MomoRC-tech/Becker-AR6201-to-OpenSoar/cad/reference/README.md

# CAD downloads and credits

Download the component models and check their original sources and reuse terms before sharing them.

| Model | Creator or supplier and original source | Reuse |
| --- | --- | --- |
| [AMASS XT30U, XT30PB and XT30PW](amass-xt30-family/README.md) | PENNEL Patrice · [GrabCAD](https://grabcad.com/library/amass-xt30-connector-family-xt30u-xt30pb-xt30pw-1) | GrabCAD guidance below |
| [ESP32-DevKitC V4](esp32-devkitc-v4/README.md) | Andrei Golyakov · [GrabCAD](https://grabcad.com/library/esp32-devkitc-v4-1) | GrabCAD guidance below |
| [MINI MAX3232 RS-232 module](rs232-uart-ttl-mini-max3232/README.md) | Yuriy B · [GrabCAD](https://grabcad.com/library/rs232-uart-ttl-mini-max3232-1) | GrabCAD guidance below |
| [Hobbywing UBEC 3A MAX 5A](ubec-hobbywing-3a/README.md) | Vinícius Leite · [GrabCAD](https://grabcad.com/library/hobbywing-ubec-3a-max-5a-1) | GrabCAD guidance below |
| [Standalone AMASS XT30U-M](xt30u-m/README.md) | [MuratovAS’s KiCadLibrary](https://github.com/MuratovAS/KiCadLibrary/blob/ba6956a3ba9bc0938dced1b2eb1ae00a33c9a255/MAS_3DModel/xt30u-m.step) | [Apache 2.0](xt30u-m/LICENSE) |
| [DIN0204 axial resistors](kicad-din0204/README.md) | KiCad community · [Resistor_THT library](https://kicad.github.io/packages3d/Resistor_THT.html) | [CC BY-SA 4.0 with the KiCad library exception](kicad-din0204/LICENSE.md) |
| [9-pin D-sub female plug](dsub-9pin/DSUB_9pin_female_plug.STEP) and [straight backshell](dsub-9pin/DSUB_9pin_backshell.STEP) | Manufacturer CAD, renamed and metadata removed; origin: S43 and S52 in [sources](../../docs/research/sources.md#source-register) | Public redistribution permission unverified |
| [MAX490 RS-422 module](rs422-to-ttl-max490/README.md) | Project model based on reference photos | See the model notes for its intended use |

For non-commercial public sharing, GrabCAD asks you to credit the creator and link to the original model. Commercial use requires the creator’s explicit permission. [GrabCAD sharing guidance](https://help.grabcad.com/article/246-how-can-models-be-used-and-shared)
