MomoRC-tech/Becker-AR6201-to-OpenSoar/cad/reference/ubec-hobbywing-3a/README.md

# Hobbywing UBEC 3A MAX 5A

Unmodified model by **Vinícius Leite**, supplied by the project owner as `hobbywing-ubec-3a-max-5a-1.snapshot.2.zip`. [Original GrabCAD model](https://grabcad.com/library/hobbywing-ubec-3a-max-5a-1)

- Open the [STEP model](Hobbywing%20UBEC%203A%20MAX%205A.step) in CAD software.
- The SolidWorks part, Parasolid file and preview are also preserved unchanged.
- See [housing](../../../docs/hardware/housing.md#contents) for dimensions and S44 in the [source register](../../../docs/research/sources.md#source-register) for validation.
- [Measured Fusion model](ubec-measured.f3d) adapts Vinícius Leite’s reference for the project owner’s unit. The PCB is 1.6 × 17 × 34 mm and the cover is 5.7 × 15.8 × 31.8 mm (H × W × D). It includes the owner’s final wire and jumper placement.

The original archive contains no license file. [GrabCAD sharing guidance](https://help.grabcad.com/article/246-how-can-models-be-used-and-shared) permits attributed non-commercial public sharing and requires the designer's permission for commercial use.
