MomoRC-tech/Becker-AR6201-to-OpenSoar/cad/reference/amass-xt30-family/README.md

# AMASS XT30 connector family

Six unmodified STEP models from the owner-supplied GrabCAD archive, snapshot 12. Open the STEP file for the connector you want to use in your CAD software.

| Family | Female | Male |
| --- | --- | --- |
| XT30U | [XT30U-F.step](XT30U-F.step) | [XT30U-M.step](XT30U-M.step) |
| XT30PB | [XT30PB-F.step](XT30PB-F.step) | [XT30PB-M.step](XT30PB-M.step) |
| XT30PW | [XT30PW-F.step](XT30PW-F.step) | [XT30PW-M.step](XT30PW-M.step) |

## Attribution and reuse

Third-party CAD models by **PENNEL Patrice**, published on July 24, 2026. [Original GrabCAD listing](https://grabcad.com/library/amass-xt30-connector-family-xt30u-xt30pb-xt30pw-1)

The archive contains no license file. See [GrabCAD's sharing guidance](https://help.grabcad.com/article/246-how-can-models-be-used-and-shared) for non-commercial sharing and commercial permission.
