MomoRC-tech/Becker-AR6201-to-OpenSoar/cad/reference/kicad-din0204/README.md

# KiCad DIN0204 axial resistors

Unmodified horizontal STEP models from the [KiCad Resistor_THT library](https://kicad.github.io/packages3d/Resistor_THT.html), supplied in the project owner's library archive. The KiCad community publishes these files under [CC BY-SA 4.0 with its library exception](LICENSE.md).

- [5.08 mm lead pitch](R_Axial_DIN0204_L3.6mm_D1.6mm_P5.08mm_Horizontal.step)
- [7.62 mm lead pitch](R_Axial_DIN0204_L3.6mm_D1.6mm_P7.62mm_Horizontal.step)
- [Housing layout](../../../docs/hardware/housing.md#contents)
