MomoRC-tech/Becker-AR6201-to-OpenSoar/cad/reference/esp32-devkitc-v4/README.md

# ESP32-DevKitC V4

Unmodified reference model by **Andrei Golyakov**, downloaded from [GrabCAD](https://grabcad.com/library/esp32-devkitc-v4-1) and supplied by the project owner as `esp32-devkitc-v4-1.snapshot.1.zip`.

- Open [`ESP-WROOM-32D-Export/ESP32-WROOM-32D-Assembly.STEP`](ESP-WROOM-32D-Export/ESP32-WROOM-32D-Assembly.STEP) in CAD software.
- All ten archive files are retained unchanged, with their original paths, including the SolidWorks assembly and parts, 3MF and preview.
- Dimensions and suitability: [housing](../../../docs/hardware/housing.md#contents).
- Provenance, checks and archive/STEP hashes: S42 in [sources](../../../docs/research/sources.md#source-register).

## Attribution and reuse

The archive contains no license file. This is third-party content, not an original project design. GrabCAD's [model use and sharing guidance](https://help.grabcad.com/article/246-how-can-models-be-used-and-shared) permits non-commercial public sharing with creator attribution and a link to the original model; commercial use requires the designer's explicit permission. Retain this attribution when sharing these files. No broader license is asserted here.
