MomoRC-tech/Becker-AR6201-to-OpenSoar/cad/reference/rs232-uart-ttl-mini-max3232/README.md

# RS232 UART -TTL, MINI MAX3232

Unmodified reference model by **Yuriy B**, downloaded from [GrabCAD](https://grabcad.com/library/rs232-uart-ttl-mini-max3232-1) and supplied by the project owner as `rs232-uart-ttl-mini-max3232-1.snapshot.10.zip`.

- Open [`RS232_TTL/RS232_TTL.STEP`](RS232_TTL/RS232_TTL.STEP) in CAD software.
- Alternative format: [`RS232_TTL/RS232_TTL.x_t`](RS232_TTL/RS232_TTL.x_t) (Parasolid).
- All five archive files are retained unchanged, with their original paths.
- Dimensions and suitability: [housing](../../../docs/hardware/housing.md#contents).
- Provenance, checks and archive/STEP hashes: S41 in [sources](../../../docs/research/sources.md#source-register).

## Attribution and reuse

The archive contains no license file. This is third-party content, not an original project design. GrabCAD's [model use and sharing guidance](https://help.grabcad.com/article/246-how-can-models-be-used-and-shared) permits non-commercial public sharing with creator attribution and a link to the original model; commercial use requires the designer's explicit permission. Retain this attribution when sharing these files. No broader license is asserted here.
