MomoRC-tech/Becker-AR6201-to-OpenSoar/docs/architecture.md

# Architecture

## Responsibilities and routing

| Component | Responsibility |
| --- | --- |
| OpenSoar | Radio framing, channel conversion, state, responses |
| ESP32 | Counted binary forwarding; separate radio/navigation/diagnostic paths |
| Navigation | Preserve required messages, displays and return traffic |
| Radio interface | ESP32 UART ↔ selected 5 V MAX490 full-duplex RS-422 board. Owner-selected 1 kΩ series resistor on UART RX. GPIO voltage compliance unverified |

[Overview](../README.md#architecture-overview) · [Connections](connections.md)

---

## Hardware proposal — one ESP32

| Item | Selection / status |
| --- | --- |
| Board | AZ-Delivery ESP32 WROOM dev module (owner selection). Verify header positions and regulator limits |
| Navigation | 2 × Hailege H-1-0290 at 3.3 V (S26); continuity and interface checks pending |
| Radio | Selected 5 V MAX490 board (S34). Pinout, termination and ESP32 interface checks open |
| Supply | Nominal 12 V battery → Hobbywing UBEC 3A (2–6S), selected at 5 V → ESP32 → 3.3 V navigation converters (S14, S16). Becker module uses regulated 5 V, subject to BEC output and load checks |
| Routing | Separate UART/device endpoints proposed; return traffic and GPS priority TBD |
| Firmware | Unselected; Yuri first external candidate, AlphaLima basic comparator |
| OpenSoar review baseline | 7.46.26, `b2e745cfddfe0150f6ed7db467ac18c321b38d01`; Becker WIP (S09); installed build unknown |

> [!WARNING]
> Disconnect BEC 5 V before USB powering. The design has no power-selection circuit.

### Pinning and cabling

[Connection tables](connections.md) own GPIOs, equipment pins, power and cabling.

### OpenSoar baseline and pending inputs

[Existing installation](existing-installation.md) records reported equipment and endpoints. [Open items](open-items.md).

---

## Decision record

> [!NOTE]
> Selections record design decisions. Implementation and physical acceptance are tracked separately.

### ADR-00 — repository as project record

One queue: [roadmap](roadmap.md). Requirements: [requirements](requirements.md); missing evidence: [open items](open-items.md); evidence: [sources](sources.md); design: architecture/connections.

### ADR-01 — separate transparent radio path

**Proposed:** one bidirectional radio endpoint; protocol/state in OpenSoar. Selection requires equipment interfaces and routing/resource/license review (WP1–WP3).

### ADR-02 — implementation and reuse baseline

**Open:** firmware selection. [Yuri/basic comparison](reviews/2026-11-08-yuri-bridge.md): Yuri needs exclusive radio ownership, diagnostic isolation and checked bounded writes. DroneBridge remains an alternative; multi-UART capability unverified. Review compatibility, file licenses and reproducible build inputs before reuse. Plan targeted OpenSoar fixes under WP4.

### ADR-03 — new hardware with the existing setup as backup

**Selected:** one ESP32 with separate interfaces, power and harness. Keep the existing hardware, firmware and configuration as backup. Match equipment interfaces before building.

### ADR-04 — selected bench hardware and power path

**Selected:** ESP32, navigation converters and Hobbywing UBEC at 5 V. The 5 V MAX490 board is selected for Becker. UART interface verification remains open. [Wiring and parts](connections.md#parts-list).

> [!IMPORTANT]
> Fuse, reverse-polarity and transient/overvoltage protection are proposed. Parts, ratings and electrical acceptance remain open.
