MomoRC-tech/Becker-AR6201-to-OpenSoar/docs/hardware/modules.md

# 🧱 Modules and parts

🏠 [Overview](../../README.md) › 🔧 Hardware › **Modules and parts**

The modules the bridge is built from, how to orient them, and the shopping list for one bridge.

> [!NOTE]
> **Status:** all modules selected. Electrical specs come from seller listings or datasheets; physical sizes are recorded in [housing](housing.md#contents). Open checks: [bench hardware](../project/open-items.md#bench-hardware).

📑 **On this page:** <kbd>[1 · 📋 Module overview](#module-overview)</kbd> <kbd>[2 · 🧠 ESP32 board](#esp32-pinout)</kbd> <kbd>[3 · 🔁 RS-232 modules (Zander, FLARM)](#rs232-module)</kbd> <kbd>[4 · 📻 RS-422 board (Becker)](#rs422-board)</kbd> <kbd>[5 · 🔋 Power module (UBEC)](#ubec)</kbd> <kbd>[6 · 🛒 Parts list](#parts-list)</kbd>

Related: 🔌 [Signal wiring](wiring.md) · ⚡ [Power and grounding](power.md) · 📦 [Housing](housing.md) · 📚 [Sources](../research/sources.md)

---

## 1. 📋 Module overview

| Module | Use | Supply | Chip | Size |
| --- | --- | --- | --- | --- |
| [AZ-Delivery ESP32 WROOM dev module](#esp32-pinout) | Bridge controller | 5 V in, 3.3 V on board | ESP32-WROOM-32 | [Measured PCB size](housing.md#contents) |
| [Hailege H-1-0290](#rs232-module) (2×) | RS-232 for Zander and FLARM | 3.3 V | MAX3232CSE | [Measured size](housing.md#contents) |
| [RS-422 board](#rs422-board) | Becker radio | 5 V | MAX490 | 50 × 27 mm |
| [Hobbywing UBEC 3A (2–6S)](#ubec), part 86010010 | 12 V → 5 V | 5.5–26 V in; 5 V or 6 V out (jumper) at 3 A | — | 43 × 17 × 7 mm |

---

## 2. 🧠 ESP32 board

The AZ-Delivery board follows Espressif's DevKitC V4 layout (S32). View from the component side, antenna at the top, Micro-USB at the bottom: J2 is the left header, J3 the right; both are counted from the antenna end. RX and TX are from the ESP32's side.

| Position | J2 label | J2 bridge use | J3 label | J3 bridge use |
| ---: | --- | --- | --- | --- |
| 1 | `3V3` | **3.3 V to RS-232-mod2 R3, then mod1; R-D** | `GND` | — |
| 2 | `EN` | — | `IO23` | — |
| 3 | `VP` | — | `IO22` | — |
| 4 | `VN` | — | `TX` | USB serial (boot only) |
| 5 | `IO34` | — | `RX` | USB serial (boot only) |
| 6 | `IO35` | — | `IO21` | — |
| 7 | `IO32` | **Zander RX** (UART0) | `GND` | **Ground: RS-232-mod2 R4, then mod1; R-B2** |
| 8 | `IO33` | Not connected | `IO19` | — |
| 9 | `IO25` | — | `IO18` | — |
| 10 | `IO26` | **FLARM RX** (UART1) | `IO5` | — |
| 11 | `IO27` | Not connected | `IO17` | **Becker TX** (UART2), R-D to J2-1 |
| 12 | `IO14` | — | `IO16` | **Becker RX** via R-B1 (UART2), R-B2 to J3-7 |
| 13 | `IO12` | — | `IO4` | — |
| 14 | `GND` | **Ground: central GND-J** | `IO0` | — |
| 15 | `IO13` | — | `IO2` | — |
| 16 | `D2` | — | `IO15` | — |
| 17 | `D3` | — | `D1` | — |
| 18 | `CMD` | — | `D0` | — |
| 19 | `5V` | **5 V from central 5V-J** | `CLK` | — |

GPIO16/17 are free only on WROOM boards (WROVER boards use them for PSRAM). D0–D3, CMD and CLK belong to the flash; leave them free. The pin plan avoids the boot strapping pins (GPIO0, 2, 5, 12, 15). [Espressif header tables](https://docs.espressif.com/projects/esp-dev-kits/en/latest/esp32/esp32-devkitc/user_guide.html#header-block)

<details>
<summary><b>🖼️ Show the AZ-Delivery pinout diagram</b> (click to expand)</summary>

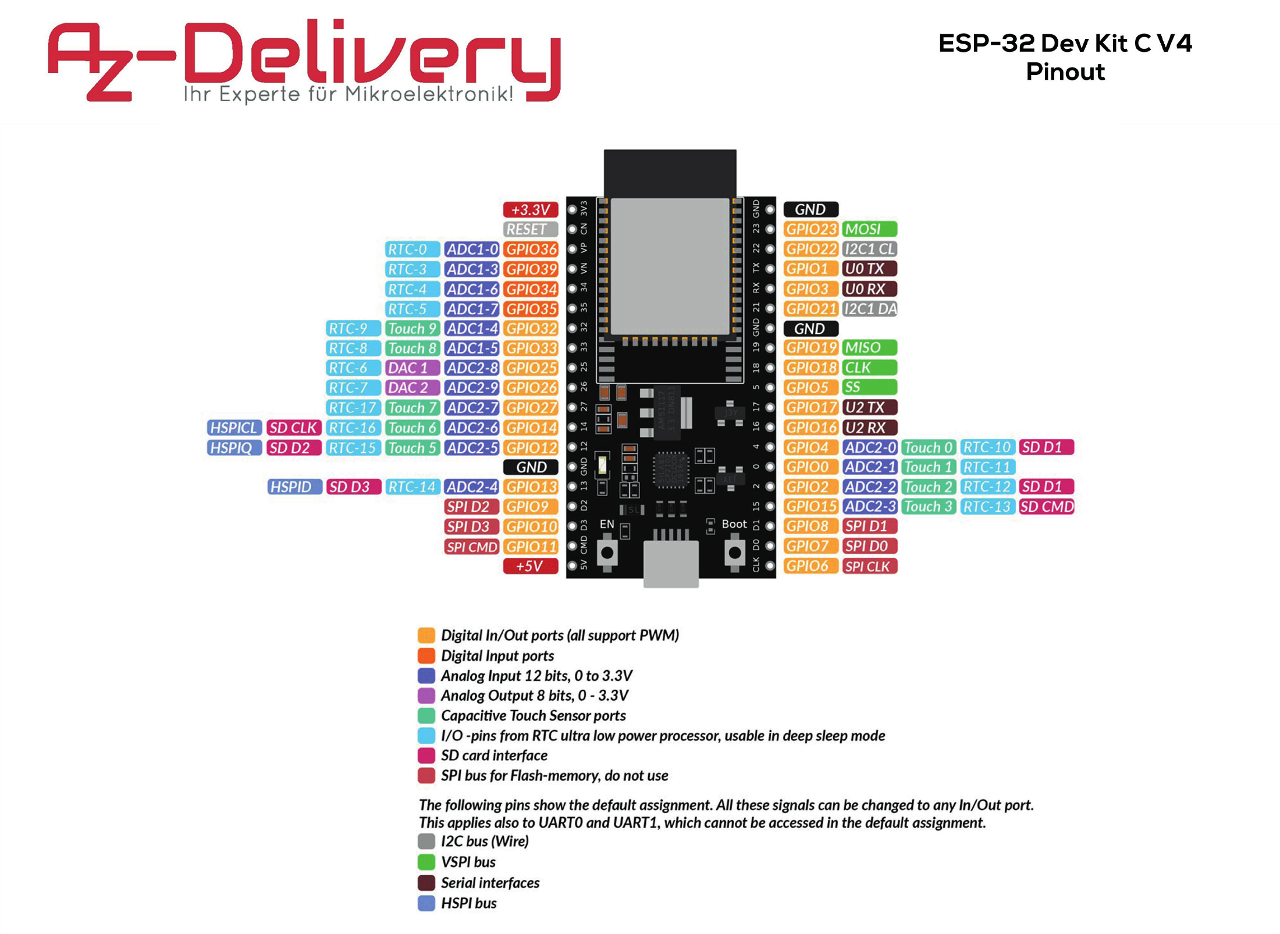
[picture p11: docs/images/esp32-devkitc-v4-az-delivery-pinout.png]
AZ-Delivery ESP32 Dev Kit C V4 pinout, component side with Micro-USB at the bottom


[AZ-Delivery pinout PDF, page 1](https://cdn.shopify.com/s/files/1/1509/1638/files/ESP32_DevKit_C_V4_Pinout.pdf?v=1615364529)

</details>

---

## 3. 🔁 RS-232 modules (Zander, FLARM)

Hailege H-1-0290: a MAX3232 RS-232 ↔ 3.3 V converter with edge pads. The pad map follows the seller image and the matching Sunrom layout (S26, S27). Verify it during [bench bring-up](wiring.md#bring-up).

| Chip side | Pad map |
| --- | --- |
| Hailege H-1-0290 board, chip side | Hailege chip-side pad map. L1 ground, L2 supply, L3 RS-232 input, L4 RS-232 output. R1 TTL input, R2 TTL output, R3 supply, R4 ground. |

> [!IMPORTANT]
> The RS-232 and TTL sides share one 3.3 V net (L2 ↔ R3) and one ground net (L1 ↔ R4). Use R3 and R4 on each board for the [ESP32-fed daisy chain](power.md#supply). Leave L2 and L1 unwired.

---

## 4. 📻 RS-422 board (Becker)

A blue "RS422 TO TTL" board with a 4-pin header (TXD/RXD/GND/VCC) and four screw terminals (Y/Z/B/A), S34. The seller lists a MAX490, 5 V supply, 120 Ω termination and ESD protection.

View from the component side, with the TTL header on the right and the screw terminals on the left.

| Component side | Pin map |
| --- | --- |
| Selected blue RS422 TO TTL board, component side; TTL header at right and screw terminals at left. | RS-422 component-side pin map: right header top to bottom TXD, RXD, GND, VCC; left terminals top to bottom Y output positive, Z output negative, B input negative, A input positive. TXD/RXD are printed labels; RO/DI assignment requires the bench check. |

| Terminal | MAX490 function |
| --- | --- |
| A / B | Receiver input + / − (from the radio's TX2) |
| Y / Z | Driver output + / − (to the radio's RX2) |
| Header RXD / TXD | Receiver output (RO) and driver input (DI); assignment: [bench check](../project/open-items.md#bench-hardware) |
| Header GND / VCC | Bridge ground / 5 V supply |

> [!TIP]
> **Selected:** keep the 5 V board; its receiver output reaches the ESP32 only through a 2.2 kΩ / 3.3 kΩ divider. Details: [Becker wiring](wiring.md#becker).

---

## 5. 🔋 Power module (UBEC)

<table>
  <tr>
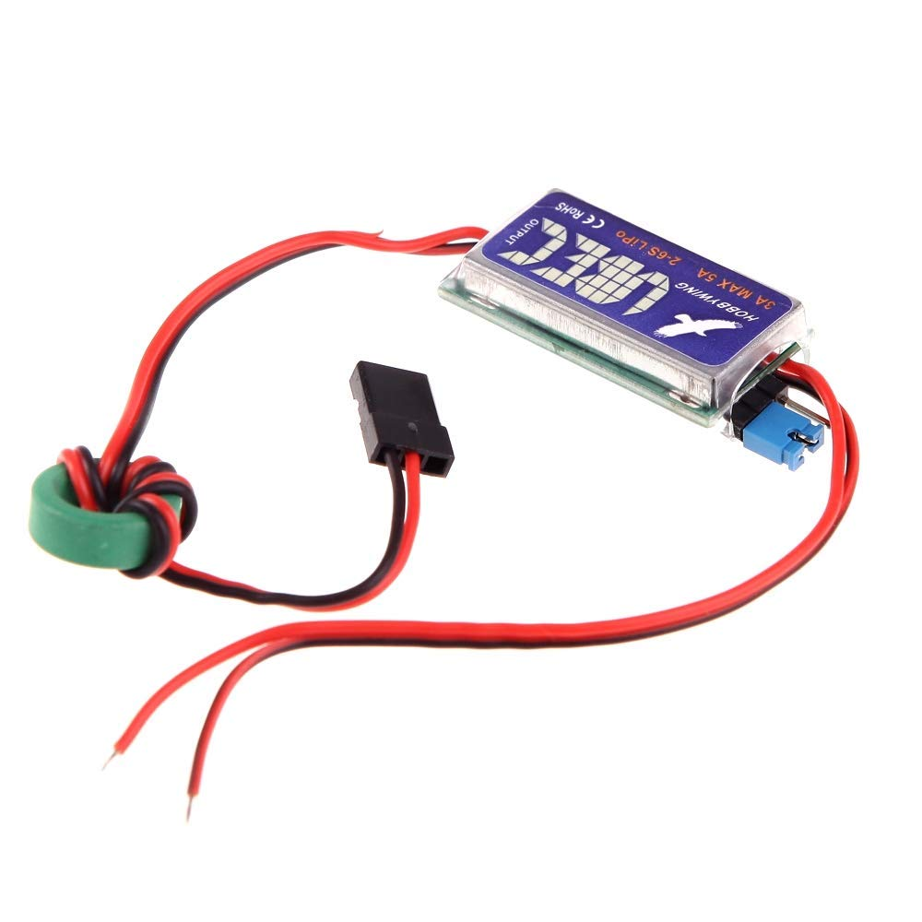
[picture p12: docs/images/hobbywing-ubec-3a-product.png]
Hobbywing UBEC with voltage jumper, ferrite ring and leads
    <td></td>
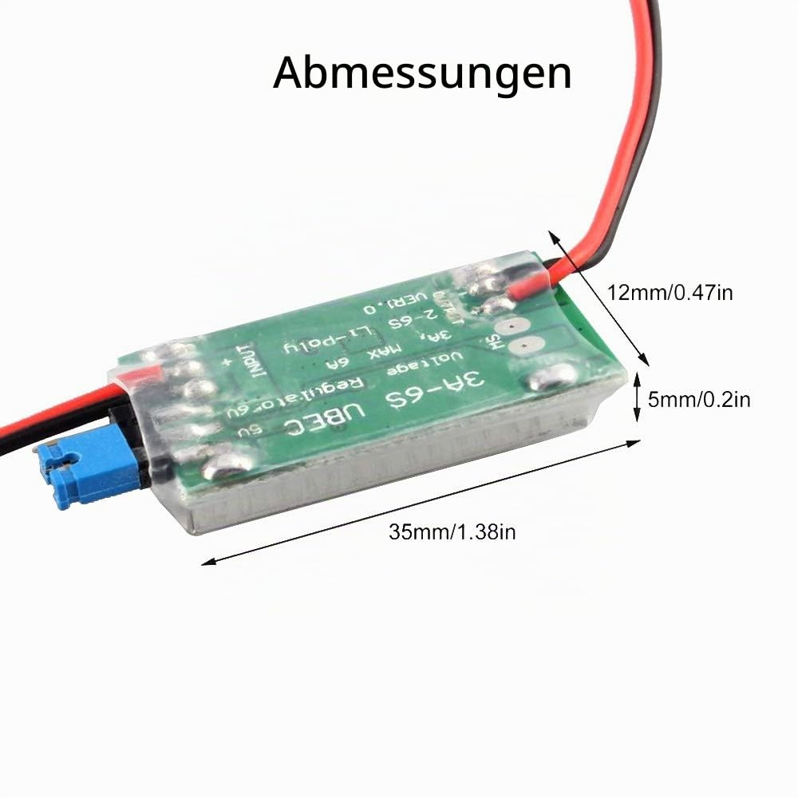
[picture p13: docs/images/hobbywing-ubec-3a-dimensions.png]
Supplied UBEC image annotated 35 × 12 × 5 mm
    <td></td>
  </tr>
</table>

> [!WARNING]
> Set the jumper to 5 V before connecting anything. At 6 V the MAX490 board runs above its 5.25 V supply range (S34), and the RX divider puts 3.6 V on GPIO16, the ESP32's absolute limit.

The manual describes reverse-input protection (S14). Allow space for the jumper, leads and ferrite ring; the body alone is about 35 × 12 × 5 mm in the supplied image, 43 × 17 × 7 mm per the catalog.

---

## 6. 🛒 Parts list

For one bridge, bridge end only — the device-side connectors and harness already exist. The existing bridge stays as a backup.

| # | Ref | Qty | Part | Use |
| :-: | --- | :-: | --- | --- |
| 1 | MCU | 1 | AZ-Delivery ESP32 WROOM dev module | [Pinout](#esp32-pinout) |
| 2 | RS-232-mod1, mod2 | 2 | Hailege H-1-0290 | [Zander](wiring.md#zander), [FLARM](wiring.md#flarm) |
| 3 | RS-422 mod | 1 | MAX490 RS-422 board, 5 V | [Becker](wiring.md#becker) |
| 4 | PS1 | 1 | Hobbywing UBEC 3A (2–6S), 86010010, set to 5 V | [Power](power.md#supply) |
| 5 | R-B1, R-B2 | 1 each | 2.2 kΩ and 3.3 kΩ resistors, 0.125 W | Divider: R-B1 in the RO wire at J3-12, R-B2 across J3-12 and J3-7 |
| 6 | R-Z, R-F | 2 | 10 kΩ resistor, 0.125 W | Pull-up on each RS-232 module, pad R1 → R3 |
| 7 | R-D | 1 | 10 kΩ resistor, 0.125 W | Pull-up J3-11 (GPIO17, DI) → J2-1 (3V3); quiet radio line during boot |
| 8 | F1 | 1 | Supply fuse in an inline holder at the supply end of the 12 V harness; specification tracked in [open items](../project/open-items.md#bench-hardware) | [Power](power.md#supply) |
| 9 | — | existing | Becker harness, reused from its loose bridge-side ends | Check against [Becker wiring](wiring.md#becker); [inventory](../project/existing-installation.md#equipment) |
| 10 | — | 1 pair | Standard XT30 male housing connector and mating female harness connector | [Power](power.md#supply), [mounting](housing.md#connectors) |
| 11 | — | 1 pair | DE-9 male housing connector and female cable connector, solder cups and screw locking, with cable backshell and strain relief | [Combined instrument connector](wiring.md#overview) |

---

<kbd>[⬆️ Back to top](#top)</kbd> <kbd>[🏠 Overview](../../README.md)</kbd>
