MomoRC-tech/Becker-AR6201-to-OpenSoar/docs/hardware/power.md

# ⚡ Power and grounding

🏠 [Overview](../../README.md) › 🔧 Hardware › **Power and grounding**

How the bridge is supplied and grounded, where ground loops close, which currents each wire carries, and what a broken wire does.

> [!NOTE]
> **Status:** bench design. Separate central 5 V/GND distribution and the ESP32-fed RS-232 supply chain are selected; all currents are datasheet values or estimates, nothing is measured yet. Open checks: [bench hardware](../project/open-items.md#bench-hardware).

📑 **On this page:** <kbd>[1 · 🔋 Supply path](#supply)</kbd> <kbd>[2 · ⏚ Grounding and loops](#ground)</kbd> <kbd>[3 · 📊 Current assumptions](#currents)</kbd> <kbd>[4 · ✂️ Wire-break cases](#wire-breaks)</kbd> <kbd>[5 · 🛡️ Protection](#protection)</kbd>

Related: 🔌 [Signal wiring](wiring.md) · 🧱 [Modules and parts](modules.md) · 📚 [Sources](../research/sources.md)

---

## 1. 🔋 Supply path

- **Connector:** standard XT30 — male on the housing, female on the powered harness.
- **Mounting:** printed pocket in the housing → [housing](housing.md#connectors).
- **Existing feed:** about 22 AWG from the 12 V harness, no upstream fuse yet (owner).
- **Fuse:** F1 in the harness at its supply end → [protection](#protection).
- **Open:** connector fit and supply-cable protection → [open items](../project/open-items.md#bench-hardware).

Supply path: UBEC to central 5 V junction, separate branches to ESP32 and MAX490; ESP32 3.3 V to RS-232-mod2 then mod1 and to R-D

| From | To |
| --- | --- |
| UBEC input GND | The common ground point (where the radio's P1-13/25 return, S10), with its own wire |
| UBEC 5 V, after the ferrite | Central **5V-J** junction; separate branches to ESP32 5V ([J2-19](modules.md#esp32-pinout)) and MAX490 VCC |
| UBEC output GND, after the ferrite | Central **GND-J** junction; separate branches to ESP32 GND (J2-14), MAX490 GND and the three instrument signal grounds at the DE-9 |
| ESP32 3V3 ([J2-1](modules.md#esp32-pinout)) | RS-232-mod2 R3 → RS-232-mod1 R3; R-D retains its own local feed |
| ESP32 GND (J3-7) | RS-232-mod2 R4 → RS-232-mod1 R4; R-B2 retains its local J3-7 return |

**5V-J and GND-J are separate insulated junctions.** Keep the UBEC input return on the XT30 input circuit; do not add a wire from GND-J to XT30 minus that bypasses the ferrite output return.

The RS-232 boards are daisy-chained physically and connected **in parallel electrically**, at **3.3 V**. Feed the nearer module (mod2), then link R3 to R3 and R4 to R4 across to mod1. Their ground comes from the ESP32, not from an additional branch to GND-J. Do not add a separate MAX490-to-ESP32 ground wire or instrument-ground wires to RS-232 L1. This gives one internal ground tree; it does not remove the external loops in [section 2](#ground).

Internal ground tree: GND-J branches to ESP32, MAX490 and the three instrument grounds; ESP32 J3-7 feeds mod2 R4 and then mod1 R4; R-B2 remains local

Keep supply and return runs alongside one another where practical. Junction placement and the provisional routing envelopes: [housing](housing.md#internal-routing). Actual junction hardware, conductor sizes and physical fit: [open items](../project/open-items.md#housing).

> [!WARNING]
> Never connect USB and the UBEC 5 V at the same time: the board has no power selection. Unplug the UBEC before using USB.

> [!WARNING]
> Unplug the combined instrument connector whenever USB is connected. Do not rely on a defined interface power or output state during USB connection and boot. A laptop on its mains charger can also put leakage voltage on the USB ground, which would reach the radio through J1-21.

---

## 2. ⏚ Grounding and loops

Treat the UBEC's input and output ground as connected, which is usual for this kind of regulator ([bring-up](wiring.md#bring-up) step 1 checks it). The bridge ground, the battery minus and the devices' signal grounds are then one circuit. Run the bridge's supply ground to the same ground point as the radio's supply ground, with a solid crimped or screwed connection.

J1-21 connects directly to GND-J, without a series resistor. Each loop is closed by a signal ground: every device has its own supply ground to the ground point, and its signal ground to the bridge adds a second, parallel path back to that point.

Power and ground loops: battery, bridge and the three devices; supply grounds meet at the common ground point, and the dashed signal grounds to the Becker, Zander and FLARM close Loop B, Loop Z and Loop F

| Loop | Closed by signal ground | Path | What flows in normal operation |
| --- | --- | --- | --- |
| Loop B (Becker) | J1-21 (D_GND) | Bridge GND → J1-21 → radio → P1-13/25 → ground point → bridge ground wire | A share of the radio's return current: about 14 mA receiving, about 0.2 A transmitting ([estimate](#currents)) |
| Loop Z (Zander) | ZS1 pin 5 | Bridge GND → ZS1 pin 5 → Zander supply ground → ground point | A small share of the Zander's supply current |
| Loop F (FLARM) | FLARM pins 7/8 | Bridge GND → FLARM pins 7/8 → FLARM supply ground (the same pins inside the FLARM, S23) → ground point | A small share of the FLARM's supply current |

The Becker cable shield is connected at the radio end only (J1-11) and the phone link is Wi-Fi, so neither forms a loop. Keep the device cables close to the bridge's power leads so the loops enclose little area.

---

## 3. 📊 Current assumptions

Datasheet values carry their source ID; everything else is an estimate until the bench measurements in [open items](../project/open-items.md#bench-hardware) replace it.

| Branch | Wire | Normal | Peak | Worst single break | Basis |
| --- | --- | --- | --- | --- | --- |
| Bridge +12 V feed (F1, harness, XT30, UBEC input) | About 22 AWG (owner) | ~0.15 A | Switch-on inrush, not measured | Short circuit, limited by F1 | Estimate |
| UBEC 5 V → ESP32 | Board header | ~250 mA | ~500 mA (Wi-Fi) | — | Typical datasheet values |
| UBEC 5 V → MAX490 board | Board header | ~30 mA | — | — | Typical datasheet value |
| ESP32 3.3 V → RS-232 modules, pull-ups | Board header | A few mA | — | — | Estimate |
| Bridge ground wire | Not yet selected | ~0.15 A + radio share | ~0.35 A while the radio transmits | ~3.2 A if the radio's P1 ground breaks | Estimate, S10 |
| J1-21 | Becker harness (gauge open) | ~14 mA radio share | ~0.2 A while the radio transmits | Up to 3 A if the radio's P1 ground breaks | Estimate, S10 |
| Zander pin 5 | Zander harness (gauge open) | Small share | — | The Zander's supply current | Not given in the ZS1 handbook (S22) |
| FLARM pins 7/8 | FLARM cable | Small share | — | The FLARM's supply current, below 500 mA | FLARM fuse requirement (S23) |
| Radio supply (P1-11/12, 13/25) | AWG 20 (Becker requirement) | 140 mA receiving | 1.8 A transmitting, 3 A maximum at 13.75 V | — | S10 |
| FLARM supply | Own fused feed | Below 500 mA | — | — | Must be fused at 500 mA, 8–26 V DC (S23) |
| Zander supply | Own feed | Not given | — | — | S22 |

The bridge load at 5 V adds up to about 0.3 A. At 12 V, assuming about 85 % UBEC efficiency:

```math
I_{12\text{ V}} \approx \frac{5\text{ V} \times 0.3\text{ A}}{12\text{ V} \times 0.85} \approx 0.15\text{ A}
```

The radio share assumes 1–1.5 m wires: two AWG 20 radio supply grounds against an AWG 24 J1-21 wire plus an AWG 22 bridge ground wire. Current divides by conductance, so roughly a tenth of the radio's return current takes the path through the bridge.

---

## 4. ✂️ Wire-break cases

What a single broken wire does:

| Broken wire | Effect | Risk |
| --- | --- | --- |
| Radio supply ground (P1-13/25) | The radio's whole return current, up to 3 A (S10), flows through J1-21, GND-J, the UBEC ground path and the bridge ground wire. The radio keeps working. | 🔴 Overheated wiring; see the warning below |
| Bridge supply ground | The bridge's ~0.15 A returns through J1-21 and the Zander and FLARM grounds. The bridge keeps working. | 🟡 Low; bring-up step 7 catches a poor connection |
| Zander or FLARM supply ground | That device's supply current returns through its RS-232 ground and the bridge. | 🟡 Low; small currents |
| Bridge +12 V or F1 | The bridge switches off; its unpowered interfaces do not feed the devices. | 🟢 None |
| One signal ground (J1-21, Zander, FLARM) | The link stays referenced through the supply grounds. | 🟢 None |

> [!WARNING]
> The direct J1-21 wire depends on the radio's own supply ground. If P1-13/25 lost their connection, up to 3 A of radio current would run through the instrument-ground wiring, junction and UBEC return path without any visible symptom. Size and verify the whole return path for this case; an internal ground junction does not provide isolation. Make sure both P1 ground pins are wired to the ground point and check them before connecting the bridge ([bring-up](wiring.md#bring-up) step 7).

---

## 5. 🛡️ Protection

> [!TIP]
> **Selected:** F1 in an inline fuse holder in the 12 V harness, at its supply end, so it protects the harness and the bridge. The housing has no fuse holder: a panel holder does not fit behind the connector wall ([housing layout](housing.md#layout)). The UBEC also has reverse-input protection (S14). Holder, fuse format and rating: [open items](../project/open-items.md#bench-hardware).

> [!WARNING]
> The wire between the supply connection and F1 is unprotected. Fit F1 directly at the supply connection and keep that wire as short as possible; agree the supply-cable details before connecting the bridge to the aircraft supply.

Size F1 using the measured running current and switch-on inrush, the wire's allowable current and the fuse's time-current curve and DC interrupting rating ([fuse selection, S31](../research/sources.md#source-register)). The load estimate alone does not establish a fuse rating.

---

<kbd>[⬆️ Back to top](#top)</kbd> <kbd>[🏠 Overview](../../README.md)</kbd>
