MomoRC-tech/Becker-AR6201-to-OpenSoar/docs/design/architecture.md

# 🏗️ Architecture

🏠 [Overview](../../README.md) › 🧩 Design › **Architecture**

How the bridge is split up, which hardware is selected, and the decisions behind it.

> [!NOTE]
> **Status:** hardware design selected (ADR-04); firmware not selected. Building and testing are tracked in the [roadmap](../project/roadmap.md).

📑 **On this page:** <kbd>[1 · 🧩 Who does what](#responsibilities)</kbd> <kbd>[2 · 🔧 Hardware](#hardware)</kbd> <kbd>[3 · 📝 Decisions](#decisions)</kbd>

Related: 🔌 [Signal wiring](../hardware/wiring.md) · ⚡ [Power and grounding](../hardware/power.md) · 🧱 [Modules and parts](../hardware/modules.md) · 🎯 [Requirements](requirements.md)

---

## 1. 🧩 Who does what

| Component | Responsibility |
| --- | --- |
| 📱 OpenSoar | Understands the radio protocol: builds frames, converts channels, tracks radio state and replies |
| 🧠 ESP32 bridge | Forwards bytes unchanged; keeps radio, navigation and diagnostic traffic on separate paths |
| 📡📈 Navigation | FLARM and Zander send data to the bridge; no return lines to either instrument |
| 📻 Radio interface | ESP32 UART ↔ 5 V MAX490 RS-422 board ([details](../hardware/modules.md#rs422-board)) |

---

## 2. 🔧 Hardware — one ESP32

| Item | Selection |
| --- | --- |
| Board | AZ-Delivery ESP32 WROOM dev module |
| Zander, FLARM | 2 × Hailege H-1-0290 RS-232 modules at 3.3 V |
| Becker | 5 V MAX490 RS-422 board; receiver output to the ESP32 through a 2.2 kΩ / 3.3 kΩ divider |
| UARTs | UART0 (remapped) Zander, UART1 FLARM, UART2 Becker |
| Supply | 12 V battery → supply fuse → Hobbywing UBEC at 5 V → ESP32 and MAX490; ESP32 3.3 V → RS-232 modules |
| Firmware | Not selected — software waits for the hardware. Candidates: [bridge firmware](../research/bridge-firmware.md) |
| OpenSoar review baseline | 7.46.26, `b2e745cfddfe0150f6ed7db467ac18c321b38d01` (S09); the installed build is not known yet |

Pin-by-pin details: [signal wiring](../hardware/wiring.md) and [power and grounding](../hardware/power.md). Today's installation: [existing installation](../project/existing-installation.md).

---

## 3. 📝 Decisions

| ADR | Decision | State |
| --- | --- | --- |
| [ADR-00](#adr-00) | The repository is the project record | ✅ Selected |
| [ADR-01](#adr-01) | Separate, transparent radio path | 🟡 Proposed |
| [ADR-02](#adr-02) | Firmware and reuse baseline | ⏸️ Open |
| [ADR-03](#adr-03) | New hardware; existing setup kept as backup | ✅ Selected |
| [ADR-04](#adr-04) | Bench hardware and power path | ✅ Selected |

### 3.1 ADR-00 — repository as project record

One work queue: the [roadmap](../project/roadmap.md). Requirements live in [requirements](requirements.md), missing information in [open items](../project/open-items.md), evidence in [sources](../research/sources.md), design in this page and the hardware pages.

### 3.2 ADR-01 — separate transparent radio path

**Proposed.** The radio gets its own bidirectional TCP endpoint; all protocol and state handling stays in OpenSoar, and the bridge only forwards bytes. Final selection needs the installed equipment details and the firmware review.

### 3.3 ADR-02 — firmware and reuse baseline

**Open, on hold until the hardware is finished.** Yuri's ESP serial bridge is the first candidate; it needs exclusive radio ownership, separate diagnostics and checked writes ([review](../research/reviews/2026-11-08-yuri-bridge.md)). DroneBridge is an alternative. Check licenses and build inputs before reusing code. OpenSoar driver fixes are planned separately (WP4).

### 3.4 ADR-03 — new hardware, existing setup as backup

**Selected.** One new ESP32 with its own interfaces, power and internal wiring. Reuse the existing Becker and Zander harnesses from their [loose bridge-side ends](../project/existing-installation.md#equipment). Preserve the existing bridge electronics, firmware and configuration as a backup.

### 3.5 ADR-04 — bench hardware and power path

> [!TIP]
> **Selected:**
> - ESP32, two Hailege RS-232 modules and the Hobbywing UBEC at 5 V.
> - Becker: 5 V MAX490 board; receiver output to GPIO16 through a 2.2 kΩ / 3.3 kΩ divider; J1-21 bonded directly (no resistor) to the board ground by a separate wire; bridge supply ground to the radio's supply ground point; cable shield to J1-11 at the radio end only; 10 kΩ pull-up on the driver input so the radio line stays quiet during boot.
> - UART plan: UART0 (remapped) Zander, UART1 FLARM, UART2 Becker.
> - Power protection: supply fuse plus the UBEC's reverse-input protection; [fuse selection](../project/open-items.md#bench-hardware).

Parts: [parts list](../hardware/modules.md#parts-list).

---

<kbd>[⬆️ Back to top](#top)</kbd> <kbd>[🏠 Overview](../../README.md)</kbd>
