MomoRC-tech/Becker-AR6201-to-OpenSoar/docs/sources.md

# Sources and evidence

Every source used, what was checked in it and its limits. Source and test dates identify evidence scope. Hardware validation requires measurements; none exist yet.

[Existing installation](existing-installation.md) · [Open items](open-items.md) · [Reviews](reviews)

## Evidence labels

| Label | Meaning |
|

New evidence records revision/page, date, scope and label. Related drivers are not independent protocol validation.

---

## Source register

| ID | Source / baseline | Checked scope and limits |
| --- | --- | --- |
| S01 | [OpenSoaring AR62xx.cpp, b2e745c](https://github.com/OpenSoaring/OpenSoar/blob/b2e745cfddfe0150f6ed7db467ac18c321b38d01/src/Device/Driver/AR62xx.cpp) | Rechecked Send, constructor/state, framing, receive/parser, registration. Review baseline; installed build unknown. |
| S02 | [Port.hpp, same revision](https://github.com/OpenSoaring/OpenSoar/blob/b2e745cfddfe0150f6ed7db467ac18c321b38d01/src/Device/Port/Port.hpp) | Rechecked binary-span/string_view FullWrite overloads; F02. |
| S03 | [Becker manual catalog](https://becker-avionics.com/manual-instructions-downloads/) | Rechecked 2026-11-08: separate hardware-generation manuals; installed applicability unknown. |
| S05 | [Becker driver research](becker-driver.md), [bridge firmware candidates](bridge-firmware.md); AlphaLima [basic](https://github.com/AlphaLima/ESP32-Serial-Bridge) / [Pro](https://github.com/AlphaLima/ESP32-Serial-Bridge-Pro) | Prior pinned driver/bridge/manual reviews; exact revisions and pages in linked investigation. Confirm model compatibility and file-level reuse permission. |
| S06 | [Bridge firmware candidates](bridge-firmware.md) | Prior candidate reviews; file-level licenses/build compatibility require confirmation. |
| S08 | [Yuri/basic AlphaLima source evaluation](reviews/2026-11-08-yuri-bridge.md) | Rechecked 2026-11-08: pinned sketches, Yuri configuration/license/tree and default-branch histories. Yuri 130f731 has later functional fixes; AlphaLima bb42dc3 has newer documentation only since their shared 2020 revision. See the review for exact references, proposed increments and verification limits; no runtime evidence. |
| S09 | Hardware proposal references: Espressif DevKitC V4 guide, ESP32 datasheet v5.3, ESP-IDF UART guide v6.1; OpenSoar release index and 7.46.26 notes | Checked 2026-11-08; source observations only, not installed-system evidence. [Espressif DevKitC V4 guide](https://documentation.espressif.com/esp-dev-kits/en/latest/esp32/esp32-devkitc/user_guide.html), Header Block and Power Supply Options: GPIO availability, WROOM/WROVER differences, J2 pin 19 (5V), J2 pin 14 (GND), and mutually exclusive supply paths. [ESP32 datasheet v5.3](https://documentation.espressif.com/esp32_datasheet_en.html), GPIO/boot configuration and UART sections; [ESP-IDF UART guide v6.1](https://docs.espressif.com/projects/esp-idf/en/stable/esp32/api-reference/peripherals/uart.html), Introduction and Set Communication Pins: three UARTs and routing. Live documentation; no framework selection implied. [OpenSoar release index](https://opensoar.de/releases/) and [7.46.26 notes](https://opensoar.de/releases/v7.46.26/): review baseline released 2026-10-30, Android artifacts, b2e745cfdd prefix and Becker WIP. Installed build unknown. |
| S10 | [Becker DV14307.03 Issue 06](https://www.becker-avionics.com/wp-content/uploads/00_Literature/6200_Series_IO_en.pdf#page=57) | Rechecked 2026-11-08. Page 57 identifies the rear grounding stud. Section 2.5.3.1, page 58, lists P1 pins 11 and 12 as positive supply and 13 and 25 as supply ground. The installed AR6201 variant and its wiring remain unverified. Rechecked 2026-11-09: pp.16/36 lists AR6201-(022), article 0636.339-910 and reported ETSO designations; pp.1/46 establish software/type-plate applicability; J1 table p.59 rechecked. S21 narrows the candidate manual family; installed hardware/software match remains open. |
| S11 | [Becker driver follow-up](becker-driver.md#other-implementations), checked 2026-11-08 | Pinned OpenSoar, Werner86, LK8000, eku60 and RadioDriver comparisons; functions/revisions in follow-up. PR statements reported. No independent protocol/capture/runtime validation. |
| S12 | [Historical Becker driver comparison and send reproduction](reviews/2026-11-08-becker-send.md) | Rechecked/measured 2026-11-08. PR #189-associated cd818c90 uses counted writes. The current char-pointer call appears in eku60 commit 7a575346 (2024-03-05) and OpenSoar 7.46.26 b2e745cf. A compiled host extraction reproduces truncation and verifies the single-call byte-span correction. See the review for synthetic inputs, method, exact revisions and limits. |
| S13 | Four owner-supplied photos attributed to Tom, received/inspected 2026-11-08: P1 `1000062273.jpg`, P2 `1000062275.jpg`, P3 `1000062274.jpg`, P4 `1000062276.jpg` | Visible labels/assembly only; revisions and capture date unknown. [Findings](existing-installation.md#photo-evidence). Private originals; no electrical/settings/runtime evidence. |
| S14 | [Hobbywing UBEC 3A (2-6S), part 86010010](https://www.hobbywing.com/en/products/ubec-3a-2-6s99), Overview / Specifications (unversioned); [manual HW-SM810DUL-20130412](https://oss.hobbywing.com/pdf/pdfen/UBEC3A2-6S.pdf), p. 1 §§2, 3.4 | Rechecked 2026-11-11: 5.5–26 V input, jumper-selectable 5/6 V at 3 A. Catalog size 43 × 17 × 7 mm. Older manual lists 51 × 16.6 × 8.5 mm and describes reverse-input protection. Confirm dimensions and protection applicability on delivered hardware. S21 reports the existing installation uses this product family; installed variant and output unverified. |
| S15 | Current build constraint; owner-reported | New, separate hardware; existing assembly/firmware/harness preserved as backup. [ADR-03](architecture.md#adr-03--new-hardware-with-the-existing-setup-as-backup). No hardware validation. |
| S16 | New-build ESP32 and power planning; private photo `1000062272.jpg`, inspected 2026-11-08 | AZ-Delivery WROOM-32; Hobbywing UBEC 3A (2–6S) selected at 5 V (owner, 2026-11-11, specs match S14); board-derived 3.3 V. Reported source: nominal 12 V battery. USB/UBEC manually exclusive. Delivered part, jumper/output and source limits unverified. [ADR-04](architecture.md#adr-04--selected-bench-hardware-and-power-path). |
| S17 | [AZ-Delivery Dev Kit C V4](https://www.az-delivery.de/en/products/esp-32-dev-kit-c-v4), Description, live page checked 2026-11-08; [ADI MAX3232](https://www.analog.com/en/products/max3232.html), linked datasheet Rev. 10, pp. 1–2; [TI MAX3232 Rev. O](https://www.ti.com/lit/ds/symlink/max3232.pdf), Pin Configuration and Functions | Board-family reference; MAX3232 16-pin supply/signal functions. ADI PDF download failed; TI pin table used. Exact board netlist and IC authenticity unverified. |
| S19 | [Espressif ESP32 schematic checklist](https://docs.espressif.com/projects/esp-hardware-design-guidelines/en/latest/esp32/schematic-checklist.html), Power Supply; [TI eFuse overview](https://www.ti.com/product-category/power-management/power-protection-switches-controllers/efuses/overview.html), checked 2026-11-08, live documents | ESP32 supply guidance/protection functions; no spare-header-current or BEC-protection evidence. Parts/ratings pending. Rechecked 2026-11-09: [Espressif hardware FAQ](https://docs.espressif.com/projects/esp-faq/en/latest/hardware-related/hardware-design.html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), GPIO voltage-tolerance section: 3.6 V maximum. Inference with S23: connector-only adaptation cannot establish a compatible RS-232-to-ESP32 input. |
| S20 | Becker connector drawing `images/becker-reference-connectors.png`, from [Becker DV14307.03 Issue 06, February 2021, p.57 Fig.18](https://www.becker-avionics.com/wp-content/uploads/00_Literature/6200_Series_IO_en.pdf#page=57) | Rechecked 2026-11-09. Cropped PDF render with original labels: AR62X1/RT62X1 rear connector layout; callouts identify components, not contacts. J1 functions rechecked on p.59. Becker Avionics GmbH holds the drawing copyright. Installed model/revision and wiring unverified. |
| S21 | Tom's equipment/configuration report supplied 2026-11-09; [assessment](reviews/2026-11-09-installation-claims.md) | Reported: AR6201-(022), Classic FLARM IGC series 6, ZS1, TCP endpoints/drivers, 12 V and UBEC 3A 2–6S; separate instrument supplies; no FLARM-to-Zander connection. Existing bridge excludes Becker. No installed settings/measurements verified; private correspondence not published. |
| S22 | Supplied [ZS1 handbook](reference/ZS1_Deutsch.pdf), D3029, 2004-09-16, pp.2/46/48/50; [NMEA supplement](reference/ZS1_NMEA_3037.pdf), program 3037, 2010-10-14, pp.1–2 | Rechecked 2026-11-09: cable reference, fields, changed PZAN3 and conditional baud rates. Original PDFs retained with hashes in assessment. Installed version and latest manufacturer revision unknown; manufacturer site retrieval timed out. Pinout, pp.46/48 visually rechecked: PC-cable DE9 2 TX, 3 optional RMC input, 5 GND. Installed cable/view matching open. |
| S23 | [FLARM download catalog](https://www.flarm.com/de/support/downloads/); [F6/F7/F8/F9 installation manual](https://www.flarm.com/wp-content/uploads/2024/04/FLARM_InstallationManual_D.pdf), v221, 2016-12-18, pp.1/6/7/9; [FTD-012 ICD](https://www.flarm.com/wp-content/uploads/2025/09/FTD-012-Data-Port-Interface-Control-Document-ICD-7.22.pdf), history 7.22, 2025-09-24, pp.2/13/22–27/55–56 | Rechecked 2026-11-09. Classic connector/serial scope; traffic fields and limits. ICD history resolves revision despite stale headers. Documents do not establish installed firmware, port configuration or cable orientation. Pinout, pp.6/7: Power/Data 5 TX, 6 RX, 7/8 GND; reversed IGC numbering, one attached device per port. Installed cable/view matching open. |
| S24 | OpenSoar 7.46.26 source `b2e745cfddfe0150f6ed7db467ac18c321b38d01`: [Zander.cpp](https://github.com/OpenSoaring/OpenSoar/blob/b2e745cfddfe0150f6ed7db467ac18c321b38d01/src/Device/Driver/Zander.cpp), [Parser.cpp](https://github.com/OpenSoaring/OpenSoar/blob/b2e745cfddfe0150f6ed7db467ac18c321b38d01/src/Device/Parser.cpp), [Descriptor.cpp](https://github.com/OpenSoaring/OpenSoar/blob/b2e745cfddfe0150f6ed7db467ac18c321b38d01/src/Device/Descriptor.cpp), [FLARM/Register.cpp](https://github.com/OpenSoaring/OpenSoar/blob/b2e745cfddfe0150f6ed7db467ac18c321b38d01/src/Device/Driver/FLARM/Register.cpp), [FLARM/StaticParser.cpp](https://github.com/OpenSoaring/OpenSoar/blob/b2e745cfddfe0150f6ed7db467ac18c321b38d01/src/Device/Driver/FLARM/StaticParser.cpp), [TrafficDatabases.cpp](https://github.com/OpenSoaring/OpenSoar/blob/b2e745cfddfe0150f6ed7db467ac18c321b38d01/src/FLARM/TrafficDatabases.cpp) | Rechecked 2026-11-09: PZAN1–5 / ZanderDevice::ParseNMEA, NMEAParser::ParseLine/RMC, DeviceDescriptor::ParseNMEA, flarm_driver, ParsePFLAA, TrafficDatabases::FindNameById. [Field assessment](reviews/2026-11-09-installation-claims.md#zander-output-versus-opensoar-consumption). Source inspection only; no code copied or runtime tests. |
| S25 | Two diagrams in supplied correspondence, inspected 2026-11-09; private originals `foqSakC0W5neyf3V.png`, `Bl0kTZs9nJOPvdtL.png` | Zander crop: B2 GND, B3 RX-PC, B4 TX-PC; circled A has RX-SR/TX-SR and other functions. Revision/page/view not established. FLARM sketch: 5 TX, 6 RX, 7/8 GND, consistent with S23 numbering only; not proof of complete installed wiring or 1:1 cable compatibility. |
| S26 | Owner-selected Hailege H-1-0290; supplied product text and [image](images/hailege-h-1-0290-supplied.png), 2026-11-09; listing revision/URL not supplied | Reported: MAX3232CSE, 3–5 V, rates above 120 kbps not recommended, 9.4 × 15.9 mm; shared power on both sides, one supply connection; arrows indicate signal flow, RS232/TTL labels identify levels. Rechecked source: image shows edge pads and 17 × 10 mm annotation; use text dimensions as instructed. IC identity, pad routing, physical dimensions and electrical operation unmeasured. S27 adds an inferred map; original image retained unchanged at owner request. |
| S27 | [Sunrom 4691](https://www.sunrom.com/p/rs232-ttl-module-max3232), [schematic](https://www.sunrom.com/media/content/670/max3232-schematic.gif) Rev. 1, 2016-02-29; [PCB layout](https://www.sunrom.com/media/content/670/max3232-max232-board.jpg), [chip-side photo](https://www.sunrom.com/media/content/670/max3232-level.jpg), [underside](https://www.sunrom.com/media/content/670/max3232-level-conversion.jpg); rechecked 2026-11-09, photos unversioned | Rechecked source: chip-side pad marks, underside RS232/TTL ends, shared power, channel-2 schematic (8 R2IN, 7 T2OUT, 10 T2IN, 9 R2OUT). Inference: S26 appearance matches this layout; [L/R map](module-specs.md#hailege-board-pad-reference) is conditional, not Hailege-certified or measured. Exact Hailege schematic unavailable; Amazon listing retrieval failed. Comparator DB9 wiring is not equipment pinning evidence. |
| S31 | Littelfuse [Fuseology Design Guide](https://www.littelfuse.com/assetdocs/fuseology-selection-guide?assetguid=d812dff2-1c47-4dc3-bce7-07a4001ddc32), ©2022, Fuse Selection Checklist and pulse sections; [ATOF datasheet](https://www.littelfuse.com/assetdocs/littelfuse-datasheet-287-atof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), revision 02/04/2025, pp.1–3; rechecked 2026-11-09 | Rechecked source: selection factors include load, temperature, inrush and fault current. ATOF series rated 32 V DC and 1 kA interrupt at 32 V DC. Bench candidate only. F1 current rating and suitability depend on the actual BEC, source and wiring. |
| S32 | [Espressif ESP32-DevKitC V4 guide](https://docs.espressif.com/projects/esp-dev-kits/en/latest/esp32/esp32-devkitc/user_guide.html#header-block), Header Block/Pin Layout; [schematic](https://dl.espressif.com/dl/schematics/esp32_devkitc_v4_sch.pdf), Rev. V4, 2020-02-25, p.1, J2/J3 and power supply; [AZ-Delivery board listing](https://www.az-delivery.de/en/products/esp-32-dev-kit-c-v4), Description | Rechecked 2026-11-11: WROOM reference headers, power positions and GPIO16/17 module dependency. AZ-Delivery describes a WROOM-32 board with Espressif's layout. Physical board match and regulator capacity remain open. |
| S34 | Owner-selected board, supplied photos and seller text; [MAX490 datasheet](https://www.analog.com/media/en/technical-documentation/data-sheets/MAX1487-MAX491.pdf#page=2), 19-0122 Rev. 10, p. 2; [ESP32-WROOM-32](https://documentation.espressif.com/esp32-wroom-32_datasheet_en.html), v3.8, section 5.3 | Board features reported or visible in photos. Datasheets checked for supply and GPIO limits. No board or radio measurements. |

---

## Findings

Source observations on the OpenSoar AR62xx driver. Details: [Becker driver research](becker-driver.md).

| ID | Observation | Evidence and limit |
| --- | --- | --- |
| F02 | Send ignores msg_size and passes a char pointer to FullWrite; Port offers a string_view overload. | S01 lines 247–265; S02 lines 87–93. Measured host consequence in S12: the actual Send body passes 4/10 or 6/10 bytes for synthetic zero-containing frames. Full deployed-build and physical acceptance remain open. |
| F03 | Send assigns ACK locally after writing; success follows that value. No receive-side assignment/notification implements actual acknowledgment in this driver. | S01 Send and receive methods, especially lines 264–278. Establishes a source defect, not the radio's real acknowledgment format. |
| F04 | The command reads both stored frequencies; the constructor does not initialize them. Reception can update private state. | S01 Radio/radio_para, constructor, SetAR620xStation and AR620xConvertAnswer. Unknown/stale active state is a design risk; physical consequences remain untested. |
| F05 | Parser resets on A5, keeps static state, allows zero received CRC and suppresses conversion while sending. Frequency decoding lacks command-specific length checks. | S01 lines 459–558. Implementation observations; whether any exception is protocol-valid requires independent evidence. |
| F06 | Manufacturer supplies distinct manuals for different hardware generations. | S03. Supports identifying the installed device before choosing connector/settings guidance. |
