MomoRC-tech/Becker-AR6201-to-OpenSoar/docs/research/sources.md

# 📚 Sources

🏠 [Overview](../../README.md) › 🔬 Research › **Sources**

Every source the project relies on: what it is, what was checked in it, and its limits. Other pages cite these IDs (S01, F02 …).

> [!NOTE]
> **Status:** documents and code are reviewed; owner-measured RS-232 and ESP32 PCB dimensions are recorded in S38 and S40. Electrical bench checks are pending. Dated review records: [reviews](reviews).

📑 **On this page:** <kbd>[1 · 🏷️ Evidence labels](#evidence-labels)</kbd> <kbd>[2 · 📋 Source register](#source-register)</kbd> <kbd>[3 · 🔍 Driver findings](#findings)</kbd>

---

## 1. 🏷️ Evidence labels

| Label | Meaning |
| --- | --- |
| Rechecked source | The exact revision or document was inspected; inferences are stated separately. Photos show appearance only. |
| Prior review | A finding kept from an earlier review, not rechecked. |
| Reported | Someone stated it; not independently checked. Owner-reported measurements are identified explicitly. |
| Assumption / proposed | Hypothesis or design, not yet confirmed. |
| Measured | Recorded setup, versions, input and result. Host tests are recorded here; owner-reported physical measurements are identified separately. |

New evidence records the revision or page, the date, what was checked and its label. Other drivers are not independent proof of the protocol.

---

## 2. 📋 Source register

| ID | Source / baseline | Checked scope and limits |
| --- | --- | --- |
| S01 | [OpenSoaring AR62xx.cpp, b2e745c](https://github.com/OpenSoaring/OpenSoar/blob/b2e745cfddfe0150f6ed7db467ac18c321b38d01/src/Device/Driver/AR62xx.cpp) | Rechecked Send, constructor/state, framing, receive/parser, registration. Review baseline; installed build unknown. |
| S02 | [Port.hpp, same revision](https://github.com/OpenSoaring/OpenSoar/blob/b2e745cfddfe0150f6ed7db467ac18c321b38d01/src/Device/Port/Port.hpp) | Rechecked binary-span/string_view FullWrite overloads; F02. |
| S03 | [Becker manual catalog](https://becker-avionics.com/manual-instructions-downloads/) | Rechecked 2026-11-08: separate hardware-generation manuals; installed applicability unknown. |
| S05 | [Becker driver research](becker-driver.md), [bridge firmware candidates](bridge-firmware.md); AlphaLima [basic](https://github.com/AlphaLima/ESP32-Serial-Bridge) / [Pro](https://github.com/AlphaLima/ESP32-Serial-Bridge-Pro) | Prior pinned driver/bridge/manual reviews; exact revisions and pages in linked investigation. Confirm model compatibility and file-level reuse permission. |
| S06 | [Bridge firmware candidates](bridge-firmware.md) | Prior candidate reviews; file-level licenses/build compatibility require confirmation. |
| S08 | [Yuri/basic AlphaLima source evaluation](reviews/2026-11-08-yuri-bridge.md) | Rechecked 2026-11-08: pinned sketches, Yuri configuration/license/tree and default-branch histories. Yuri 130f731 has later functional fixes; AlphaLima bb42dc3 has newer documentation only since their shared 2020 revision. See the review for exact references, proposed increments and verification limits; no runtime evidence. |
| S09 | Hardware proposal references: Espressif DevKitC V4 guide, ESP32 datasheet v5.3, ESP-IDF UART guide v6.1; OpenSoar release index and 7.46.26 notes | Checked 2026-11-08; source observations only, not installed-system evidence. [Espressif DevKitC V4 guide](https://documentation.espressif.com/esp-dev-kits/en/latest/esp32/esp32-devkitc/user_guide.html), Header Block and Power Supply Options: GPIO availability, WROOM/WROVER differences, J2 pin 19 (5V), J2 pin 14 (GND), and mutually exclusive supply paths. [ESP32 datasheet v5.3](https://documentation.espressif.com/esp32_datasheet_en.html), GPIO/boot configuration and UART sections; [ESP-IDF UART guide v6.1](https://docs.espressif.com/projects/esp-idf/en/stable/esp32/api-reference/peripherals/uart.html), Introduction and Set Communication Pins: three UARTs and routing. Live documentation; no framework selection implied. [OpenSoar release index](https://opensoar.de/releases/) and [7.46.26 notes](https://opensoar.de/releases/v7.46.26/): review baseline released 2026-10-30, Android artifacts, b2e745cfdd prefix and Becker WIP. Installed build unknown. |
| S10 | [Becker DV14307.03 Issue 06](https://www.becker-avionics.com/wp-content/uploads/00_Literature/6200_Series_IO_en.pdf#page=57) | Rechecked 2026-11-08. Page 57 identifies the rear grounding stud. Section 2.5.3.1, page 58, lists P1 pins 11 and 12 as positive supply and 13 and 25 as supply ground. The installed AR6201 variant and its wiring remain unverified. Rechecked 2026-11-09: pp.16/36 lists AR6201-(022), article 0636.339-910 and reported ETSO designations; pp.1/46 establish software/type-plate applicability; J1 table p.59 rechecked. Rechecked 2026-11-11: p.59 lists J1-11 SHIELD_2 as the auxiliary control interface shield; p.47 requires the interface lines as 2-core twisted and shielded cables; the manual gives no electrical specification (levels, isolation, termination) for the RS-422 interface; p.57 gives J1 as a 25-pin D-Sub female and P1 as male. p.27: AR62XX-(X2X) draws 140 mA receiving, 1.8 A transmitting at 70 % modulation and 3 A absolute maximum at 13.75 V; RCU62X1 20 mA. p.92: the control head's GND (P1-9) is wired directly to radio D_GND (J1-23). S21 narrows the candidate manual family; installed hardware/software match remains open. |
| S11 | [Becker driver follow-up](becker-driver.md#other-implementations), checked 2026-11-08 | Pinned OpenSoar, Werner86, LK8000, eku60 and RadioDriver comparisons; functions/revisions in follow-up. PR statements reported. No independent protocol/capture/runtime validation. |
| S12 | [Historical Becker driver comparison and send reproduction](reviews/2026-11-08-becker-send.md) | Rechecked/measured 2026-11-08. PR #189-associated cd818c90 uses counted writes. The current char-pointer call appears in eku60 commit 7a575346 (2024-03-05) and OpenSoar 7.46.26 b2e745cf. A compiled host extraction reproduces truncation and verifies the single-call byte-span correction. See the review for synthetic inputs, method, exact revisions and limits. |
| S13 | Four owner-supplied photos attributed to Tom, received/inspected 2026-11-08: P1 `1000062273.jpg`, P2 `1000062275.jpg`, P3 `1000062274.jpg`, P4 `1000062276.jpg` | Visible labels/assembly only; revisions and capture date unknown. [Findings](../project/existing-installation.md#photos). Private originals; no electrical/settings/runtime evidence. |
| S14 | [Hobbywing UBEC 3A (2-6S), part 86010010](https://www.hobbywing.com/en/products/ubec-3a-2-6s99), Overview / Specifications (unversioned); [manual HW-SM810DUL-20130412](https://oss.hobbywing.com/pdf/pdfen/UBEC3A2-6S.pdf), p. 1 §§2, 3.4 | Rechecked 2026-11-11: 5.5–26 V input, jumper-selectable 5/6 V at 3 A. Catalog size 43 × 17 × 7 mm. Older manual lists 51 × 16.6 × 8.5 mm and describes reverse-input protection. Confirm dimensions and protection applicability on delivered hardware. S21 reports the existing installation uses this product family; installed variant and output unverified. |
| S15 | Current build constraint; owner-reported | New bridge electronics; existing bridge electronics, firmware and configuration preserved as backup. Existing Becker and Zander harnesses reused (S36). [ADR-03](../design/architecture.md#adr-03). No hardware validation. |
| S16 | New-build ESP32 and power planning; private photo `1000062272.jpg`, inspected 2026-11-08 | AZ-Delivery WROOM-32; Hobbywing UBEC 3A (2–6S) selected at 5 V (owner, 2026-11-11, specs match S14); board-derived 3.3 V. Reported source: nominal 12 V battery. USB/UBEC manually exclusive. Delivered part, jumper/output and source limits unverified. [ADR-04](../design/architecture.md#adr-04). |
| S17 | [AZ-Delivery Dev Kit C V4](https://www.az-delivery.de/en/products/esp-32-dev-kit-c-v4), Description, live page checked 2026-11-08; [ADI MAX3232](https://www.analog.com/en/products/max3232.html), linked datasheet Rev. 10, pp. 1–2; [TI MAX3232 Rev. O](https://www.ti.com/lit/ds/symlink/max3232.pdf), Pin Configuration and Functions | Board-family reference; MAX3232 16-pin supply/signal functions. ADI PDF download failed; TI pin table used. Exact board netlist and IC authenticity unverified. |
| S19 | [Espressif ESP32 schematic checklist](https://docs.espressif.com/projects/esp-hardware-design-guidelines/en/latest/esp32/schematic-checklist.html), Power Supply; [TI eFuse overview](https://www.ti.com/product-category/power-management/power-protection-switches-controllers/efuses/overview.html), checked 2026-11-08, live documents | ESP32 supply guidance/protection functions; no spare-header-current or BEC-protection evidence. Parts/ratings pending. Rechecked 2026-11-09: [Espressif hardware FAQ](https://docs.espressif.com/projects/esp-faq/en/latest/hardware-related/hardware-design.html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), GPIO voltage-tolerance section: 3.6 V maximum. Inference with S23: connector-only adaptation cannot establish a compatible RS-232-to-ESP32 input. |
| S20 | Becker connector drawing `docs/images/becker-reference-connectors.png`, from [Becker DV14307.03 Issue 06, February 2021, p.57 Fig.18](https://www.becker-avionics.com/wp-content/uploads/00_Literature/6200_Series_IO_en.pdf#page=57) | Rechecked 2026-11-09. Cropped PDF render with original labels: AR62X1/RT62X1 rear connector layout; callouts identify components, not contacts. J1 functions rechecked on p.59. Becker Avionics GmbH holds the drawing copyright. Installed model/revision and wiring unverified. |
| S21 | Tom's equipment/configuration report supplied 2026-11-09; [assessment](reviews/2026-11-09-installation-claims.md) | Reported: AR6201-(022), Classic FLARM IGC series 6, ZS1, TCP endpoints/drivers, 12 V and UBEC 3A 2–6S; separate instrument supplies; no FLARM-to-Zander connection. Existing bridge excludes Becker. No installed settings/measurements verified; private correspondence not published. |
| S22 | Supplied [ZS1 handbook](../reference/ZS1_Deutsch.pdf), D3029, 2004-09-16, pp.2/46/48/50; [NMEA supplement](../reference/ZS1_NMEA_3037.pdf), program 3037, 2010-10-14, pp.1–2 | Rechecked 2026-11-09: cable reference, fields, changed PZAN3 and conditional baud rates. Original PDFs retained with hashes in assessment. Installed version and latest manufacturer revision unknown; manufacturer site retrieval timed out. Pinout, pp.46/48 visually rechecked: PC-cable DE9 2 TX, 3 optional RMC input, 5 GND. Installed cable/view matching open. Rechecked 2026-11-11: the handbook gives no supply current. |
| S23 | [FLARM download catalog](https://www.flarm.com/de/support/downloads/); [F6/F7/F8/F9 installation manual](https://www.flarm.com/wp-content/uploads/2024/04/FLARM_InstallationManual_D.pdf), v221, 2016-12-18, pp.1/6/7/9; [FTD-012 ICD](https://www.flarm.com/wp-content/uploads/2025/09/FTD-012-Data-Port-Interface-Control-Document-ICD-7.22.pdf), history 7.22, 2025-09-24, pp.2/13/22–27/55–56 | Rechecked 2026-11-09. Classic connector/serial scope; traffic fields and limits. ICD history resolves revision despite stale headers. Documents do not establish installed firmware, port configuration or cable orientation. Pinout, pp.6/7: Power/Data 5 TX, 6 RX, 7/8 GND; reversed IGC numbering, one attached device per port. Installed cable/view matching open. Rechecked 2026-11-11, installation manual p.6: supply 8–26 V DC, fused at 500 mA with a direct connection to the aircraft battery; data-port GND pins 7/8 are connected to supply ground pin 4 inside the FLARM. No supply current given. |
| S24 | OpenSoar 7.46.26 source `b2e745cfddfe0150f6ed7db467ac18c321b38d01`: [Zander.cpp](https://github.com/OpenSoaring/OpenSoar/blob/b2e745cfddfe0150f6ed7db467ac18c321b38d01/src/Device/Driver/Zander.cpp), [Parser.cpp](https://github.com/OpenSoaring/OpenSoar/blob/b2e745cfddfe0150f6ed7db467ac18c321b38d01/src/Device/Parser.cpp), [Descriptor.cpp](https://github.com/OpenSoaring/OpenSoar/blob/b2e745cfddfe0150f6ed7db467ac18c321b38d01/src/Device/Descriptor.cpp), [FLARM/Register.cpp](https://github.com/OpenSoaring/OpenSoar/blob/b2e745cfddfe0150f6ed7db467ac18c321b38d01/src/Device/Driver/FLARM/Register.cpp), [FLARM/StaticParser.cpp](https://github.com/OpenSoaring/OpenSoar/blob/b2e745cfddfe0150f6ed7db467ac18c321b38d01/src/Device/Driver/FLARM/StaticParser.cpp), [TrafficDatabases.cpp](https://github.com/OpenSoaring/OpenSoar/blob/b2e745cfddfe0150f6ed7db467ac18c321b38d01/src/FLARM/TrafficDatabases.cpp) | Rechecked 2026-11-09: PZAN1–5 / ZanderDevice::ParseNMEA, NMEAParser::ParseLine/RMC, DeviceDescriptor::ParseNMEA, flarm_driver, ParsePFLAA, TrafficDatabases::FindNameById. [Field assessment](reviews/2026-11-09-installation-claims.md#zander-output-versus-opensoar-consumption). Source inspection only; no code copied or runtime tests. |
| S25 | Two diagrams in supplied correspondence, inspected 2026-11-09; private originals `foqSakC0W5neyf3V.png`, `Bl0kTZs9nJOPvdtL.png` | Zander crop: B2 GND, B3 RX-PC, B4 TX-PC; circled A has RX-SR/TX-SR and other functions. Revision/page/view not established. FLARM sketch: 5 TX, 6 RX, 7/8 GND, consistent with S23 numbering only; not proof of complete installed wiring or 1:1 cable compatibility. |
| S26 | Owner-selected Hailege H-1-0290; supplied product text and [image](../images/hailege-h-1-0290-supplied.png), 2026-11-09; listing revision/URL not supplied | Reported: MAX3232CSE, 3–5 V, rates above 120 kbps not recommended, 9.4 × 15.9 mm; shared power on both sides, one supply connection; arrows indicate signal flow, RS232/TTL labels identify levels. Rechecked source: image shows edge pads and 17 × 10 mm annotation. S38 supersedes listing dimensions for housing design. IC identity, pad routing and electrical operation unmeasured. S27 adds an inferred map; original image retained unchanged at owner request. |
| S27 | [Sunrom 4691](https://www.sunrom.com/p/rs232-ttl-module-max3232), [schematic](https://www.sunrom.com/media/content/670/max3232-schematic.gif) Rev. 1, 2016-02-29; [PCB layout](https://www.sunrom.com/media/content/670/max3232-max232-board.jpg), [chip-side photo](https://www.sunrom.com/media/content/670/max3232-level.jpg), [underside](https://www.sunrom.com/media/content/670/max3232-level-conversion.jpg); rechecked 2026-11-09, photos unversioned | Rechecked source: chip-side pad marks, underside RS232/TTL ends, shared power, channel-2 schematic (8 R2IN, 7 T2OUT, 10 T2IN, 9 R2OUT). Inference: S26 appearance matches this layout; [L/R map](../hardware/modules.md#rs232-module) is conditional, not Hailege-certified or measured. Exact Hailege schematic unavailable; Amazon listing retrieval failed. Comparator DB9 wiring is not equipment pinning evidence. |
| S31 | Littelfuse [Fuseology Design Guide](https://www.littelfuse.com/assetdocs/fuseology-selection-guide?assetguid=d812dff2-1c47-4dc3-bce7-07a4001ddc32), ©2022, Fuse Selection Checklist and pulse sections; [ATOF datasheet](https://www.littelfuse.com/assetdocs/littelfuse-datasheet-287-atof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), revision 02/04/2025, pp.1–3; rechecked 2026-11-09 | Rechecked source: selection factors include load, temperature, inrush and fault current. ATOF series rated 32 V DC and 1 kA interrupt at 32 V DC. Bench candidate only. F1 current rating and suitability depend on the actual BEC, source and wiring. |
| S32 | [Espressif ESP32-DevKitC V4 guide](https://docs.espressif.com/projects/esp-dev-kits/en/latest/esp32/esp32-devkitc/user_guide.html#header-block), Header Block/Pin Layout; [schematic](https://dl.espressif.com/dl/schematics/esp32_devkitc_v4_sch.pdf), Rev. V4, 2020-02-25, p.1, J2/J3 and power supply; [AZ-Delivery board listing](https://www.az-delivery.de/en/products/esp-32-dev-kit-c-v4), Description | Rechecked 2026-11-11: WROOM reference headers, power positions and GPIO16/17 module dependency. AZ-Delivery describes a WROOM-32 board with Espressif's layout. Physical board match and regulator capacity remain open. |
| S34 | Owner-selected board, [supplied component-side photo](../images/rs422-to-ttl-supplied.png) and seller text; [MAX490 datasheet](https://www.analog.com/media/en/technical-documentation/data-sheets/MAX1487-MAX491.pdf#page=2), 19-0122 Rev. 10, p. 2; [ESP32-WROOM-32](https://documentation.espressif.com/esp32-wroom-32_datasheet_en.html), v3.8, section 5.3 | Board features reported or visible in photos. Datasheets checked for supply and GPIO limits. Rechecked 2026-11-11: restored original supplied photo from Git history and visually checked header-at-top orientation: header TXD/RXD/GND/VCC and bottom terminals Y/Z/B/A, both left to right. Generated pin view shows these printed labels without assigning TXD/RXD to DI/RO. Display rotated 90° clockwise using an SVG wrapper around the unchanged supplied photo; pin view matches (header right, terminals left; listed orders now top to bottom). Diagram and side-by-side layout checked in a browser; links and whitespace checked. No board or radio measurements. |
| S35 | [ESP32 Series Datasheet v5.3](https://documentation.espressif.com/esp32_datasheet_en.html), Tables 5-1 and 5-3; [arduino-esp32 esp32-hal-uart.c](https://github.com/espressif/arduino-esp32/blob/master/cores/esp32/esp32-hal-uart.c), `_uartApplyRxPull`; [ESP-IDF v4.4 uart.c](https://github.com/espressif/esp-idf/blob/v4.4/components/driver/uart.c), `uart_set_pin`; [esp32.com thread on clamp diodes](https://esp32.com/viewtopic.php?p=62278) | Checked 2026-11-11 (datasheet values from a text extract, not the PDF table). VIL max 0.25 × VDD, VIH min 0.75 × VDD, internal pull-up about 45 kΩ typical, no injection-current limit given. Arduino-ESP32 enables the RX pull-up by default; ESP-IDF v4.4 does so for GPIO-matrix RX pins. Espressif staff on the forum: 5 V inputs are not supported. Inference: a 10 kΩ series resistor with that pull-up leaves too little logic-low margin; the 2.2 kΩ / 3.3 kΩ divider avoids diode current. Divider values are calculated, not measured. |
| S36 | Owner clarification, 2026-11-11 | Reported: reuse the existing Becker and Zander harnesses; twisted-pair wires and GND wires end loose at the bridge with no bridge-side connectors. Individual conductor identities, wire gauges and shield termination were not supplied. No continuity or physical inspection performed. |
| S37 | TI [The RS-485 Design Guide](https://www.ti.com/lit/an/slla272c/slla272c.pdf), SLLA272D (revised May 2021), section 11 and Fig. 11-1; TI ["When good grounds turn bad — isolate!"](https://www.ti.com/lit/pdf/slyt298), Analog Applications Journal 3Q 2008, pp.12–13 | Checked 2026-11-11. Both treat remote nodes on different power sources: direct ground wires carry loop current; the RS-485 standard's resistors (100 Ω in the figure) reduce it; galvanic isolation is the robust solution. Inference: the bridge and radio share one battery and ground point over a short run, so that case does not apply; the remaining risk is a broken radio supply ground. Current shares are estimates, not measured. |
| S38 | Owner measurement report, 2026-11-11; selected RS-232 boards (Hailege H-1-0290) | Owner reports measured board dimensions of 9.2 × 15.6 mm. Measurement tool, tolerance, board revision and height not supplied; no independent measurement or electrical test performed. |
| S39 | [Espressif DevKitC V4 mechanical drawing](https://dl.espressif.com/dl/schematics/esp32_devkitc_v4_dimensions.pdf), p.1, no visible revision/date; [AZ-Delivery selected board listing](https://www.az-delivery.de/products/esp-32-dev-kit-c-v4), Description; linked [AZ-Delivery datasheet](https://cdn.shopify.com/s/files/1/1509/1638/files/ESP-32_DevKit_C_V4_Datenblatt_AZ-Delivery_Vertriebs_GmbH_24ec770f-c65e-4bd3-92c9-cd64b4d070b8.pdf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), p.5 Specifications | Checked 2026-11-11: visually inspected the mechanical drawing and AZ specification table. Drawing: base PCB 48.26 × 27.94 mm, antenna overhang 6.04 mm, header row centres 25.40 mm, pin pitch 2.54 mm. Calculated length including antenna: 48.26 + 6.04 = 54.30 mm; USB protrusion is shown but not dimensioned. No assembled height or dimensional tolerance given. AZ listing claims the Espressif layout; its specification table gives no dimensions. Reference geometry only; use S40 for the delivered AZ board PCB size. Do not combine the reference antenna overhang with the measured PCB size to infer an exact overall length. |
| S40 | Owner measurement report, 2026-11-11; selected AZ-Delivery ESP32 board | Owner reports measured PCB dimensions of 48.5 × 28.5 mm, excluding the antenna. Measurement tool, tolerance, board revision, overall length including antenna/USB and assembled height not supplied; no independent measurement performed. Supersedes S39 reference PCB dimensions for housing design. |
| S41 | Yuriy B, [RS232 UART -TTL, MINI MAX3232](https://grabcad.com/library/rs232-uart-ttl-mini-max3232-1), published 2025-08-05; owner-supplied snapshot.10 ZIP; [preserved files](../../cad/reference/rs232-uart-ttl-mini-max3232/README.md). STEP AP214 header: SolidWorks 2025, export 2025-08-05T07:13:06 | Checked 2026-11-11: all five extracted files byte-identical to ZIP entries; no license file included. Public GrabCAD model API confirms creator/title; [sharing guidance](https://help.grabcad.com/article/246-how-can-models-be-used-and-shared), updated 2020-10-29, permits attributed non-commercial public use and requires explicit designer permission for commercial use. STEP loaded with cadquery-ocp 8.0.1.1.0, `STEPControl_Reader.TransferRoots` / `OneShape`; millimetre units; 51 solids; `BRepCheck_Analyzer.IsValid` true. `BRepBndLib.AddOptimal` with triangulation and shape-tolerance expansion disabled: assembly bounds X 13.023892–22.623892, Y 8.411832–24.211832, Z −1.652250–1.100000 mm; envelope 9.6 × 15.8 × 2.752250 mm. PCB solid bounds give 9.6 × 15.8 × 1.2 mm; top component projects 1.1 mm above PCB, underside components 0.452250 mm below. Supplied preview inspected. Width/length exceed S38 by 0.4/0.2 mm; reference geometry only, no physical-fit or height validation. Parasolid preserved but not imported. ZIP SHA-256: `0bba0987c2a72940feb6034f40813c7bc5ee27c4f2a15ecf6d7419a57879df29`; STEP SHA-256: `5514ac6e2c38c857542c63a96fef75a6c6169ad8d2a805e00e655b8492985320`. |
| S42 | Andrei Golyakov, [ESP32-DevKitC V4](https://grabcad.com/library/esp32-devkitc-v4-1), published 2021-06-15; owner-supplied snapshot.1 ZIP; [preserved files](../../cad/reference/esp32-devkitc-v4/README.md). STEP AP214 header: SolidWorks 2020, export 2021-06-15T20:34:13 | Checked 2026-11-11: all ten extracted files byte-identical to ZIP entries; no license file included. Public GrabCAD model/file API confirms creator, 38-pin WROOM-32D description and STEP filename. [Sharing guidance](https://help.grabcad.com/article/246-how-can-models-be-used-and-shared), updated 2020-10-29, permits attributed non-commercial public use; commercial use requires designer permission. STEP loaded with cadquery-ocp 8.0.1.1.0, `STEPControl_Reader.TransferRoots` / `OneShape`; millimetre units; 158 solids; `BRepCheck_Analyzer.IsValid` true. `BRepBndLib.AddOptimal` with triangulation and shape-tolerance expansion disabled: assembly bounds X −14.05–14.05, Y −8.89–5.34, Z −30.13–24.73 mm; width/height/length 28.10 × 14.23 × 54.86 mm. First solid (base PCB) bounds X −14.05–14.05, Y 0–1.6, Z −24.13–24.13 mm: length/width/thickness 48.26 × 28.10 × 1.60 mm. Supplied preview inspected: simplified components, two header rows, Micro-USB and projecting antenna. PCB length/width are 0.24/0.40 mm below S40. Geometry and archive checks only; no physical-fit, connector-clearance or electrical validation. SolidWorks and 3MF preserved but not imported. ZIP SHA-256: `750914e78cb8bdb236a3d9a7ed7af860b412d337717f2232578ad59ce75048e1`; STEP SHA-256: `8a710193d6a4d1c04867de47dffe5d084a93cada88745878d49989f5da67dea9`. |
| S43 | NorComp [171 Series](https://www.norcomp.net/series/171?search_part=171-009-202Lyy1), 171-009-203Lyy1 female solder-cup family; [STEP download](https://content.norcomp.net/3d-drawings/step/171-y03series/171-009-203.step.zip); owner-supplied ZIP containing only the STEP file. AP203, SolidWorks 2020 export dated 2022-08-30T13:08:39 | Checked 2026-11-11: imported with cadquery-ocp 8.0.1.1.0, one solid, `BRepCheck_Analyzer.IsValid` true. `BRepBndLib.AddOptimal` without triangulation or tolerance expansion gave X 0–30.80, Y 0–12.60, Z −9.2164–6.0508 mm. CAD geometry only; panel cutout and physical fit were not checked. No redistribution license supplied with the archive. STEP SHA-256: `3eba188dbed8488aae13912caa0e8df2394af0c7cad4fdfbae093e804a54f9a5`. Checked 2026-11-13: stored as [DSUB_9pin_female_plug.STEP](../../cad/reference/dsub-9pin/DSUB_9pin_female_plug.STEP), renamed with metadata removed; DATA section identical except 3 entity names, so the geometry above applies. SHA-256: `6e0d7827d903e44f79d15a010f256af5a83b99b606801bab14f4f2b0bda926c6`. |
| S44 | Vinícius Leite, [Hobbywing UBEC 3A MAX 5A](https://grabcad.com/library/hobbywing-ubec-3a-max-5a-1), published 2026-01-25, owner-supplied snapshot.2 ZIP; [preserved files](../../cad/reference/ubec-hobbywing-3a/README.md) | Checked 2026-11-11: preview shows the regulator, jumper and short wire ends. Open Cascade imported 45 solids and passed geometry validation. Optimal STEP bounds X −12–12, Y −31.3976–23, Z −1.5–8.001 mm. The full envelope differs from the S14 catalog size; exact physical fit was not checked. SolidWorks and Parasolid preserved without import. STEP SHA-256: `d503a728a0d1ebf1d27645be1aad670f3c821245223665eec266a00c7d66e8e8`. |
| S45 | [KiCad Resistor_THT](https://kicad.github.io/packages3d/Resistor_THT.html), owner-supplied library archive; [preserved STEP files](../../cad/reference/kicad-din0204/README.md) and upstream license notice | Open Cascade imported and validated both horizontal DIN0204 models. Optimal bounding boxes including leads, in STEP X/Y/Z order: 5.58 × 1.60 × 4.60 mm (5.08 mm pitch) and 8.12 × 1.60 × 4.60 mm (7.62 mm pitch). Physical resistors were not measured. |
| S46 | Project model of the S34 board, built in Autodesk Fusion through MCP from reference photos and the 50 × 27 mm seller size. Owner export `MAX490 board - CHATGPT.step`, STEP AP214, Autodesk Translation Framework v15.8.0.0, 2026-11-12T00:01:42+01:00. [Repository copy](../../cad/reference/rs422-to-ttl-max490/README.md) | Checked 2026-11-12 with cadquery-ocp 8.0.1.1. Millimetre units, 150 solids, valid B-rep. Bounds measured with `BRepBndLib.AddOptimal` without triangulation or tolerance expansion. See [housing dimensions](../hardware/housing.md#contents). The physical board was not measured. STEP SHA-256: `1e9dbeb584a8ae9eda0130e0974d304e110b0cd73695625568801c5deff490dd`. |
| S47 | Bambu Lab PETG HF: [store page](https://eu.store.bambulab.com/en-ro/products/petg-hf) and a third-party copy of the technical data sheet ([device.report](https://device.report/m/786f742fa054b8cdfea6c523800949d26b5fa3639447ef2cc6199ea0b27ad72e.pdf)) | Checked 2026-11-12 from search excerpts, not the full official PDF: HDT 69 °C at 0.45 MPa (store page and TDS copy), 62 °C at 1.8 MPa and glass transition 66 °C (TDS copy only); annealing not recommended. Reported values. |
| S48 | Bambu Lab ASA technical data sheet V3.0, [copy hosted by polyalkemi.no](https://polyalkemi.no/wp-content/uploads/2024/01/Bambu_ASA_Technical_Data_Sheet.pdf) | Checked 2026-11-12 from search excerpts, not the full PDF: HDT 92 °C at 1.8 MPa and 100 °C at 0.45 MPa, Vicat 106 °C, recommended chamber 45–60 °C. Reported values. |
| S49 | Glider cockpit heat: [rec.aviation.soaring thread](https://groups.google.com/g/rec.aviation.soaring/c/zm9dD8gRT4g) and [enviroliteracy.org article](https://enviroliteracy.org/animals/does-it-get-hot-in-a-glider/) | Checked 2026-11-12 from search excerpts: a club report of instrument panels burnt by focused sunlight through an open canopy; a general estimate of 11–17 °C above ambient in a sunny cockpit. Anecdotal; no measured cockpit temperatures found. |
| S50 | ruthex insert assortment card, batch 09/2020; owner photo, 2026-11-12 | Read from the photo: RX-M3x5.7 (100 pcs in the owner's box); M3 row: Ød1 4.6, Ød2 3.9, hole Ød3 4.0, length L 5.7, minimum wall w 1.6 mm; blind or through hole, depth at least L + 1 mm. Owner-reported; inserts not measured. |
| S51 | MuratovAS, [KiCadLibrary](https://github.com/MuratovAS/KiCadLibrary) @ ba6956a, `MAS_3DModel/xt30u-m.step` (AMASS XT30U-M); STEP AP214 header: FreeCAD / Open CASCADE 7.6, 2024-04-09; repository license Apache-2.0; [preserved file](../../cad/reference/xt30u-m/README.md) | Checked 2026-11-11: downloaded at that commit; repository `LICENSE` is Apache-2.0, copied unchanged next to the model. Model creator and source drawing not stated in the repository. STEP loaded with cadquery-ocp, `STEPControl_Reader`; millimetre units; 1 solid; `BRepCheck_Analyzer.IsValid` true. `BRepBndLib.AddOptimal`: envelope 5.25 × 10.45 × 15.50 mm. Cross-sections along Z: body 5.25 × 10.25 mm from Z = 0 to 12.5, rib up to 10.45 mm wide at Z ≈ 9.0–11.0; two solder cups, 2.0 mm diameter, centres 5.0 mm apart, from Z = 12.5 to 15.5. Not compared with an AMASS drawing or with the delivered connector; reference geometry only. SHA-256: `5a9db54cbd6a694a35397b24c91cad0e028381b7e3d724b4fabc02ec0a2e45cb`. |
| S52 | NorComp [973 Series](https://norcomp.net/series/973) 180° straight-entry plastic D-sub backshell, 973-009-010R011 (black UL94 HB plastic, 9-position kit, 4-40 thumbscrews supplied); [STEP download](https://content.norcomp.net/3d-drawings/step/973series/973-009-010R011.step.zip), ZIP containing only the STEP file; AP214, header dated 2008-03-07; [stored file](../../cad/reference/dsub-9pin/DSUB_9pin_backshell.STEP) | Checked 2026-11-13: downloaded from the series page; imported with cadquery-ocp 8.0.1.1.0, 9 solids, `BRepCheck_Analyzer.IsValid` true. `BRepBndLib.AddOptimal` gave X −15.75–15.75, Y −2.81–35.31, Z 0–15.19 mm. CAD geometry only; cable range not checked; not fit-checked against the cable or the housing. No redistribution license supplied with the archive. STEP SHA-256: `17c09f4e570887c103f1e4332a69f0526407596e29ba5407fee7dc405d90d9a8`. Checked 2026-11-13: stored as DSUB_9pin_backshell.STEP, renamed with author, company and part names removed; DATA section identical except 14 entity names, so the geometry above applies. SHA-256: `0872bcdc3707e2eb9b9a04b816eafa4ef1f45d451119eaaa763dae91e33afd87`. |
| S53 | Owner measurements and mounting selections, 2026-11-13; Fusion `Housing body - prototype v1`, carrier and cable-tie fit envelopes; [carrier files](../../cad/housing/ubec-carrier/README.md) | Owner specifies no underside support within 5.5 mm of the UBEC jumper-end PCB edge or 8.0 mm of the output edge, and limits support to 19 mm. Current selection: four shared M2.5 × 12 raised-head screws directly into PETG, 0.4 mm closed floor beneath pilots, two 2.5 mm-wide / approximately 1 mm-thick ties. Owner confirms screw-head Ø4.4 and PCB-hole Ø3.2; approves 0.2 mm outward offsets of carrier holes and pilots, and Ø6.6 posts. PCB/post centres remain X 29.7 / 64.5, Z 10.8 / 32.4; screw axes are Z 10.6 / 32.6. Carrier seats at Y 10.7 bear on PCB top Y 6.1: 4.6 mm thickness and a 6.2 mm stack above the Y 4.5 post tops. A 12 mm screw engages 5.8 mm, ending at Y −1.3; the 6.6 mm-deep pilot ends at Y −2.1, leaving 0.8 mm tip clearance and 0.4 mm to the Y −2.5 outside floor. Minimum post wall is 3.3 − 1.1 − 0.2 = 2.0 mm; nearest shaft-to-PCB-hole margin is (3.2 − 2.5) / 2 − 0.2 = 0.15 mm. Transient Ø4.4 × 2.5 mm heads at Y 10.7–13.2 intersect no assembly body; nominal rear-head gaps to the UBEC are 0.2 / 0.4 mm. Head height remains an allowance, not a measurement. Boolean differences against the pre-edit archive isolate added base material (77.846 mm³) and carrier material (296.614 mm³); neither intersects another body. All 480 other body names, volumes and bounds are unchanged. Existing pocket cuts also affect ESP32-header reference bodies, so those cuts are retained and the legs raised by a separate carrier feature. PCB X 37.4–71.4 and support X 43.65–62.65 give 6.25 / 8.75 mm UBEC end clearance; the body/hood gap remains about 2.0 mm and tie/hood gap 1.0 mm. Prior reference-lettering contacts remain applicable: MAX490 silkscreen 0.025 mm high / about 0.00051 mm³, UBEC underside markings 0.0008 mm / about 0.00621 mm³, tie-to-label relief below 0.001 mm. Tie-head envelopes 4 × 4 × 3 mm are estimates. Base component export returns a failure flag with the same two inherited engraving reference warnings (`INSTR label engraved`, `7-20V label engraved`); reopened geometry matches the live body, and export from the standalone base root succeeds. Engraving regeneration in that standalone archive is not verified. STEP imports each contain one solid and four correctly positioned clearance/pilot holes; base volume differs from live Fusion by −0.013024 mm³ (0.0000458 %), carrier volume agrees to numerical precision. Recompute, reopened archives, native previews and closed print-mesh checks: [verification](../../cad/housing/ubec-carrier/README.md). Full-height legs begin on the print bed, removing the unsupported seat roofs; support-free printing is a geometric expectation. No slicing, print, physical fit, vibration or thermal acceptance performed. |
| S54 | Owner ferrite photo, measurements and cradle selection, 2026-11-13; Fusion `Housing body - prototype v1`; [CAD files and verification](../../cad/housing/housing-body-v1/README.md) | Owner confirms the bare-core dummy dimensions, measures the wound envelope as Ø17.5 outside × 9.5 axial, selects upright mounting in an integral cradle with two 2.5 mm ties, and confirms space for both ties through the wound centre. Photo shows an exposed core sector and wire turns beyond both faces and the outside diameter. The cradle requires that exposed sector downward; the actual winding shape and lead exits are not modelled. Bare core Ø14.2 / Ø8.4 × 5.4; final centre X 83.5, Y 10.0, Z 16.5 mm, bare-core bounds X 80.8–86.2, Y 2.9–17.1, Z 9.4–23.6. The concentric Ø17.5 × 9.5 winding envelope has bounds X 78.75–88.25, Y 1.25–18.75, Z 7.75–25.25: nominal 1.25 mm hood clearance. It intersects no other component; the base and tie paths are excluded from this solid-envelope check because support and tie passage use the exposed core sector and bore. The R7.1 saddle spans 5.8 mm axially; tunnel roofs retain at least 0.9 mm, and the original floor is unchanged. Tie allowances are 1.0 mm thickness and 3 × 4 × 4 mm heads, not measured manufacturer geometry; rear strap X 89.55 leaves 0.45 mm to the wall. Recompute and all 30 new timeline entries pass; nine candidate Boolean checks find no ring/tie collisions with other assembly bodies. All 480 bodies outside the base and ring retain their names, volumes and bounds. Base Boolean difference: 214.431349 mm³ added, zero removed. Reopened assembly: 68 occurrences, 309 timeline items, all 484 body records match live geometry. Reopened base: one solid, 77 timeline items, matching volume/bounds. Component archive export returns the inherited engraving warnings described in S53; export from the standalone root succeeds, without verifying engraving regeneration. STEP: one valid solid, volume 28666.312739 mm³, +0.031011 mm³ (0.000108 %) versus Fusion; seven point checks confirm the tunnels, web, roof, intact floor and seat. Print mesh: 18,097 vertices, 36,230 triangles, closed consistently oriented edges, no degenerate triangles, floor at Z = 0. Slicing, physical winding fit, threadability of the printed tunnels, retention, vibration and loaded temperature were not tested. |
| S55 | Espressif ESP-IDF v5.5 for ESP32, [Wi-Fi API](https://docs.espressif.com/projects/esp-idf/en/v5.5/esp32/api-reference/network/esp_wifi.html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), `esp_wifi_ap_get_sta_list` and `wifi_sta_info_t.rssi`; [Wi-Fi driver events](https://docs.espressif.com/projects/esp-idf/en/v5.5/esp32/api-guides/wifi.html#wifi-event-ap-staconnected), `WIFI_EVENT_AP_STACONNECTED` and `WIFI_EVENT_AP_STADISCONNECTED` | Checked 2026-11-13. An ESP32 acting as the access point can read the average received signal strength (RSSI) for an associated phone and observe joins and departures. This RSSI describes the phone signal received by the ESP32. Availability in the chosen bridge firmware and any end-to-end delivery metric are for WP6 to assess. |
| S56 | [Housing assembly archive](../../cad/housing/housing-body-v1/housing-assembly.f3d), commits `df11a90` and `7ed6e2b`, [original board STEP](../../cad/reference/esp32-devkitc-v4/ESP-WROOM-32D-Export/ESP32-WROOM-32D-Assembly.STEP) (S42), and [layout v4 STEP](../../cad/housing/layout-v4/housing-layout-v4.step) | Checked 2026-11-13. Both STEP files and the `df11a90` archive have 19 full pins and 19 intact plastic spacers per row. In `7ed6e2b`, the UBEC end solder-clearance, raised-head pocket and pocket-mouth cuts included ESP32 header bodies. The first cut shortened 12 pins per row, the second notched four spacers per row, and the third removed more material. In the repaired archive, each cut lists only the UBEC carrier as a participant. Reopen and recompute passed, with the two inherited position warnings (`Position19` and `Position20`). All 76 header bodies match `df11a90` by position, bounds, volume and face count. All 402 other body records match the preceding published assembly. Two-way carrier solid subtraction removed zero volume. Bounding-box filtering and 128 solid intersections found no header penetration into the holder, adjacent assemblies or hood. Wire clearance and physical fit were not tested. |
| S57 | Owner-selected integral ESP32 USB support, 2026-11-13; Fusion `Housing body - prototype v1` and [published base files](../../cad/housing/housing-body-v1/README.md) | Trimmed 681.136 mm³ from the original separate USB screw block. Four local supports connect the original boss, PCB ledge and end stops to the tray floor. Two-way solid subtraction verifies the retained geometry at and above Y 2.6 mm. The PCB ledge stays at Y 4.5 mm and the Ø2.2 blind pilot stays at X 22.8, Z −10.5 mm. Tray volume rises from 28666.282 to 29343.844 mm³ and outside bounds match the prior base. The live tab and publication copy passed recompute and matched all 476 unrelated body records to their respective baselines. The publication copy excludes concurrent UBEC edits. The reopened assembly matches all 477 body records. The standalone base matches volume and face count and retains the two inherited engraving warnings (S53). STEP imports as one valid solid, with eight point checks covering the pilot, PCB ledge, end stops and former foot. The 3MF has 22,225 vertices and 44,486 triangles with closed, consistently oriented edges and the floor at print Z = 0. Physical fit and screw holding were not tested. |
| S58 | Owner-selected USB seating ledge width and end-stop connections, 2026-11-13; live Fusion `Housing body - prototype v1`, saved v55 and reopened local F3D | The flat seating face spans X 28.2–29.7 mm and Z −16.5 to −4.5 mm at Y 4.5 mm (18 mm²). Both webs rise from the floor to Y 2.6 mm. Solid comparison confirms 52.431 mm³ added to the tray and zero removed. The new material has no bounding-box overlap of positive volume with another component. The 476 other body records and all component transforms match the live pre-edit model. Fusion cloud processing completed before export. The reopened archive recomputed and matched all 477 body records and 68 occurrence placements. The two inherited position warnings remain (S56). Physical solder clearance, fit and print results were not checked. |
| S59 | Owner-directed straight/floor cable routing and thinner signal-wire study, 2026-11-14; saved Fusion `Housing body - prototype v1`; [route data](https://github.com/MomoRC-tech/Becker-AR6201-to-OpenSoar/blob/c3bc17b/cad/housing/housing-body-v1/routing-study.json) and [native/export checks](https://github.com/MomoRC-tech/Becker-AR6201-to-OpenSoar/blob/c3bc17b/cad/housing/housing-body-v1/routing-verification.json) | 19 full wire sections, five resistor placeholders and two integral open cable saddles. Power OD 1.5 mm, signal OD 1.0 mm, including insulation; gauges deferred. Centreline lengths measured from Fusion paths; no cutting allowance, service slack or ferrite winding length. Smallest circular centreline radii: power 0.80 mm, signal 0.68 mm; these are model geometry, not accepted bend specifications. Minimum nominal hood gap 0.25 mm at input B; corrected floor 5 V branch clears J3-7 GND by 0.1871 mm. Reviewed intersections are intended terminal/pad, shared-node, own-resistor or own-allowance contacts; no unintended wire/obstacle or separate-net intersections found. All four Ø4.4 mm carrier driver cylinders clear the harness. Final adjacent GPIO joint allowances Ø2.4 mm leave 0.14 mm nominal spacing; allowance pairs do not intersect. All 476 pre-existing bodies outside the base retain volumes/bounds and all pre-existing occurrence transforms match. Base two-way Boolean comparison: 174.904691 mm³ added, zero removed; cuts target only the new guide bodies before joining to Base tray. Owner confirmed the inherited live base, carrier and tie edits may be published. Saved design and cloud completion checked before exports. Reopened assembly recomputes: 73 occurrences, 374 timeline items and 512 matching body records; all references embedded. Only inherited Position19/Position20 warnings remain. Base archive reopens as one solid, 92 timeline items, no reported warnings; initial component export returned false, then standalone root export succeeded. Carrier archive reopens and recomputes as one solid. STEP reimports each contain one solid; volume differences versus Fusion: base −0.019402 mm³, carrier +0.000552 mm³. Base/carrier meshes: 55,702 / 41,364 triangles, closed consistently oriented edges, no degenerate triangles, bed at Z = 0. Native previews inspected. Physical polarity, MAX490 RO/DI assignment, actual ferrite turns, slicing, printed tie passage, maintenance access, wire bends, vibration and thermal acceptance were not verified. |
| S60 | OpenSoar 7.46.26, `b2e745cfddfe0150f6ed7db467ac18c321b38d01`: [G-load InfoBox](https://github.com/OpenSoaring/OpenSoar/blob/b2e745cfddfe0150f6ed7db467ac18c321b38d01/src/InfoBoxes/Content/Other.cpp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), [Android sensors](https://github.com/OpenSoaring/OpenSoar/blob/b2e745cfddfe0150f6ed7db467ac18c321b38d01/src/Device/AndroidSensors.cpp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), [fallback estimate](https://github.com/OpenSoaring/OpenSoar/blob/b2e745cfddfe0150f6ed7db467ac18c321b38d01/src/Computer/BasicComputer.cpp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), [sink rate](https://github.com/OpenSoaring/OpenSoar/blob/b2e745cfddfe0150f6ed7db467ac18c321b38d01/src/Computer/GlideComputerAirData.cpp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), [speed-to-fly](https://github.com/OpenSoaring/OpenSoar/blob/b2e745cfddfe0150f6ed7db467ac18c321b38d01/src/Computer/STF.cpp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), [OpenVario parser](https://github.com/OpenSoaring/OpenSoar/blob/b2e745cfddfe0150f6ed7db467ac18c321b38d01/src/Device/Driver/OpenVario.cpp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), [OpenVario acceleration](https://github.com/OpenSoaring/OpenSoar/blob/b2e745cfddfe0150f6ed7db467ac18c321b38d01/src/Device/Driver/OpenVario.cpp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), [Larus parser](https://github.com/OpenSoaring/OpenSoar/blob/b2e745cfddfe0150f6ed7db467ac18c321b38d01/src/Device/Driver/Larus.cpp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), [G source merge](https://github.com/OpenSoaring/OpenSoar/blob/b2e745cfddfe0150f6ed7db467ac18c321b38d01/src/NMEA/Acceleration.cpp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), [IGC writer](https://github.com/OpenSoaring/OpenSoar/blob/b2e745cfddfe0150f6ed7db467ac18c321b38d01/src/IGC/IGCWriter.cpp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). [FAA Glider Flying Handbook, ch. 4, p. 4-20](https://www.faa.gov/regulations_policies/handbooks_manuals/aviation/glider_handbook/gfh_chapter_4.pdf#page=20), G-Meter. | Source review 2026-11-14. The InfoBox shows current G. Android averages its sensor readings over one second. OpenSoar can estimate G from bank angle and uses G in the polar sink-rate correction and the speed-to-fly calculation. OpenVario `$POV,A` uses the magnitude of two averaged three-axis samples. Larus `$PLARV` reads G directly. Leaving its other measurement fields empty is a parser-based candidate for a G-only feed. Competing measured sources require a priority check. The normal IGC fix writer has no G field. The FAA describes signed minimum and maximum G as standard G-meter functions. Source inspection only. Installed build, source priority in the cockpit and sensor performance were not tested. |
| S61 | Owner-selected central 5 V/GND distribution, ESP32-fed RS-232 daisy chain and wire colors, 2026-11-14; saved Fusion `Housing body - prototype v1`; [routing data](https://github.com/MomoRC-tech/Becker-AR6201-to-OpenSoar/blob/5c8a596/cad/housing/housing-body-v1/routing-study.json), [verification](https://github.com/MomoRC-tech/Becker-AR6201-to-OpenSoar/blob/5c8a596/cad/housing/housing-body-v1/routing-verification.json) | Separate junction envelopes: 5V-J 9 × 2.4 × 2.6 mm at (37, 2, 5.5); GND-J 20 × 2.4 × 2.6 mm at (55, 2, 5.5), X/Y/Z in the housing frame. Main 12/5 V wires use provisional 1.5 mm insulated OD; local RS-232 3.3 V/return and logic leads use 1.0 mm, not selected gauges. The planned internal ground tree has 9 nodes and 8 edges; 5 internal wire sections are modelled and the 3 DE-9 ground branches reserved. No redundant RS-232-to-junction or MAX490-to-ESP32 ground link. Native recompute and full-sweep volume/length checks pass for all 25 wire sections. New-route solid intersections are only intended same-net terminal/lead/envelope contacts; carrier driver cylinders remain clear. The shortened local 3.3 V feed is 47.88 mm; final approach runs beside its return. Minimum new-route hood gap 0.50 mm at the RS-232 ground link; retained 12 V minimum 0.25 mm. All 477 bodies outside the harness and 31 retained harness bodies preserve geometry; four old power sections replaced. Only inherited Position19/Position20 warnings remain. Saved/cloud-complete design exported and reopened: 75 occurrences, 389 timeline items, 520 matching body records; maximum volume/bound differences below 0.001 mm³ / 0.0001 mm. Color evidence comes from UBEC reference faces: input id8 black / id5 red, output id23 red / id20 black; positive output stub cosmetically changed to orange. Physical terminal polarity is not established by these colors. Eight generated SVGs parsed and offline renders inspected; browser local-file preview was blocked by URL policy. Junction hardware/mounts, actual conductors, ferrite winding, DE-9 pin assignment, solder joints, service slack, physical access and electrical/thermal/vibration acceptance remain outside these synthetic checks. |
| S62 | XT30 and RS-232 CAD pad corrections, 2026-11-14; molded XT30 +/− marks, RS-232 CAD pad marks/centers and S26/S27 inferred signal map; [XT30 detail](../../cad/housing/housing-body-v1/preview-xt30-polarity.png), [RS-232 marks](../../cad/housing/housing-body-v1/preview-rs232-marks.png), [corrected pads](../../cad/housing/housing-body-v1/preview-rs232-pads.png), [route data](https://github.com/MomoRC-tech/Becker-AR6201-to-OpenSoar/blob/9b3d05c/cad/housing/housing-body-v1/routing-study.json), [checks](https://github.com/MomoRC-tech/Becker-AR6201-to-OpenSoar/blob/9b3d05c/cad/housing/housing-body-v1/routing-verification.json) | XT30 square-end + route endpoint (14, 7.5, −17.93) mm now joins red UBEC input id5 at (35.4, 10.2, 26.5); chamfered-end − at (14, 7.5, −12.93) joins black id8 at (35.4, 10.2, 23.5). Lengths 100.68 / 98.94 mm. RS-232 power and ground had been on the opposite signal row: corrected R3/R4 row Z −17.327 mm, Y 15.05 mm. Board 1 positive/ground X 32.837 / 35.506 mm; board 2 X 45.312 / 47.981 mm. All six supply-chain endpoints match measured circular pad centers within 0.001 mm. R-Z/R-F bodies, leads and allowances moved to this row. CAD signal arrows differ from the S26 photo; R1/R2 retain the S26/S27 inferred electrical map, not a new signal assignment. RS-232 ESP32 feeds 35.75 / 34.75 mm, inter-board links 20.89 / 27.84 mm, 3.3 V / GND respectively. All 506 other body volumes/bounds preserve the pre-correction baseline; occurrence placements unchanged. Corrected contacts are only terminal/pad-area, same-net or own-allowance contacts, including less than 0.004 mm³ of approximate PCB/pad overlap per resistor-lead endpoint. No unrelated obstacle/different-net wire intersections or driver-path collisions. Hood minima remain 0.25 mm at XT30 ground and 0.50 mm at the RS-232 ground link. All 25 sweep volume/length checks pass. Saved/cloud-complete export reopens and recomputes: 520 matching bodies, 75 occurrences, 391 timeline items; only inherited Position19/Position20 warnings. Native previews inspected. Physical polarity/continuity, bends and fit were not tested. |
| S63 | Read-only Fusion review, 2026-11-14, `Housing body - prototype v1` v76; [housing assembly](../../cad/housing/housing-body-v1/README.md) and S62 route endpoints | Swapping the connector Z centres (XT30 −15.3 mm, DE-9 +8.5 mm) while retaining each mounting height puts the outer DE-9 jackpost at Y 10, Z −27.8 mm. Fusion classifies samples every 1 mm along its axis from X 4 through 12 mm as inside the base, behind the 3 mm front wall. Translating the XT30 endpoints +23.8 mm in Z reduces straight-line distances to UBEC input points from 49.39 / 42.34 mm to 29.85 / 25.00 mm (+ / return). Both shifted lines intersect the MAX490 terminal housing in a 101-point sample per line. Moving the DE-9 toward the ESP32 would send the two Becker pairs back across toward the MAX490 screw terminals. Exact fan-out lengths depend on pin assignments and bends. Native text sketch heights: front supply 2.16 mm, INSTR 2.4 mm, hood supply 3 mm, WIFI Bridge 4 mm. No replacement harness, physical fit or continuity test. |
| S64 | Fusion `Housing body - prototype v1` v77, 2026-11-14; owner-directed enclosure resize using the live assembly; [CAD and print exports](../../cad/housing/housing-body-v1/README.md), [native checks](../../cad/housing/housing-body-v1/routing-verification.json) | Extended cross-sections of the enclosure solids to lower the floor 3 mm and move the MAX490 wall out 3 mm. Hood and connector seats keep their height. Modules retain height and the MAX490 stack and ferrite move +3 mm in Z. The PCB edge gap grows from 4.45 to 7.45 mm. All 25 wire envelopes clear the enclosure. Sampled volumes under both junction envelopes clear the base and boards. The four Ø4.4 carrier-driver paths clear the modeled harness. Positive overlap at the XT30 press fit and hood supply text is inherited. Reopened assembly recomputes and matches 520 body records within 0.001 mm³ and 0.0001 mm. The two inherited position warnings remain. Base and hood print meshes each have two triangles per welded edge. Adjusted wire solids are clearance envelopes. Final wire bends, service slack, ferrite winding, DE-9 fan-out, fit-print and continuity remain open. |
| S65 | Fusion `Housing body - prototype v1` v79, 2026-11-14; ESP32/RS-232 stack isolation from v78; [standalone archive](../../cad/housing/housing-body-v1/README.md) | The antenna cap and USB clamp each own their installed solid as a local base feature. A rigid as-built joint mounts the stack to the pinned base tray and a rigid group holds the installed stack. The live model matched all 75 occurrence transforms and 520 body fingerprints, including face count, volume, bounds and centroid, against v78. Holder appearances matched and there were zero external document references. The cloud-complete export reopened and recomputed with matching transforms and body geometry within 0.001 mm³ and 0.0001 mm. Only the inherited Position19 and Position20 warnings remain. Compute All can restore the base body's historical name; the saved master and archive use `Base tray`. Physical fit and continuity were outside this check. |
| S66 | Fusion `Housing body - prototype v1` v80, 2026-11-14; MAX490/UBEC stack isolation from v79; [standalone archive](../../cad/housing/housing-body-v1/README.md) | Moved the four existing local occurrences into the stack and added a rigid as-built joint to the pinned tray and a rigid group. The carrier retains its own parametric history. All 75 existing occurrence transforms and 520 solid records matched v79 within 0.001 mm³ and 0.0001 mm, including centroid and bounds, with matching face counts. The ESP32 stack constraints and named parameters matched v79. The cloud-complete export reopened and recomputed with zero external references and only the inherited Position19 and Position20 warnings. Physical fit and continuity were outside this check. |
| S67 | Fusion `Housing body - prototype v1` v80, 2026-11-14; read-only centre-floor clearance study in the assembly frame | Temporary solid box from X 30–68, Y −2.99–0 and Z 2.3–8.7 mm had zero positive-volume overlap with assembly solids after bounding-box filtering. Floor material was present at Y −3.05 mm across that footprint on a 0.5 mm X by 0.2 mm Z sample grid. Extending the same box to X 24 mm at the connector end was clear. The X 68–74 mm box at the ferrite end intersected the base tray (42.82 mm³). The box represents space for the guide. Harness bend paths, filled channel and physical fit were outside this check. |
| S68 | Fusion `Housing body - prototype v1` v80, 2026-11-14; read-only raised-guide clearance study in the assembly frame | A temporary rib box at X 65–68, Y −2.99–6 and Z 7.8–8.7 mm had zero positive-volume overlap with assembly solids. Above the low channel, padding that box by 0.5 mm in X and Z and at the top produced 0.92 mm³ of overlap with the provisional ferrite-to-5V-J wire envelope. A raised wall on the ESP32 side overlaps the PCB and header contacts. Raising the MAX490-side wall along the full channel overlaps both MAX490 power branches. Final wire bend, tolerances and physical fit were outside this check. |
| S69 | Owner routing sketch and live Fusion `Housing body - prototype v1`, based on v80, 2026-11-14; read-only XT30-to-UBEC corridor check | In assembly coordinates (mm), three temporary clearance boxes had zero positive-volume overlap with the base, components and other modelled harness solids: approach X 13–34, Y 9–11, Z 3–7; rise X 29–33, Y 9–15, Z 6–10; crossing X 29–33, Y 12–14, Z 6–24. The existing XT30 pair was excluded from overlap checks. A floor-level box at the same crossing station hit the base. The boxes cover the approach and crossing only. XT30 and UBEC end bends, tool access, wire spacing and physical fit still need checking on a complete two-wire sweep. |
| S70 | Fusion `Housing body - revised power routing` v1, based on v80, 2026-11-14; [standalone archive](../../cad/housing/housing-body-v1/housing-power-routing.f3d) | Six Ø1.5 mm routing envelopes. Solid intersection checks found overlap only at XT30 terminal regions and solder allowances, UBEC input pads, and junction placeholders. The wires clear one another, the base, hood, ferrite, and all four Ø4.4 mm carrier screwdriver envelopes. Compute All returned the inherited Position19 and Position20 warnings. Export reopened with all six updated solids and local board references. Actual wire sizing, bend radii, service slack and winding fit are outside the CAD check. |
| S71 | Fusion `Housing body - revised power routing` v2, 2026-11-14; [standalone archive](../../cad/housing/housing-body-v1/housing-power-routing.f3d) | Updated four wire appearances and the two junction envelopes to use the existing rail colours. Reopened the export and verified both leads of each resistor branch and both junction colours. Solid dimensions, face counts, volumes, centroids and component positions match the prior revision. |

---

## 3. 🔍 Driver findings

Observations on the OpenSoar AR62xx driver; explained in [Becker driver research](becker-driver.md#opensoar-driver).

| ID | Observation | Evidence and limit |
| --- | --- | --- |
| F02 | Send ignores msg_size and passes a char pointer to FullWrite; Port offers a string_view overload. | S01 lines 247–265; S02 lines 87–93. Measured host consequence in S12: the actual Send body passes 4/10 or 6/10 bytes for synthetic zero-containing frames. Full deployed-build and physical acceptance remain open. |
| F03 | Send assigns ACK locally after writing; success follows that value. No receive-side assignment/notification implements actual acknowledgment in this driver. | S01 Send and receive methods, especially lines 264–278. Establishes a source defect, not the radio's real acknowledgment format. |
| F04 | The command reads both stored frequencies; the constructor does not initialize them. Reception can update private state. | S01 Radio/radio_para, constructor, SetAR620xStation and AR620xConvertAnswer. Unknown/stale active state is a design risk; physical consequences remain untested. |
| F05 | Parser resets on A5, keeps static state, allows zero received CRC and suppresses conversion while sending. Frequency decoding lacks command-specific length checks. | S01 lines 459–558. Implementation observations; whether any exception is protocol-valid requires independent evidence. |
| F06 | Manufacturer supplies distinct manuals for different hardware generations. | S03. Supports identifying the installed device before choosing connector/settings guidance. |

---

<kbd>[⬆️ Back to top](#top)</kbd> <kbd>[🏠 Overview](../../README.md)</kbd>
