MomoRC-tech/Becker-AR6201-to-OpenSoar/cad/reference/rs232-uart-ttl-mini-max3232/rs232-uart-ttl-mini-max3232.png

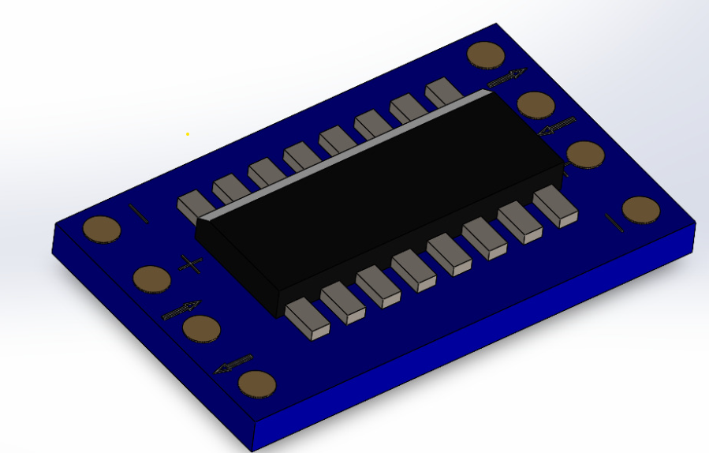
cad/reference/rs232-uart-ttl-mini-max3232/rs232-uart-ttl-mini-max3232.png
