MomoRC-tech/Becker-AR6201-to-OpenSoar/cad/reference/rs232-uart-ttl-mini-max3232/RS232_TTL/RS232_TTL_bottom.JPG

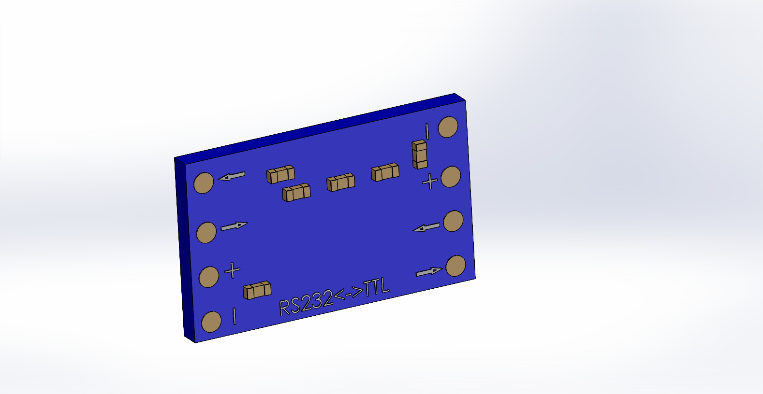
cad/reference/rs232-uart-ttl-mini-max3232/RS232_TTL/RS232_TTL_bottom.JPG
