MomoRC-tech/Becker-AR6201-to-OpenSoar/cad/reference/rs232-uart-ttl-mini-max3232/RS232_TTL_top.JPG

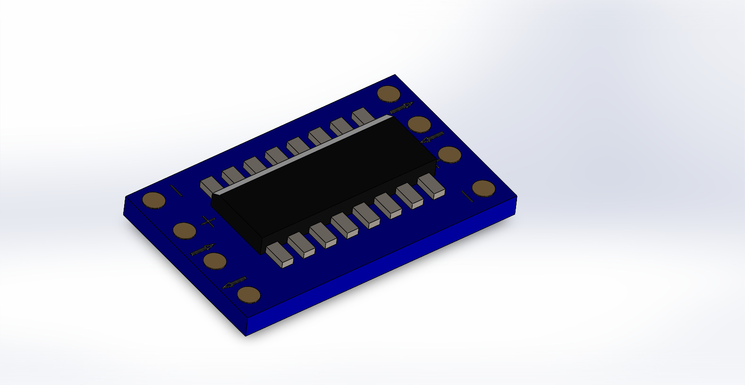
cad/reference/rs232-uart-ttl-mini-max3232/RS232_TTL_top.JPG
