MomoRC-tech/Becker-AR6201-to-OpenSoar/cad/reference/ubec-hobbywing-3a/Captura de tela 2026-01-25 193600.png

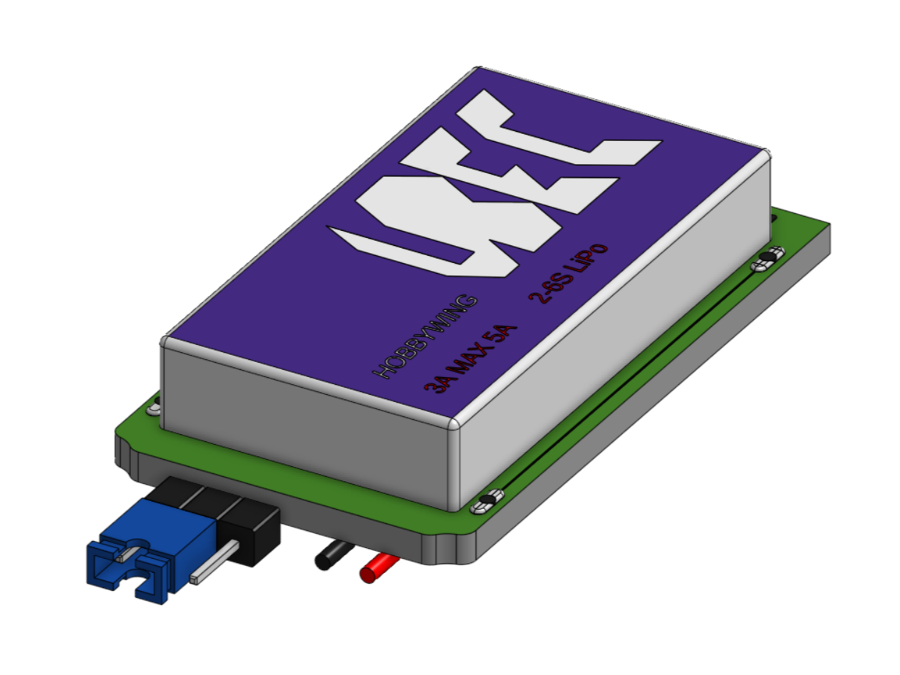
cad/reference/ubec-hobbywing-3a/Captura de tela 2026-01-25 193600.png
