MomoRC-tech/Becker-AR6201-to-OpenSoar/docs/images/hailege-h-1-0290-supplied.png

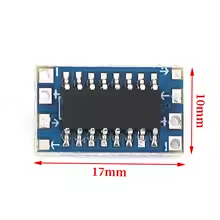
docs/images/hailege-h-1-0290-supplied.png
