MomoRC-tech/Becker-AR6201-to-OpenSoar/docs/images/rs422-to-ttl-supplied.png

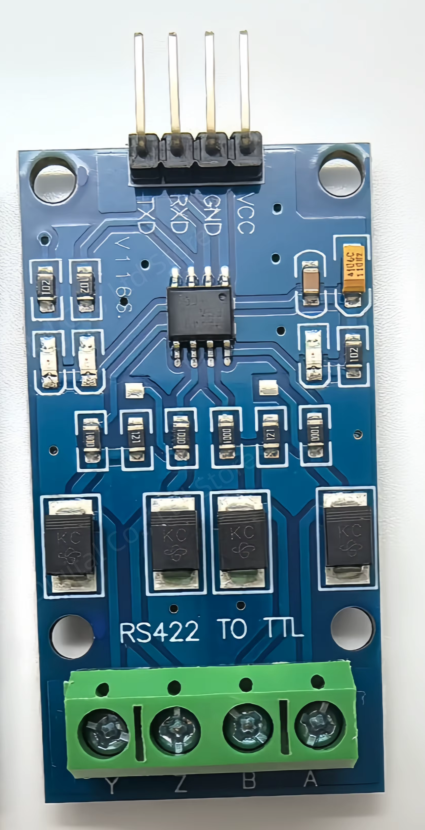
docs/images/rs422-to-ttl-supplied.png
