MomoRC-tech/Becker-AR6201-to-OpenSoar/docs/project/cost.md

# 💶 Hardware cost

🏠 [Overview](../../README.md) › 📋 Project › **Hardware cost**

Cost calculation for one complete bridge using the selected hardware.

> [!NOTE]
> **Status:** budget based on owner-supplied prices on 13 November 2026; shipping excluded.

Related: 🧱 [Modules and parts](../hardware/modules.md#parts-list) · 📦 [Housing](../hardware/housing.md)

---

## 1. 💶 Cost breakdown

All amounts are in EUR; each row is the total for the quantity used in one bridge.

| Component | Cost |
| --- | ---: |
| ESP32 WROOM board | €8.00 |
| RS-232 converters, both | €8.50 |
| MAX490 RS-422 board | €8.30 |
| Hobbywing UBEC 3A | €6.70 |
| **Subtotal: electronics + power** | **€31.50** |
| Resistors | €0.00 |
| Inline fuse holder | €2.50 |
| XT30 connector pair | €1.00 |
| D-Sub connector pair | €2.60 |
| Printed enclosure and holders | €4.00 |
| Heat-set inserts | €0.50 |
| Screws | €0.00 |
| Wire, heat-shrink, etc. | €1.50 |
| **Total hardware** | **€43.60** |

---

## 2. 📋 Calculation scope

- RS-232 price covers both boards together.
- Resistors and screws carry no additional cost in this calculation.
- Existing instrument harness is reused; no replacement cost included.
- Fuse and D-Sub backshell/locking hardware are assumed covered by the listed allowances; no separate amount is added.
- Excludes shipping, tools, labour, prototype reprints and the existing radio, FLARM, Zander and Android device.

---

<kbd>[⬆️ Back to top](#top)</kbd> <kbd>[🏠 Overview](../../README.md)</kbd>
