MomoRC-tech/Becker-AR6201-to-OpenSoar/cad/reference/esp32-devkitc-v4/ESP-WROOM-32D-Export/ESP32-WROOM-32D-Assembly.STEP

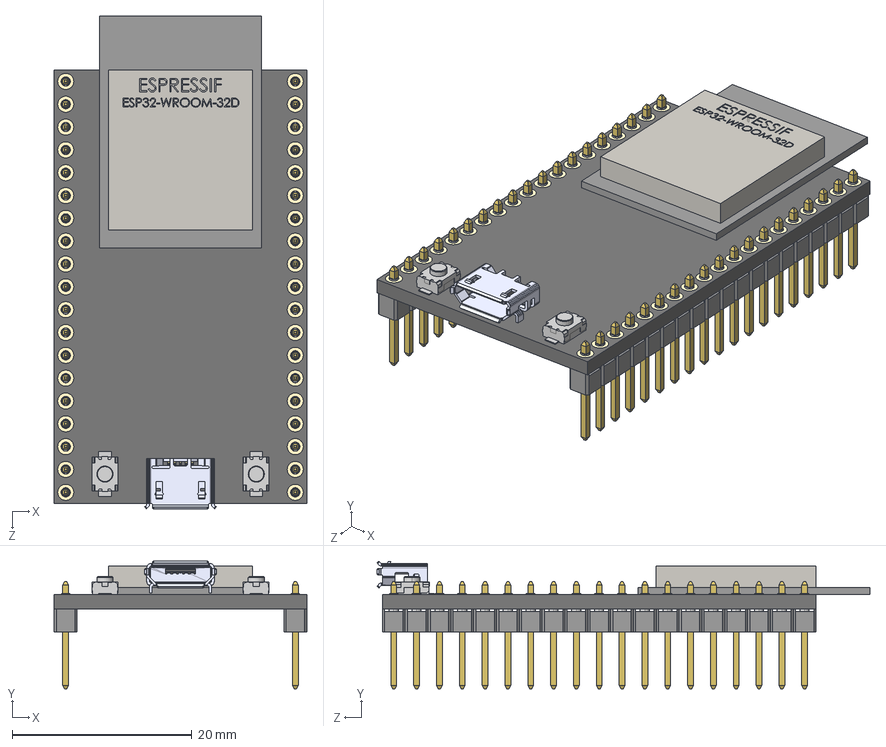
[picture p20: CAD file, 2026-11-11]
cad/reference/esp32-devkitc-v4/ESP-WROOM-32D-Export/ESP32-WROOM-32D-Assembly.STEP
28.1 x 14.2 x 54.9 mm
Main-PCB
zl201-19_p2-54_l48-3_w2-54_h8-9 x 2
Soldering-Contacts
ab2_usb_micro_smd.wrl
ESP32-chip
3x4x2mm_tact_button x 2
