MomoRC-tech/Becker-AR6201-to-OpenSoar/cad/reference/esp32-devkitc-v4/ESP-WROOM-32D-Export/Main-PCB.SLDPRT

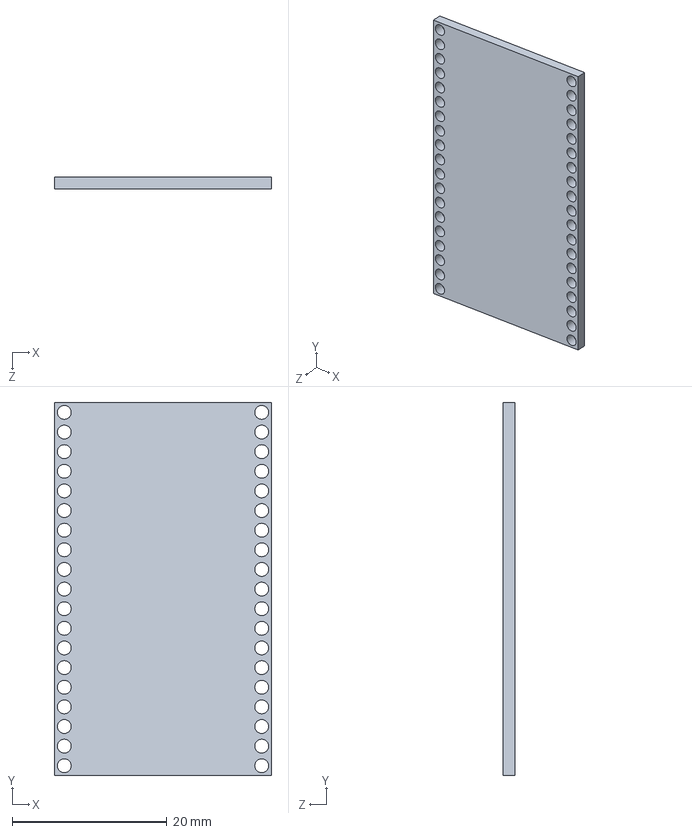
[picture p21: CAD file, 2026-11-11]
cad/reference/esp32-devkitc-v4/ESP-WROOM-32D-Export/Main-PCB.SLDPRT
28.1 x 48.3 x 1.60 mm
