MomoRC-tech/Becker-AR6201-to-OpenSoar/cad/housing/connector-panel/connector-panel.step

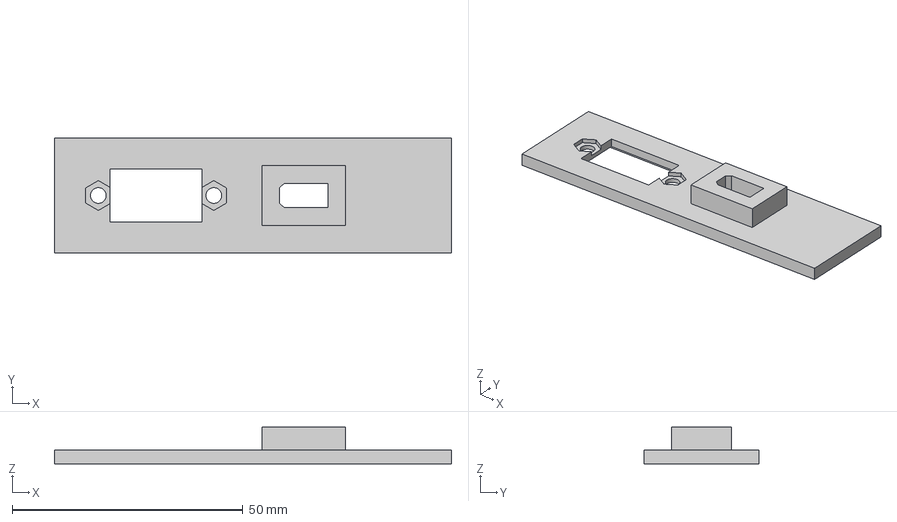
[picture p22: CAD file, 2026-11-12]
cad/housing/connector-panel/connector-panel.step
86.0 x 25.0 x 8.00 mm
