MomoRC-tech/Becker-AR6201-to-OpenSoar/cad/housing/connector-print-test/xt30-print-test.step

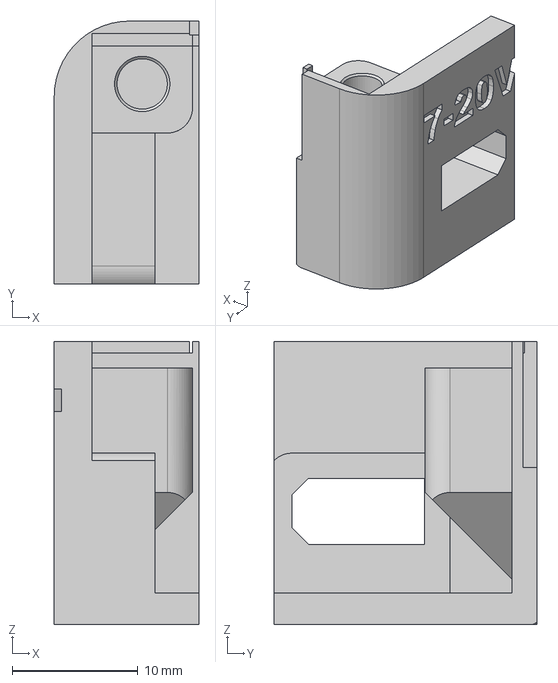
[picture p23: CAD file, 2026-11-13]
cad/housing/connector-print-test/xt30-print-test.step
11.5 x 20.9 x 22.5 mm
