MomoRC-tech/Becker-AR6201-to-OpenSoar/cad/housing/esp32-holder-v3/esp32-holder-v3.step

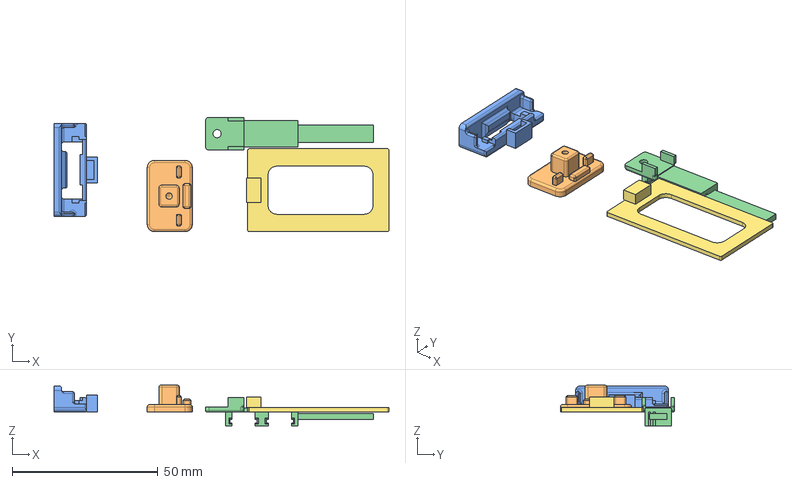
[picture p24: CAD file, 2026-11-12]
cad/housing/esp32-holder-v3/esp32-holder-v3.step
115.0 x 39.3 x 13.9 mm
