MomoRC-tech/Becker-AR6201-to-OpenSoar/cad/housing/housing-body-v1/housing-hood.step

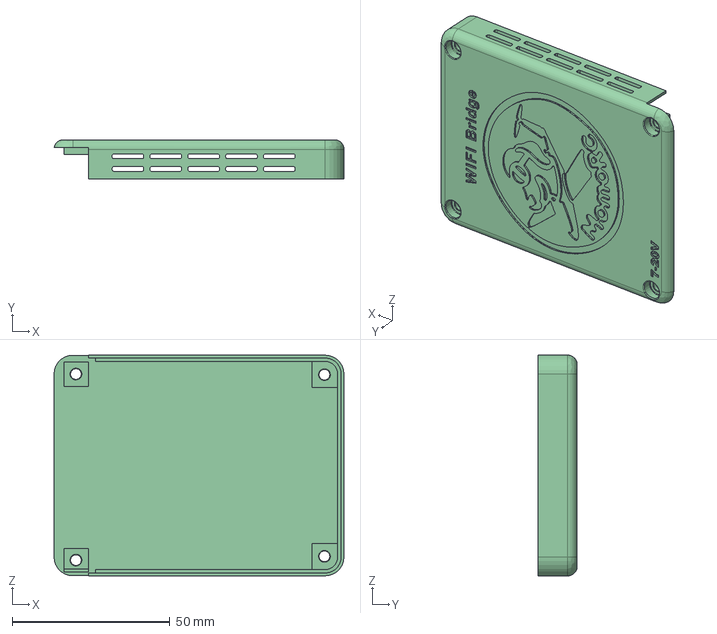
[picture p25: CAD file, 2026-11-14]
cad/housing/housing-body-v1/housing-hood.step
92.0 x 12.5 x 70.0 mm
