MomoRC-tech/Becker-AR6201-to-OpenSoar/cad/housing/layout-v4/housing-layout-v4.step

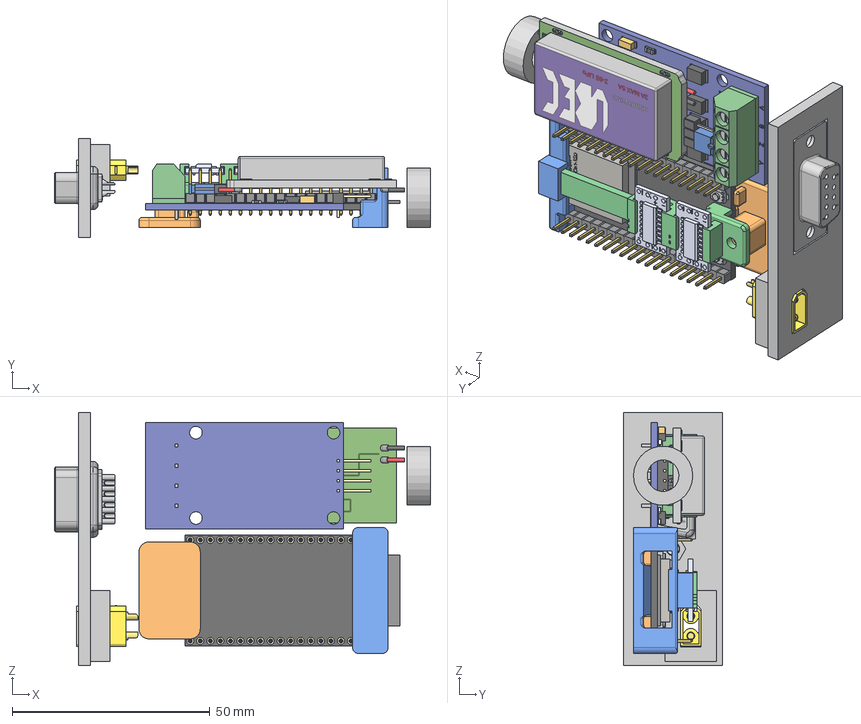
[picture p26: CAD file, 2026-11-13]
cad/housing/layout-v4/housing-layout-v4.step
95.1 x 25.0 x 64.0 mm
DSUB_9pin_female_plug
XT30_Stecker
id2
id5
id8
id11
id14
id17
id20
id23
id26
id29
id32
id35
id38
id41
id44
id47
id50
id53
id56
id59
id62
id65
id68
id71
id74
id77
id80
id83
id86
id89
id92
id95
id98
id101
id104
id107
id110
id113
id116
id119
id122
id125
id128
id131
Henge UBEC v6
Main-PCB
zl201-19_p2-54_l48-3_w2-54_h8-9 x 2
Soldering-Contacts
ab2_usb_micro_smd.wrl
ESP32-chip
3x4x2mm_tact_button x 2
RS232_TTL
RS232_TTL_1
