MomoRC-tech/Becker-AR6201-to-OpenSoar/cad/housing/rs232-holder/rs232-holder.step

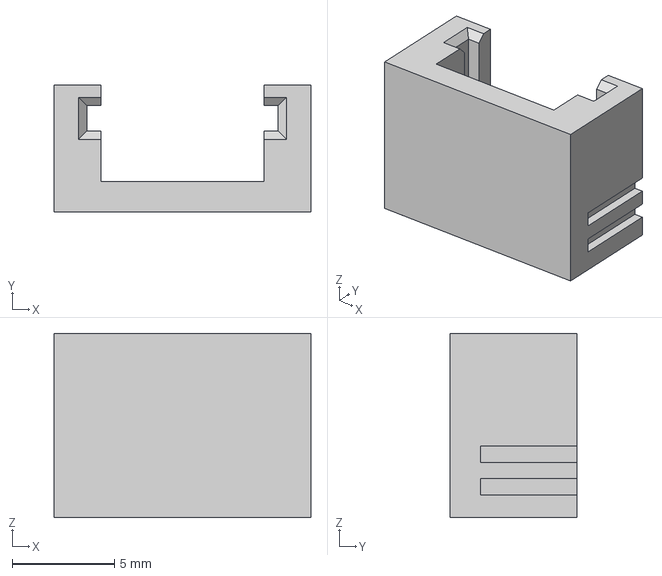
[picture p27: CAD file, 2026-11-12]
cad/housing/rs232-holder/rs232-holder.step
12.5 x 6.20 x 9.00 mm
