MomoRC-tech/Becker-AR6201-to-OpenSoar/cad/housing/ubec-carrier/ubec-carrier.step

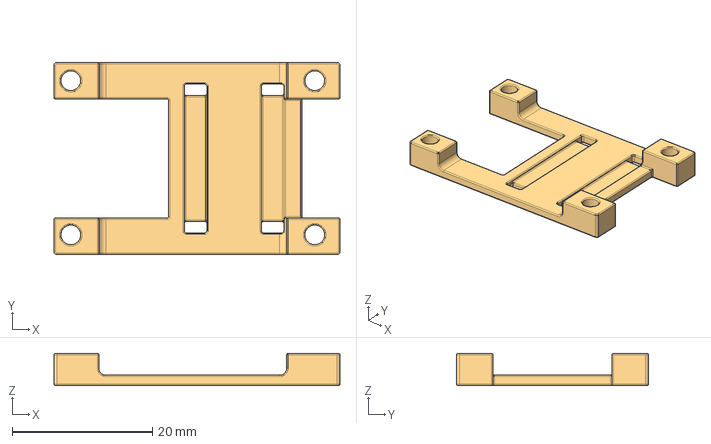
[picture p28: CAD file, 2026-11-13]
cad/housing/ubec-carrier/ubec-carrier.step
40.8 x 27.4 x 4.60 mm
