MomoRC-tech/Becker-AR6201-to-OpenSoar/cad/reference/amass-xt30-family/XT30U-F.step

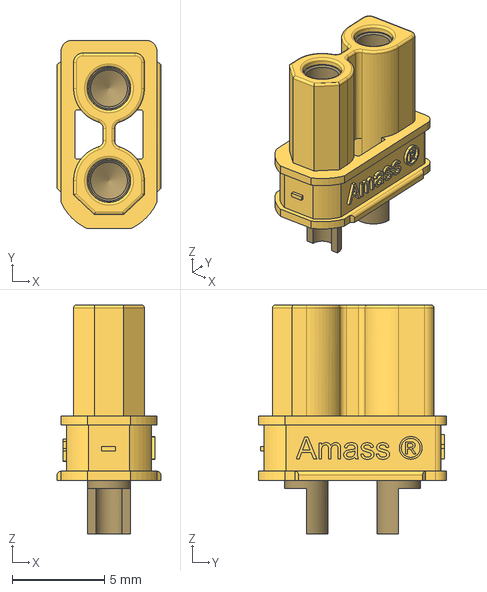
[picture p29: CAD file, 2026-11-13]
cad/reference/amass-xt30-family/XT30U-F.step
5.61 x 10.2 x 12.4 mm
Base_XT30U-F
Pin-F_001 x 2
