MomoRC-tech/Becker-AR6201-to-OpenSoar/cad/reference/dsub-9pin/DSUB_9pin_backshell.STEP

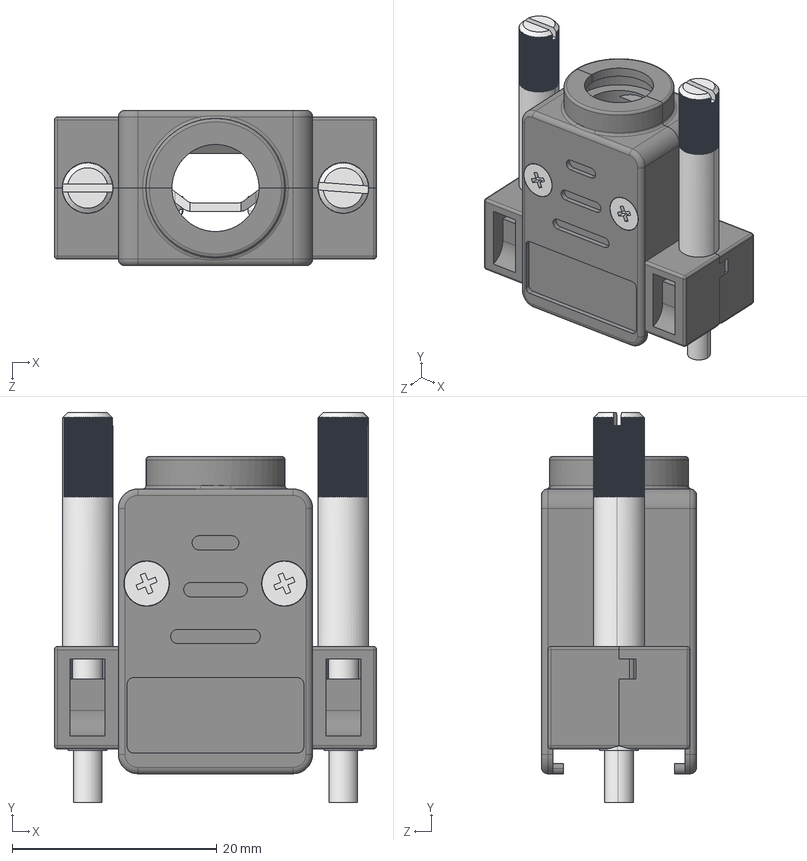
[picture p30: CAD file, 2026-11-13]
cad/reference/dsub-9pin/DSUB_9pin_backshell.STEP
31.5 x 38.1 x 15.2 mm
