MomoRC-tech/Becker-AR6201-to-OpenSoar/cad/reference/esp32-devkitc-v4/ESP-WROOM-32D-Export/Soldering-Contacts.SLDPRT

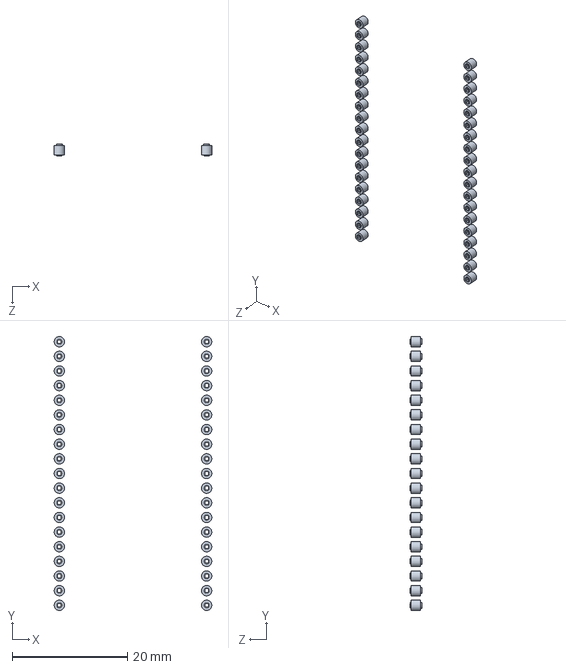
[picture p31: CAD file, 2026-11-11]
cad/reference/esp32-devkitc-v4/ESP-WROOM-32D-Export/Soldering-Contacts.SLDPRT
27.3 x 47.5 x 2.00 mm
