MomoRC-tech/Becker-AR6201-to-OpenSoar/cad/reference/kicad-din0204/R_Axial_DIN0204_L3.6mm_D1.6mm_P5.08mm_Horizontal.step

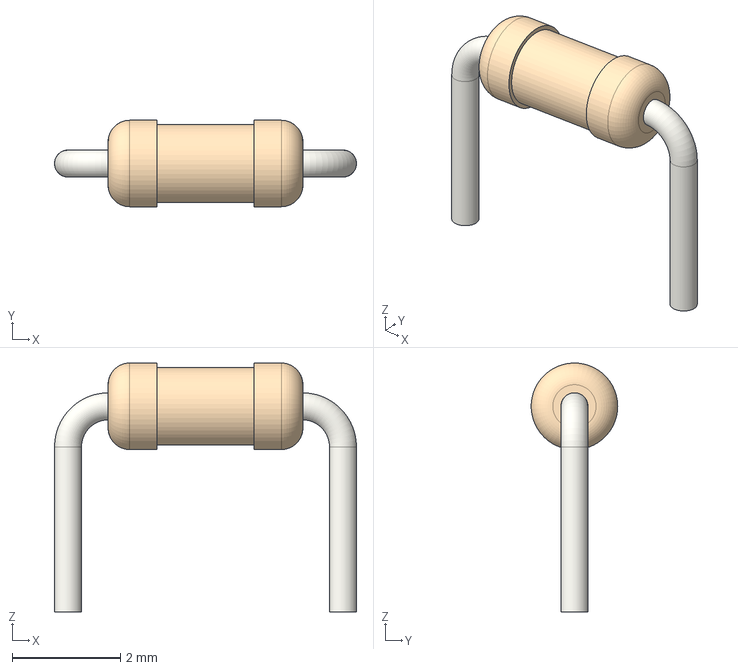
[picture p32: CAD file, 2026-11-11]
cad/reference/kicad-din0204/R_Axial_DIN0204_L3.6mm_D1.6mm_P5.08mm_Horizontal.step
5.58 x 1.60 x 4.60 mm
