MomoRC-tech/Becker-AR6201-to-OpenSoar/cad/reference/rs232-uart-ttl-mini-max3232/RS232_TTL/RS232_TTL.STEP

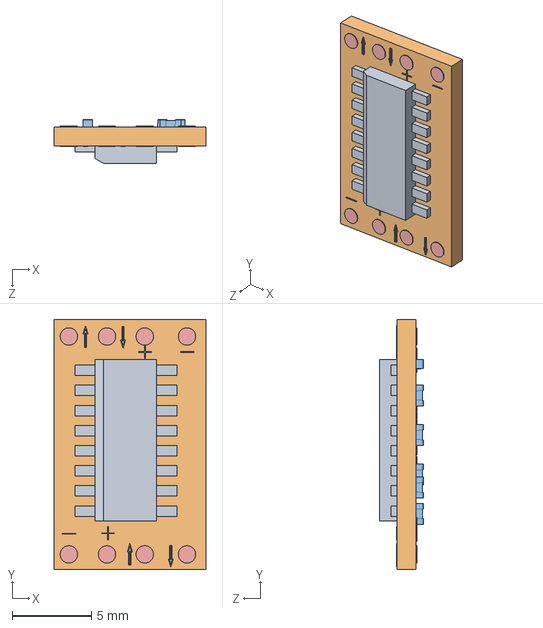
[picture p33: CAD file, 2026-11-11]
cad/reference/rs232-uart-ttl-mini-max3232/RS232_TTL/RS232_TTL.STEP
9.60 x 15.8 x 2.75 mm
