MomoRC-tech/Becker-AR6201-to-OpenSoar/cad/reference/rs422-to-ttl-max490/rs422-to-ttl-max490.step

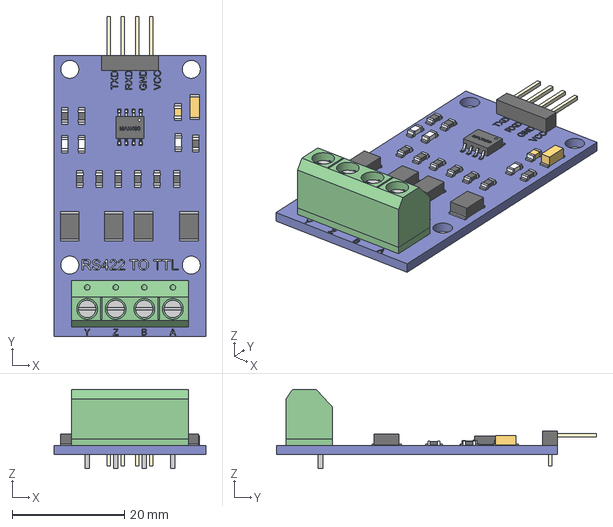
[picture p34: CAD file, 2026-11-11]
cad/reference/rs422-to-ttl-max490/rs422-to-ttl-max490.step
27.0 x 56.9 x 14.1 mm
