MomoRC-tech/Becker-AR6201-to-OpenSoar/cad/reference/ubec-hobbywing-3a/Hobbywing UBEC 3A MAX 5A.step

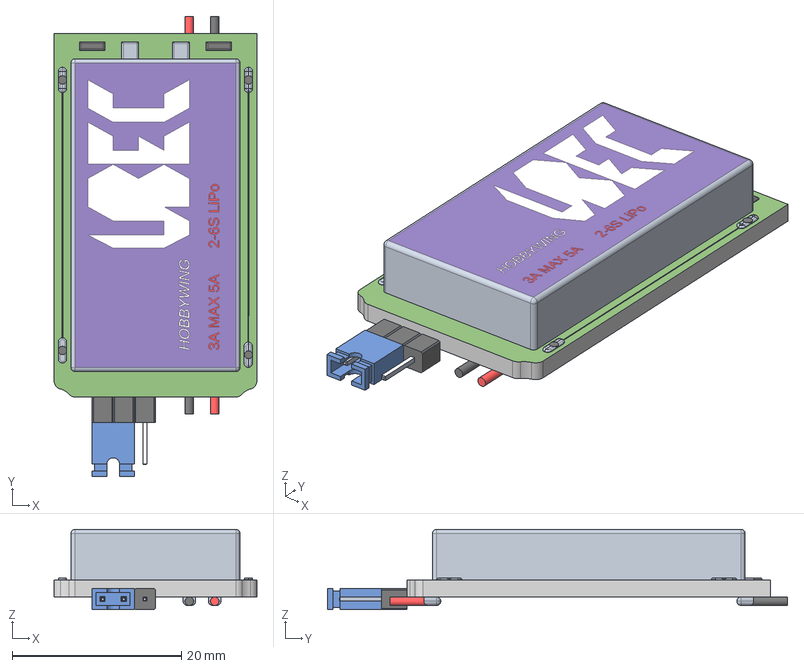
[picture p35: CAD file, 2026-11-11]
cad/reference/ubec-hobbywing-3a/Hobbywing UBEC 3A MAX 5A.step
24.0 x 54.4 x 9.50 mm
