MomoRC-tech/Becker-AR6201-to-OpenSoar/cad/reference/xt30u-m/xt30u-m.step

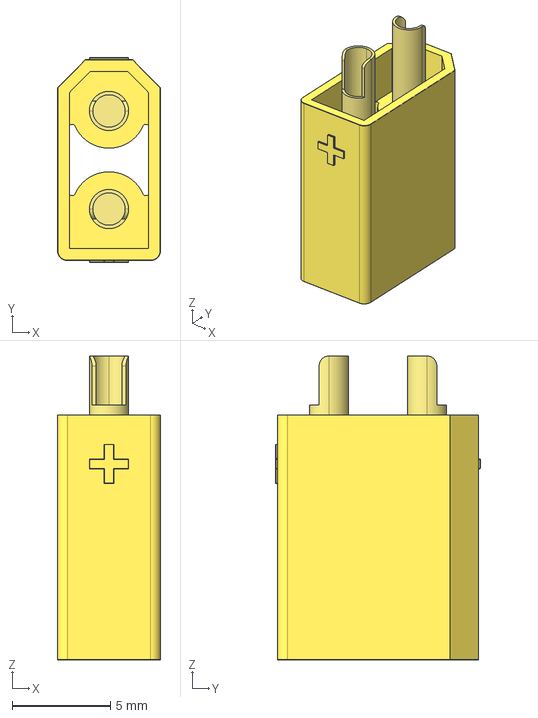
[picture p36: CAD file, 2026-11-12]
cad/reference/xt30u-m/xt30u-m.step
5.25 x 10.4 x 15.5 mm
