MomoRC-tech/Becker-AR6201-to-OpenSoar/cad/housing/connector-print-test/de9-print-test.step

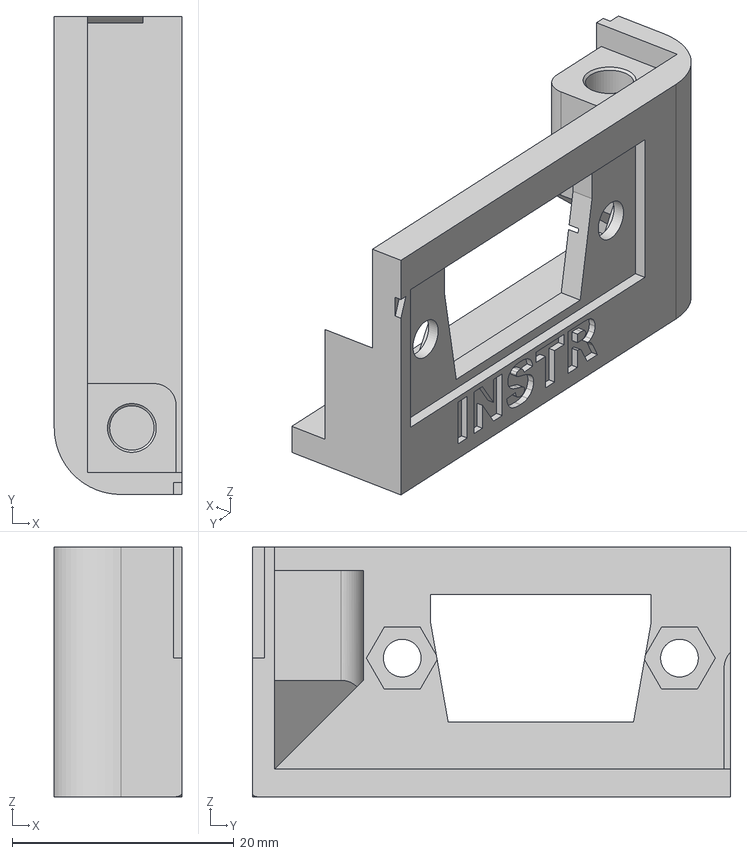
[picture p37: CAD file, 2026-11-13]
cad/housing/connector-print-test/de9-print-test.step
11.5 x 43.1 x 22.5 mm
