MomoRC-tech/Becker-AR6201-to-OpenSoar/cad/housing/housing-body-v1/housing-base.step

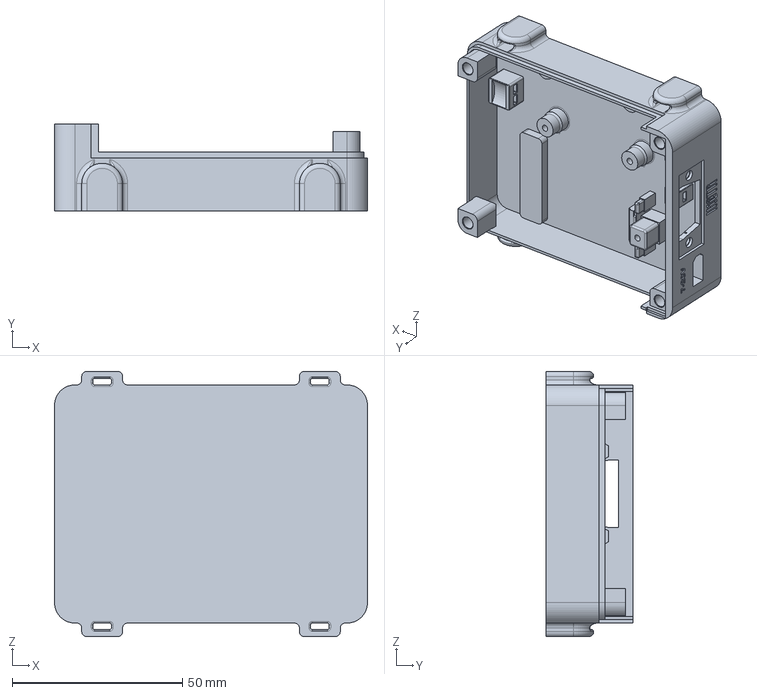
[picture p38: CAD file, 2026-11-14]
cad/housing/housing-body-v1/housing-base.step
92.0 x 25.5 x 78.0 mm
