MomoRC-tech/Becker-AR6201-to-OpenSoar/cad/reference/dsub-9pin/DSUB_9pin_female_plug.STEP

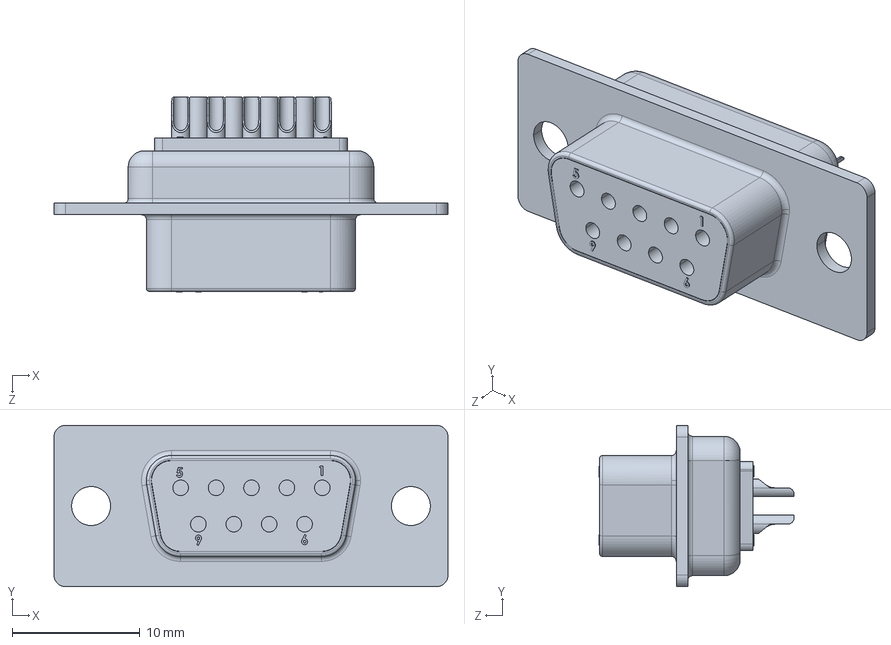
[picture p40: CAD file, 2026-11-13]
cad/reference/dsub-9pin/DSUB_9pin_female_plug.STEP
30.8 x 12.6 x 15.3 mm
