MomoRC-tech/Becker-AR6201-to-OpenSoar/cad/reference/esp32-devkitc-v4/ESP-WROOM-32D-Export/ab2_usb_micro_smd.wrl.SLDPRT

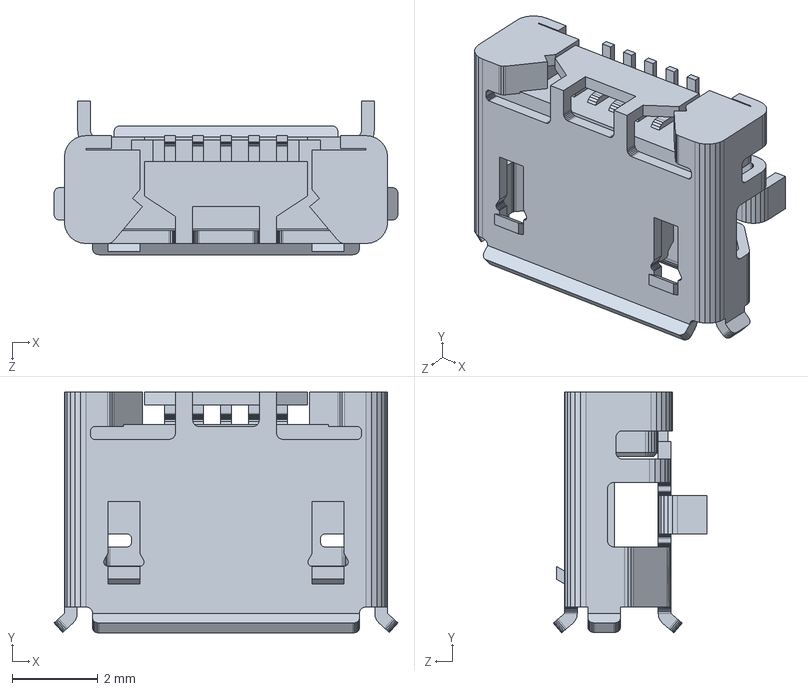
[picture p41: CAD file, 2026-11-11]
cad/reference/esp32-devkitc-v4/ESP-WROOM-32D-Export/ab2_usb_micro_smd.wrl.SLDPRT
8.00 x 5.60 x 3.57 mm
