MomoRC-tech/Becker-AR6201-to-OpenSoar/cad/reference/kicad-din0204/R_Axial_DIN0204_L3.6mm_D1.6mm_P7.62mm_Horizontal.step

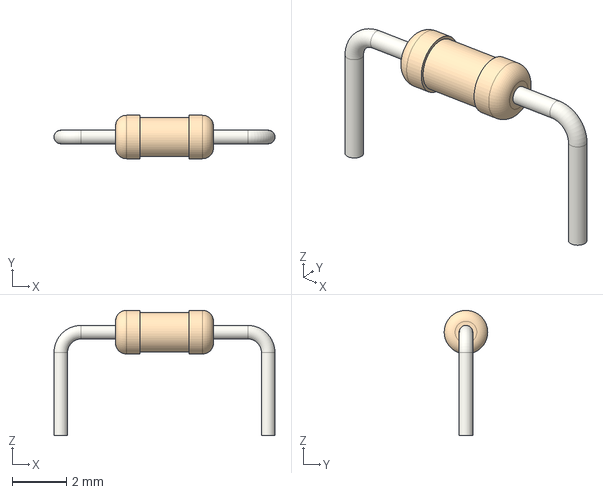
[picture p42: CAD file, 2026-11-11]
cad/reference/kicad-din0204/R_Axial_DIN0204_L3.6mm_D1.6mm_P7.62mm_Horizontal.step
8.12 x 1.60 x 4.60 mm
