MomoRC-tech/Becker-AR6201-to-OpenSoar/cad/housing/housing-body-v1/housing-logo-insert.step

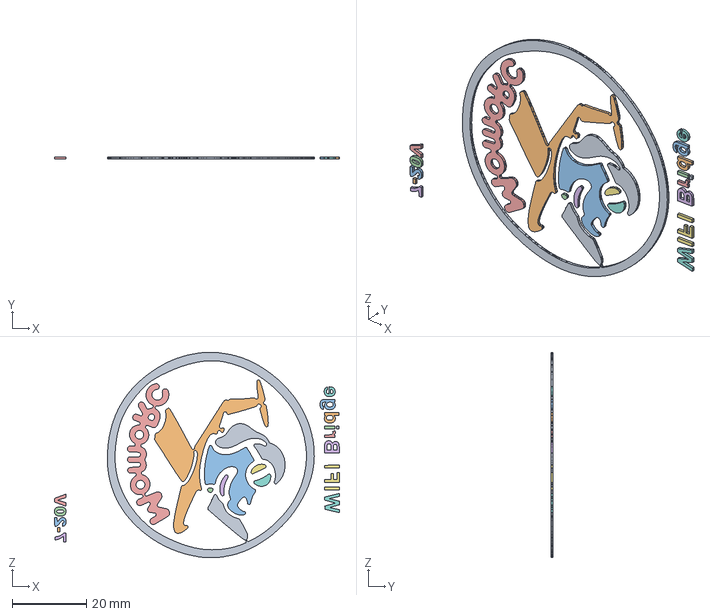
[picture p43: CAD file, 2026-11-13]
cad/housing/housing-body-v1/housing-logo-insert.step
76.8 x 0.6 x 55.3 mm
