MomoRC-tech/Becker-AR6201-to-OpenSoar/cad/reference/amass-xt30-family/XT30PW-M.step

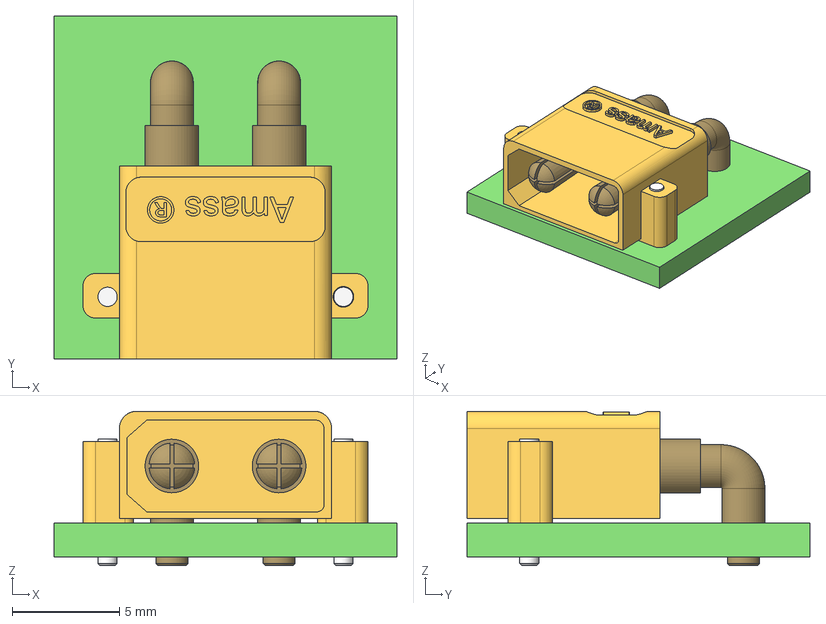
[picture p44: CAD file, 2026-11-13]
cad/reference/amass-xt30-family/XT30PW-M.step
16.0 x 16.0 x 7.20 mm
PCB_for_XT30PW-M
XT30PW-M_base
Pin_M_001 x 2
fixture_003 x 2
