MomoRC-tech/Becker-AR6201-to-OpenSoar/cad/reference/amass-xt30-family/XT30PW-F.step

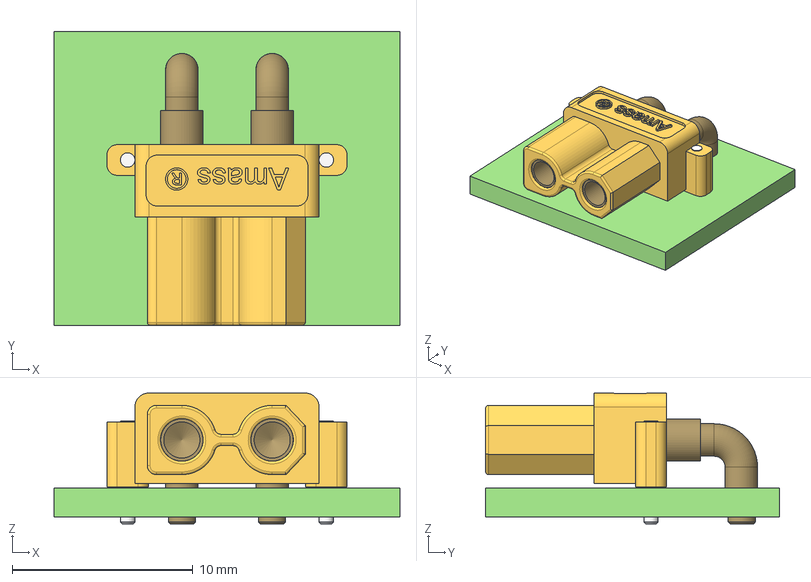
[picture p45: CAD file, 2026-11-13]
cad/reference/amass-xt30-family/XT30PW-F.step
19.2 x 16.3 x 7.25 mm
PCB_for_XT30PW-F
Pin-F_001
Pin-F_002
Fixture_001
Fixture_002
XT30PW-F_base
