MomoRC-tech/Becker-AR6201-to-OpenSoar/cad/reference/esp32-devkitc-v4/ESP-WROOM-32D-Export/ESP32-chip.SLDPRT

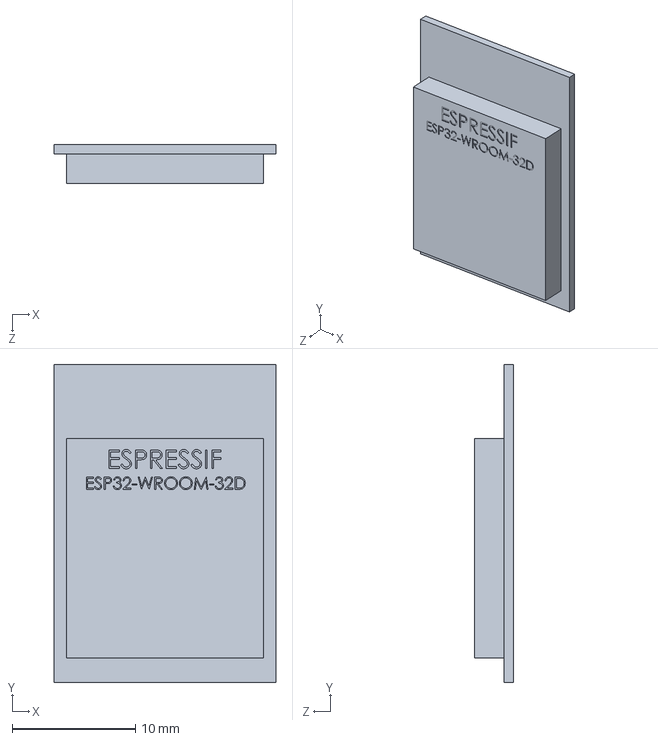
[picture p46: CAD file, 2026-11-11]
cad/reference/esp32-devkitc-v4/ESP-WROOM-32D-Export/ESP32-chip.SLDPRT
18.0 x 25.8 x 3.20 mm
