MomoRC-tech/Becker-AR6201-to-OpenSoar/cad/reference/amass-xt30-family/XT30PB-M.step

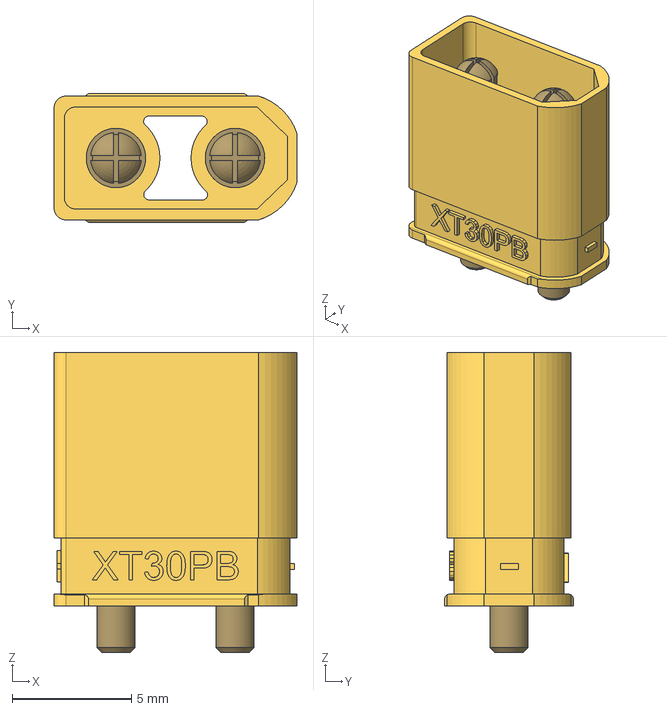
[picture p47: CAD file, 2026-11-13]
cad/reference/amass-xt30-family/XT30PB-M.step
10.2 x 5.40 x 12.6 mm
Base_XT30PB-M
Pin_M_001 x 2
