MomoRC-tech/Becker-AR6201-to-OpenSoar/cad/reference/esp32-devkitc-v4/ESP-WROOM-32D-Export/3x4x2mm_tact_button.SLDPRT

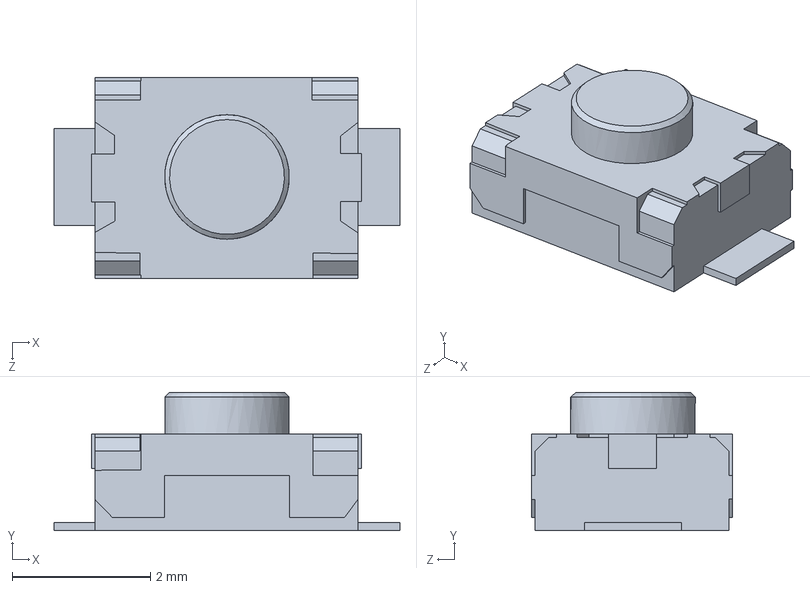
[picture p48: CAD file, 2026-11-11]
cad/reference/esp32-devkitc-v4/ESP-WROOM-32D-Export/3x4x2mm_tact_button.SLDPRT
5.00 x 2.00 x 2.90 mm
