MomoRC-tech/Becker-AR6201-to-OpenSoar/cad/reference/amass-xt30-family/XT30PB-F.step

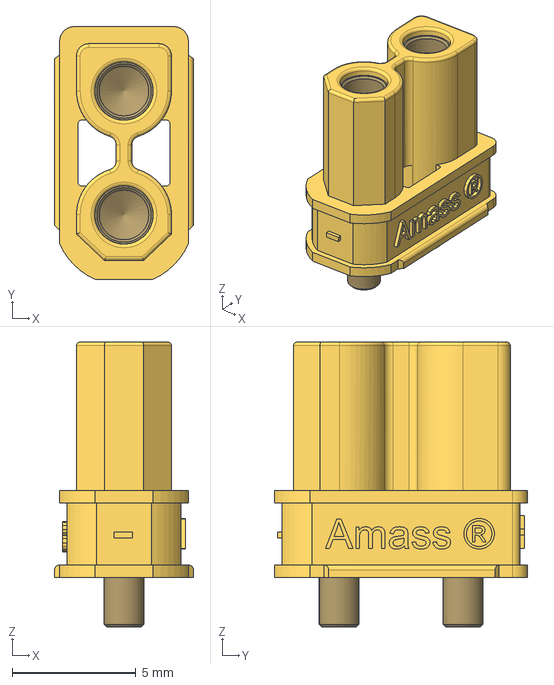
[picture p49: CAD file, 2026-11-13]
cad/reference/amass-xt30-family/XT30PB-F.step
5.61 x 10.2 x 11.5 mm
Base_XT30PB-F
Pin-F_001 x 2
