MomoRC-tech/Becker-AR6201-to-OpenSoar/cad/reference/esp32-devkitc-v4/ESP-WROOM-32D-Export/zl201-19_p2-54_l48-3_w2-54_h8-9.SLDPRT

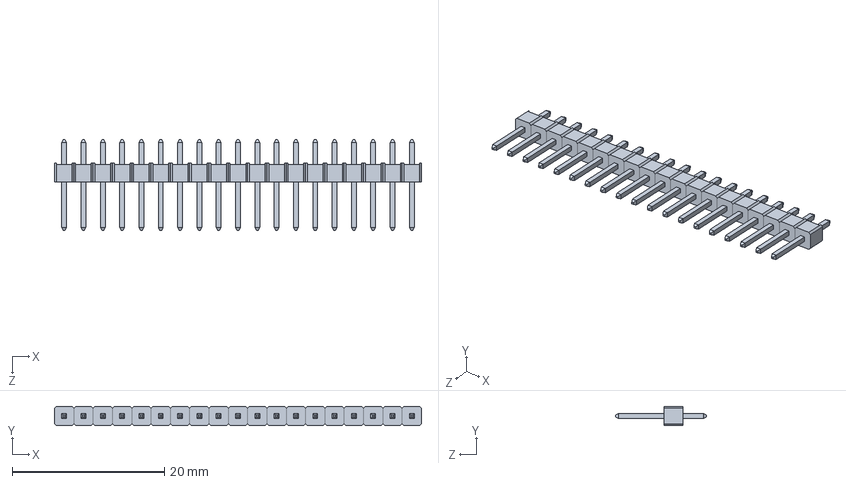
[picture p50: CAD file, 2026-11-11]
cad/reference/esp32-devkitc-v4/ESP-WROOM-32D-Export/zl201-19_p2-54_l48-3_w2-54_h8-9.SLDPRT
48.3 x 2.54 x 11.9 mm
