MomoRC-tech/Becker-AR6201-to-OpenSoar/(list of files, cad)

Other CAD files:
cad/reference/norcomp-973-009-010R011/973-009-010R011.STEP
cad/housing/connector-panel/connector-panel.3mf
cad/housing/connector-print-test/de9-print-test.3mf
cad/housing/connector-print-test/xt30-print-test.3mf
cad/housing/esp32-holder-v3/esp32-holder-v3.3mf
cad/housing/esp32-holder-v3/esp32-holder-v3.f3d
cad/housing/esp32-holder/esp32-holder.3mf
cad/housing/esp32-holder/esp32-holder.f3d
cad/housing/esp32-holder/esp32-holder.step
cad/housing/housing-body-v1/housing-assembly.f3d
cad/housing/housing-body-v1/housing-base.3mf
cad/housing/housing-body-v1/housing-base.f3d
cad/housing/housing-body-v1/housing-hood.3mf
cad/housing/housing-body-v1/housing-hood.f3d
cad/housing/housing-body-v1/housing-logo-insert.3mf
cad/housing/housing-body-v1/housing-logo-insert.f3d
cad/housing/housing-body-v1/housing-power-routing.f3d
cad/housing/rs232-holder/rs232-holder.3mf
cad/housing/rs232-holder/rs232-holder.f3d
cad/housing/ubec-carrier/ubec-carrier.3mf
cad/housing/ubec-carrier/ubec-carrier.f3d
cad/reference/esp32-devkitc-v4/ESP-WROOM-32D-Export/ESP32-WROOM-32D-Assembly.3MF
cad/reference/esp32-devkitc-v4/ESP-WROOM-32D-Export/ESP32-WROOM-32D-Assembly.SLDASM
cad/reference/rs232-uart-ttl-mini-max3232/RS232_TTL/RS232_TTL.x_t
cad/reference/ubec-hobbywing-3a/Hobbywing UBEC 3A MAX 5A.sldprt
cad/reference/ubec-hobbywing-3a/Hobbywing UBEC 3A MAX 5A.x_t
cad/reference/ubec-hobbywing-3a/ubec-measured.f3d
