MomoRC-tech/Becker-AR6201-to-OpenSoar/docs/hardware/wiring.md

# 🔌 Signal wiring

🏠 [Overview](../../README.md) › 🔧 Hardware › **Signal wiring**

How the bridge's signals connect to the Zander, the FLARM and the Becker radio — pin by pin. Supply and grounding: [power and grounding](power.md). The device-side connectors and harness already exist in the aircraft; this page covers the bridge end only.

> [!NOTE]
> **Status:** wiring design in progress. See [open items](../project/open-items.md) for the remaining wiring decisions and [bench checks](../project/open-items.md#bench-hardware).

📑 **On this page:** <kbd>[1 · 🧭 Overview and UART plan](#overview)</kbd> <kbd>[2 · 📈 Zander ZS1](#zander)</kbd> <kbd>[3 · 📡 FLARM](#flarm)</kbd> <kbd>[4 · 📻 Becker radio](#becker)</kbd> <kbd>[5 · 🧪 Bench bring-up](#bring-up)</kbd>

Related: ⚡ [Power and grounding](power.md) · 🧱 [Modules and parts](modules.md) · 📚 [Sources](../research/sources.md)

---

## 1. 🧭 Overview and UART plan

Signal overview: Zander and FLARM through RS-232 modules into ESP32 UART0 and UART1, receive only; Becker through the MAX490 RS-422 board to UART2 in both directions; ESP32 to OpenSoar over Wi-Fi

Zander and FLARM are receive-only at the bridge. No return wires or connector contacts are fitted for their RX inputs. The Becker path works in both directions.

### 1.1 Combined instrument connector

Use one standard-density DE-9 connector for Becker, Zander and FLARM: a male connector (pins) on the housing and a mating female cable connector, with solder-cup contacts and screw locking. Terminate the existing instrument wires directly in the cable connector and support the cables with a backshell and strain relief. Power uses the separate [XT30 connector](power.md#supply).

> [!TIP]
> **Selected DE-9 pinout.** View the male housing connector from outside with the five-pin row up and the XT30 on the left. The housing-side solder-cup view is mirrored. Use the moulded contact numbers on both connector halves.

```text
XT30 side                         MAX490 side
      1      2      3      4      5
          6      7      8      9
```

| DE-9 pin | Instrument harness | Inside the bridge |
| ---: | --- | --- |
| 1 | [Zander ZS1](#zander) TX | RS-232 mod1 L3 |
| 2 | [FLARM](#flarm) TX | RS-232 mod2 L3 |
| 3 | [Becker](#becker) J1-21 D_GND | GND-J |
| 4 | Becker J1-2 TX2+ | MAX490 A |
| 5 | Becker J1-9 TX2− | MAX490 B |
| 6 | Zander ZS1 signal ground | GND-J |
| 7 | FLARM signal ground | GND-J |
| 8 | Becker J1-3 RX2+ | MAX490 Y |
| 9 | Becker J1-10 RX2− | MAX490 Z |

Keep pins 4/5 and 8/9 as separate twisted pairs up to the solder cups. Follow the [Becker shield termination](#becker) and insulate the drain at the bridge end. Use the dedicated instrument harness with this custom pinout. See [housing](housing.md#connectors) for mounting and [open items](../project/open-items.md#bench-hardware) for parts and fit checks.

### 1.2 UART plan

The ESP32 has three UARTs; each device gets one.

| Device | UART | ESP32 RX | ESP32 TX | Interface |
| --- | --- | --- | --- | --- |
| 📈 Zander ZS1 | UART0, remapped | GPIO32 | Not connected | RS-232-mod1 |
| 📡 FLARM | UART1 | GPIO26 | Not connected | RS-232-mod2 |
| 📻 Becker | UART2 | GPIO16, through a 2.2 kΩ / 3.3 kΩ divider | GPIO17 | MAX490 RS-422 board |

UART0 is also the USB serial port. The firmware remaps its receive input to GPIO32 after boot, so there is no USB serial log in operation; diagnostics go over Wi-Fi. Boot messages appear only on GPIO1, so they never reach a device. Keeping the radio off UART0 means a stray log line can never reach the radio.

> [!IMPORTANT]
> The firmware must switch the UART0 log console off when assigning UART0 to Zander reception. GPIO33 and the Zander return path are not wired.

---

## 2. 📈 Zander ZS1

Zander TX to mod1 L3 and R2 to GPIO32; instrument ground goes to GND-J; mod1 supply and ground arrive through mod2

Start with the loose ends of the existing Zander harness ([installed wiring](../project/existing-installation.md#equipment)). The table identifies the required RS-232 signals, not a connector at the bridge. Match each loose conductor to its signal before connecting it; see [open items](../project/open-items.md#bench-hardware). Signal functions follow the ZS1 handbook (S22).

| Zander harness signal | → / ← | RS-232 pads | TTL pads | → / ← | ESP32 |
| --- | :-: | --- | --- | :-: | --- |
| TX from Zander | → | **L3** RS-232 input | **R2** TTL output | → | GPIO32 (RX) |

Connect the Zander signal-ground conductor to GND-J. The module receives 3.3 V and ground through mod2; see the [supply chain](power.md#supply). Leave L1 without an extra ground wire.

Leave L4 and GPIO33 unconnected. Solder the 10 kΩ pull-up R-Z directly on the module, from pad R1 to pad R3 (the module's 3.3 V supply). It holds the unused converter driver input at a defined level.

---

## 3. 📡 FLARM

FLARM TX to mod2 L3 and R2 to GPIO26; instrument ground goes to GND-J; mod2 supply and ground arrive from ESP32 and continue to mod1

Use a free data port on the Classic FLARM ([installation manual v221 pp.6/7](https://www.flarm.com/wp-content/uploads/2024/04/FLARM_InstallationManual_D.pdf#page=6), S23).

| FLARM Power/Data | → / ← | RS-232 pads | TTL pads | → / ← | ESP32 |
| --- | :-: | --- | --- | :-: | --- |
| 5 (TX) | → | **L3** RS-232 input | **R2** TTL output | → | GPIO26 (RX) |

Connect the FLARM signal-ground conductor (pins 7/8) to GND-J. Mod2 receives 3.3 V and ground from the ESP32 and passes both on to mod1; see the [supply chain](power.md#supply). Leave L1 without an extra ground wire.

Leave L4, GPIO27 and the FLARM RX conductor unconnected. Solder the 10 kΩ pull-up R-F from pad R1 to pad R3 on the module, as for the Zander.

> [!WARNING]
> FLARM uses IGC pin numbering, which runs opposite to common RJ45 numbering. Pins 1–3 carry supply voltage: never connect them to the converter.

Classic FLARM plug, latch down, IGC numbering. Pins 1 and 2 supply in, 3 auxiliary voltage out, 4, 7 and 8 ground, 5 TX, 6 RX.

---

## 4. 📻 Becker radio

Becker TX2 and RX2 pairs to MAX490; D_GND goes directly to GND-J; MAX490 has its own central supply and return branches

The radio's serial interface 2 on connector J1 ([Becker DV14307.03 Issue 06, p.59](https://www.becker-avionics.com/wp-content/uploads/00_Literature/6200_Series_IO_en.pdf#page=59), S10).

Start at the loose ends of the existing Becker harness ([installed wiring](../project/existing-installation.md#equipment)). The J1 numbers below identify radio-side signal origins, not a bridge-side connector. Terminate the bridge end using the [selected DE-9 pinout](#de9-pinout).

### 4.1 Radio side — board screw terminals

| J1 pin | Radio signal | Bridge connection | Meaning |
| --- | --- | --- | --- |
| 2 | TX2+ | A | Receiver input + |
| 9 | TX2− | B | Receiver input − |
| 3 | RX2+ | Y | Driver output + |
| 10 | RX2− | Z | Driver output − |
| 11 | SHIELD_2 | — (cable shield) | Shield of the auxiliary control interface |
| 21 | D_GND | Central GND-J | Signal reference |

Run TX2± and RX2± as two separate twisted pairs in a shielded cable, as Becker requires for the interface lines (S10). Connect the shield to J1-11 at the radio end only and leave it unconnected at the bridge end, so it carries no ground current. Connect J1-21 to GND-J with a separate wire in the same cable, not the shield or drain wire. J1-21 also closes ground loop B; see [grounding and loops](power.md#ground).

### 4.2 TTL side — board header

| Board signal | Bridge connection |
| --- | --- |
| Receiver output (RO) | 2.2 kΩ (R-B1) in the wire to GPIO16 (J3-12); 3.3 kΩ (R-B2) across the header pins J3-12 and J3-7 (GND) (RX) |
| Driver input (DI) | GPIO17 (J3-11), plus a 10 kΩ pull-up (R-D) from J3-11 to 3V3 (J2-1) (TX) |
| VCC | Own branch from central 5V-J |
| GND | Own branch from central GND-J; no extra wire to ESP32 |

R-B1 sits at the J3-12 end of the RO wire and R-D bridges J3-11 to J2-1 with an insulated lead. Cover each resistor and both its joints with heat-shrink and tie the wire down next to the ESP32, so vibration does not load the joints.

> [!IMPORTANT]
> The board's TXD/RXD header labels may be named from either side. Identify RO and DI on the board before wiring.

ESP32 TX at 3.3 V drives DI directly (the MAX490 needs 2.0 V for a logic high). The pull-up R-D holds DI idle while the ESP32 boots, so no random bits reach the radio before the UART is set up.

> [!WARNING]
> The MAX490 runs at 5 V, so RO idles near 5 V — above the ESP32's 3.6 V input limit (S34). Never connect RO directly to GPIO16.

```math
V_{\text{GPIO16}} = V_{\text{RO}} \cdot \frac{3.3\text{ k}\Omega}{2.2\text{ k}\Omega + 3.3\text{ k}\Omega} = 0.6 \cdot V_{\text{RO}} \quad\Rightarrow\quad 5.0\text{ to }5.25\text{ V} \to 3.0\text{ to }3.15\text{ V}
```

The divider keeps GPIO16 inside the ESP32's input range, so no current flows into the pin's protection diode. A series resistor alone would rely on that diode, for which Espressif gives no current limit. The divider's low source impedance (about 1.3 kΩ) also keeps a clean logic low when the firmware enables the ESP32's internal RX pull-up (about 45 kΩ), as Arduino-ESP32 does by default (S35). RO is loaded with about 1 mA.

### 4.3 Connector reference

| Radio rear (callout 4 = J1) | J1 mating face |
| --- | --- |
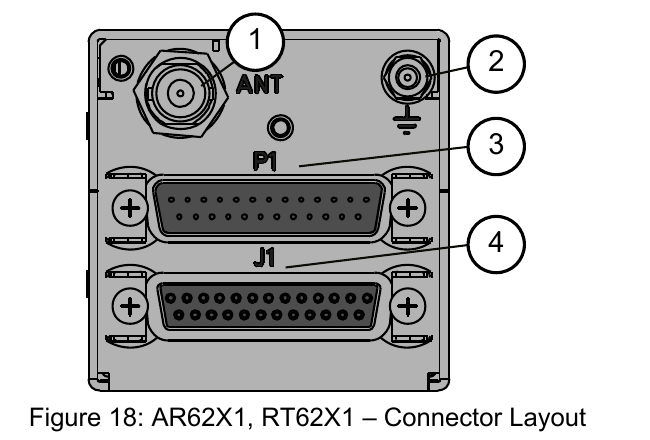
[picture p51: docs/images/becker-reference-connectors.png]
Becker rear drawing, P1 above J1. Callout 4 identifies the J1 connector.
|  | Becker J1 DB-25 socket. Pins 2 and 9 TX pair, 3 and 10 RX pair, 11 shield, 21 digital ground. |

Socket numbering follows the [Winford BRKDD25F-R-FT mating-face drawing](https://www.winford.com/products/cad/brkdd25f-r-ft_rev_a_dwg.pdf). Pin-view styling follows the [Pinout.xyz examples](https://github.com/pinout-xyz/Pinout.xyz/tree/main/graphics).

---

## 5. 🧪 Bench bring-up

Before connecting any device, work through this list in order:

- [ ] **1.** Set the UBEC jumper to 5 V; measure the output with no load and with the ESP32 connected. Check continuity between the UBEC's input and output ground.
- [ ] **2.** Match the ESP32 board's headers and module marking to the [pinout](modules.md#esp32-pinout).
- [ ] **3.** With both RS-232 boards unpowered, check continuity from L2 to R3 and from L1 to R4 on each board. Verify the rest of the [pad map](modules.md#rs232-module) before soldering R-Z and R-F.
- [ ] **4.** On the MAX490 board, identify RO and DI on the header and check the 120 Ω termination.
- [ ] **5.** With the MAX490 powered and the radio line idle, measure GPIO16: about 3.0 V (high). Then hold B above A with a 1.5 V cell (+ to B, − to A) and check for a low below 0.5 V.
- [ ] **6.** Measure the bridge's current and switch-on inrush at 12 V, and update the [current assumptions](power.md#currents).
- [ ] **7.** With power off and the instruments disconnected, use the moulded contact numbers to check each loose harness conductor end to end through the mated DE-9 against the [pinout](#de9-pinout). Check for unintended connections between signals and from signals to GND-J or the shell. Allow for the MAX490 receive termination and the three ground contacts that share GND-J.
- [ ] **8.** Before plugging in J1, check that the bridge ground and the radio's P1-13 and P1-25 each have low resistance (well under 1 Ω) to the common ground point ([why](power.md#wire-breaks)).
- [ ] **9.** In the aircraft: listen for radio noise and check squelch with the bridge on and off.

---

<kbd>[⬆️ Back to top](#top)</kbd> <kbd>[🏠 Overview](../../README.md)</kbd>
