MomoRC-tech/Becker-AR6201-to-OpenSoar/(commit log)

2026-11-08 Document pinned driver review and ESP32 bridge findings
2026-11-08 Investigate related Becker drivers and ESP32 bridge projects
2026-11-08 Verify Becker references and OpenSoar release driver
2026-11-08 docs: agree project goals and propose one-ESP32 hardware and cabling
2026-11-08 Document individual power and ground connections
2026-11-08 Separate signal and power drawings with individual pin boxes
2026-11-08 Use Mermaid for pin-level connection diagrams
2026-11-08 Restore connection diagrams before the pin-box redesign
2026-11-08 Show pin endpoints and signal arrows in connection diagram
2026-11-08 Verify Becker send-length regression against historical driver
2026-11-08 Document Becker driver alternatives and protocol leads
2026-11-08 Document bench hardware package and selected BEC power path
2026-11-09 docs: separate concise wiring guide from bench reference
2026-11-09 docs: add manufacturer connector references and plain component names
2026-11-09 docs: use compact device-module wiring layouts and collapsed references
2026-11-09 docs: separate Becker connections and mark optional device receive paths
2026-11-09 docs: add colored signal badges and wiring section icons
2026-11-09 docs: add temporary README and wiring diagram preview
2026-11-09 docs: select Hailege H-1-0290 RS-232 boards
2026-11-09 docs: simplify wiring tables and restore separate arrows
2026-11-09 docs: separate wiring sections and highlight connection checks
2026-11-09 docs: record live GitHub wiring guide verification
2026-11-09 docs: replace Becker diagram with approved connector view
    Keep conditional J1 references and unknown physical contacts explicit. Verify SVG structure, local rendering, connection-table consistency and unchanged README/guide hashes. Documentation only; no hardware tests.
2026-11-09 docs: restore Becker diagram and add connector pin views
    Check reference pin labels, render four SVGs locally, verify guide links and whitespace, and confirm the original Becker SVG and main README. No hardware tests.
2026-11-09 docs: remove Becker transmit test jumper
    Connect GPIO17 TX directly to THVD1451D D in the proposed design. Check wiring and parts-list consistency and render the updated diagram. No hardware tests.
2026-11-09 docs: remove navigation TX test jumpers
    Document direct optional Zander and FLARM returns. Check the wiring tables, parts list and existing optional-return diagrams for consistency. No hardware tests.
2026-11-09 docs: record selected ESP32 dev module and simplify ground labels
    Use the owner-selected AZ-Delivery ESP32 WROOM dev module in the wiring and bench records. Check all seven ground labels, remaining header and regulator checks, and whitespace. No hardware tests.
2026-11-09 docs: consolidate bench build reference into wiring guide
    Preserve the parts list and essential build notes in the connection guide. Keep the bench sequence in the roadmap. Verify all original parts rows and 16 new relative links and anchors. Documentation only.
2026-11-09 docs: select assembled RS-422 board for Becker
    Record the observed connector labels and leave module supply, pin functions and ESP32 compatibility unresolved. Remove bare-chip parts. Check cross-references, parts and power consistency, and render the revised diagram.
2026-11-09 docs: record supplied RS-422 module schematic
    Record 5 V supply and header directions as schematic evidence. Keep board match, logic compatibility and termination unresolved. Check wiring, power and source consistency. Documentation only.
2026-11-09 docs: record confirmed RS-422 board schematic
    Use the supplied schematic for the 5 V rail and connector directions. Keep logic compatibility and fitted termination open. Checked documentation consistency and whitespace.
2026-11-09 docs: record supplied MAX490ESA module specifications
    Keep module claims separate from the chip datasheet. Record the resistor discrepancy and RXD level conversion. Check source and wiring consistency and render the SVG. Documentation only.
2026-11-09 docs: record confirmed MAX490ESA chip
    Use the MAX490 datasheet for IC identification and pin numbers. Preserve the module-level resistor and logic interface gaps. Documentation consistency checked.
2026-11-09 docs: highlight wiring caveats with Markdown alerts
2026-11-09 docs: show dedicated F1 fuse in power diagram
2026-11-11 Require a 3.3 V RS-422 board for Becker
2026-11-11 Remove superseded RS-422 board from the wiring guide
2026-11-11 Keep project documentation focused on current state
2026-11-11 Document the candidate ESP32 DevKitC V4 pinout
2026-11-11 Show the AZ-Delivery pinout in the collapsed ESP32 section
2026-11-11 Group the ESP32 pinout under module specs
2026-11-11 Document 3.3 V full-duplex RS-422 chip candidates
2026-11-11 Remove redundant wiring overview warning
2026-11-11 Consolidate wiring warnings and bench checks
2026-11-11 Document selected MAX490 board and UART voltage limits
2026-11-11 Record the selected 1 kOhm UART RX series resistor
2026-11-11 chore: add Claude Code setup
    CLAUDE.md imports AGENTS.md so both agents share one instruction file.
    Ignore local agent attachments and personal Claude settings.
2026-11-11 Rewrite README as a one-screen landing page
    Goal, scope, status at a glance, next step and navigation by intent.
    Hardware selections stay in the docs that own them.
2026-11-11 Merge research pages and trim the roadmap
    becker-driver.md: driver findings, other implementations, protocol leads, manuals.
    bridge-firmware.md: bridge candidates and alternatives.
    Roadmap keeps queue, milestones, current state and verification coverage.
2026-11-11 Put every source in the register table
    S08, S09, S10, S12 and S20 join the register; follow-up notes fold into their rows.
    Driver observations F02-F06 get their own Findings section.
2026-11-11 Group docs into hardware, design, project and research
    Pages move into four folders; parts list joins the module specs.
    Wiring page gets a title and plain headings; every page links back to the README.
    All relative links and AGENTS.md paths updated.
2026-11-11 Relax documentation style rules and set hardware focus
    Write for the builder: plain sentences, status stated once per section,
    open questions only in open-items, warnings for hardware or flight safety only.
    Hardware selection and wiring come first; each hardware decision goes to the owner.
2026-11-11 Record hardware decisions and rewrite hardware pages in plain style
    Owner decisions: keep 5 V MAX490 with 10 kOhm series resistor to GPIO16;
    bond J1-21 to board GND; UART0 remapped Zander, UART1 FLARM, UART2 Becker;
    10 kOhm pull-ups on RS-232 module R1; 2 A ATO fuse; no extra protection
    stages; bridge-end wiring only.
    Adds MAX490 terminal mapping, load estimate, bench bring-up list and radio
    noise risk. Open items reduced to bench checks.
2026-11-11 Show page contents as a row of key-style buttons
    Each page's section list becomes one line of <kbd> buttons so internal
    links are recognisable; footers use the same style.
2026-11-11 Add DI pull-up so the radio line stays quiet during boot
    10 kOhm R-D from MAX490 DI to 3.3 V (owner decision). UART plan kept;
    note that the UART0 console must be off.
2026-11-11 Use a 2.2k/3.3k divider on the Becker RX line
    The 10 kOhm series resistor left too little logic-low margin with the
    ESP32's internal RX pull-up, which Arduino-ESP32 enables by default.
    The divider keeps GPIO16 at 3.0-3.15 V without relying on the clamp diode.
2026-11-11 Connect the Becker cable shield to J1-11 at the radio end
    The manual provides SHIELD_2 (J1-11) for the auxiliary control
    interface. D_GND (J1-21) now runs on its own wire instead of the drain.
2026-11-11 Record dedicated power connection and connector planning items
2026-11-11 Ground the bridge at the radio's supply ground point
    J1-21 is a signal reference only. A solid bridge ground keeps supply
    current out of the radio's internal ground if a wire fails. Adds bench
    checks for UBEC ground continuity and bridge-to-radio ground resistance.
2026-11-11 Unplug the Becker J1 connector whenever USB is connected
    On USB alone the MAX490 is unpowered but partly fed through DI, and a
    mains-charged laptop can put leakage voltage on the radio's ground.
2026-11-11 Reopen fuse rating and record unprotected supply feed
2026-11-11 Allow one warning box per hazard and list visual elements
    AGENTS.md now allows a warning per hazard instead of one per section and
    says when to use tables, task lists, diagrams, code, math and quotes.
    The power section's two USB hazards get separate warning boxes.
2026-11-11 Select housing-integrated fuse holder and defer feed protection
2026-11-11 Defer fuse holder and format selection
2026-11-11 Use task lists, math, diagrams and alert boxes on existing pages
    Bench bring-up becomes a checklist; the RX divider and 12 V current get
    formulas; the work loop becomes a diagram; must-not-miss steps get
    IMPORTANT boxes. A 6 V UBEC setting is now flagged as a hazard.
2026-11-11 Select XT30 power connector with printed pocket and adhesive
2026-11-11 Keep J1-21 as a direct wire and record ground wire-break cases
    The ground section now lists what each broken wire does and warns that
    the direct J1-21 wire depends on the radio's own P1 ground. Bring-up
    step 7 checks P1-13/25; a new open item asks about the radio ground.
2026-11-11 Split power and grounding into its own page
    docs/hardware/power.md now owns the supply path, a ground-loop diagram
    (L1 Becker, L2 Zander, L3 FLARM), a current table per branch, the
    wire-break cases and protection. wiring.md becomes Signal wiring.
    Links, README map and AGENTS.md ownership follow; S22/S23 note the
    Zander and FLARM supply data.
2026-11-11 Draw the ground loops as an SVG and rename them Loop B/Z/F
    L1-L3 read like mains phases and clashed with the Hailege pad names.
    The new SVG shows supply, supply grounds and the dashed signal grounds
    that close each loop, with a legend.
2026-11-11 Select combined DE-9 instrument connector
2026-11-11 Add current arrows and signal-ground loop labels to the diagram
    Arrows show the normal current direction on supply and ground lines.
    The UBEC-to-ESP32 line is labelled 5 V only; 3.3 V comes from the ESP32
    board. Each dashed signal ground names the loop it closes, and the loop
    table gains a "closed by signal ground" column.
2026-11-11 Redraw hardware diagrams as SVGs in the ground-loop style
    Supply path, signal overview and the three device diagrams now share one
    style: colour-coded line types, direction arrows, pin labels and a
    built-in legend. Signal grounds are blue dashed as in the loop diagram.
    The supply connector text becomes a bullet list, and AGENTS.md now
    prefers bullets and allows short fragments.
2026-11-11 Add the diagram generator and move the loop diagram into it
    tools/diagrams.py now produces all six hardware SVGs in one style; run
    it from the repository root. The ground-loop diagram is generated too
    (same layout as before). AGENTS.md says how to edit diagrams.
2026-11-11 Give the README a simple overview diagram with role names
    The README no longer reuses the pin-level wiring overview. The new
    diagram names each device by role (Vario, Collision warning, Radio,
    Navigation) and only shows what flows where.
    [diagrams.py]
2026-11-11 Show role and device on separate lines in the README overview
2026-11-11 Add a housing page for the mechanical design
    docs/hardware/housing.md collects requirements, part sizes, the XT30 and
    DE-9 mounting and internal layout constraints. Open-items gets a housing
    section (sizes, material, location, mounting, access, Wi-Fi path).
    The XT30 pocket details move from power.md; links, README map, roadmap
    and AGENTS.md ownership follow.
2026-11-11 Record measured RS-232 board dimensions
2026-11-11 Document ESP32 reference mechanical dimensions
2026-11-11 Record measured ESP32 PCB dimensions
2026-11-11 Add MAX3232 CAD reference and verify model dimensions
    [RS232_TTL.STEP, RS232_TTL.x_t]
2026-11-11 Add RS-422 board photo and generated pin map
2026-11-11 Rotate RS-422 board view and pin map clockwise
2026-11-11 Add ESP32 DevKitC V4 CAD reference and dimensional comparison
    [3x4x2mm_tact_button.SLDPRT, ESP32-WROOM-32D-Assembly.3MF, ESP32-WROOM-32D-Assembly.SLDASM, ESP32-WROOM-32D-Assembly.STEP, ESP32-chip.SLDPRT, Main-PCB.SLDPRT, Soldering-Contacts.SLDPRT, ab2_usb_micro_smd.wrl.SLDPRT]
2026-11-11 Document NorComp DE-9 CAD reference
2026-11-11 Add selected NorComp DE-9 STEP model
    [171-009-203.STEP]
2026-11-11 Add UBEC and DIN0204 resistor CAD references
    [R_Axial_DIN0204_L3.6mm_D1.6mm_P5.08mm_Horizontal.step, R_Axial_DIN0204_L3.6mm_D1.6mm_P7.62mm_Horizontal.step, ubec hobbywing 3a.SLDPRT]
2026-11-11 Replace UBEC CAD reference with Hobbywing 3A MAX 5A model
    [Hobbywing UBEC 3A MAX 5A.sldprt, Hobbywing UBEC 3A MAX 5A.step, Hobbywing UBEC 3A MAX 5A.x_t, ubec hobbywing 3a.SLDPRT]
2026-11-11 Add RS-422 MAX490 board CAD reference
    Store the Fusion-built STEP model of the selected RS422 TO TTL board,
    record its Open Cascade dimension check as S46 and list the remaining
    physical measurements under housing open items.
    [rs422-to-ttl-max490.step]
2026-11-11 Replace MAX490 board STEP reference
    [rs422-to-ttl-max490.step]
2026-11-11 List missing housing inputs and design rules
2026-11-11 Record housing design rules and PETG material check
2026-11-11 Select PETG for the shaded housing
2026-11-11 Select 2.5 mm housing walls
2026-11-11 Select housing split, PCB and XT30 retention, ESP32 orientation
2026-11-11 Select ESP32 position, outside access and internal perfboard
2026-11-12 Select fuse holder, attachment ears, ventilation and LED window
2026-11-12 Select DE-9 mounting, CAD workflow, markings and size priority
2026-11-12 Add housing print starting values and fit test print
2026-11-12 Record ruthex M3 heat-set insert dimensions
2026-11-12 Select hood screws
2026-11-12 Bring the XT30U-M CAD reference onto main
    [xt30u-m.step]
2026-11-12 Add the housing fit-test coupon model
    [fit-test-coupon.3mf, fit-test-coupon.step]
2026-11-12 Reserve housing space for the UBEC ferrite ring
2026-11-12 Reduce the fit-test coupon to six small test pieces
    [fit-test-coupon.3mf, fit-test-coupon.step]
2026-11-12 Allow 60° overhangs, 3.0 mm connector wall, logo as the only marking
2026-11-12 Keep connector-name markings; embossed text passed the fit test
2026-11-12 Record fit-test print accuracy
2026-11-12 Record M3 clearance hole fit test
2026-11-12 Record PCB slot fit test and measured PCB thicknesses
2026-11-12 Hold the ESP32 at its short ends
2026-11-12 Print PCB clips separately in keyed floor sockets; ESP32 short-end hold details
2026-11-12 Set PCB clearance to tallest underside part + 2 mm; plan clip trial
2026-11-12 Record XT30 fit test failure and measured connector size
2026-11-12 DE-9: male on the housing, mounted from the front
    The delivered panel connector is male; mount it with the flange
    outside so the mating connector seats fully. Remove the unused
    female NorComp reference model.
    [171-009-203.STEP]
2026-11-12 DE-9: female socket stays on the housing, flange flush in a front recess
    The delivered panel connector is the female socket (photo); keep the
    documented gender, restore its NorComp reference model and record
    the flush front recess.
    [171-009-203.STEP]
2026-11-12 DE-9: male connector on the housing after all
    The female photo was the wrong part; the housing connector is male.
    NorComp model kept as reference for the identical flange and rear side.
2026-11-12 Record DE-9 flange thickness and hole pattern
2026-11-12 Record insert fit test; assume standard DE-9 jackposts
2026-11-12 Add fit test 2: XT30 and DE-9 front-mount pieces, PCB clip trial
    [fit-test-2.3mf, fit-test-2.step]
2026-11-12 ESP32: fixed corner pockets and screwed keeper tabs
2026-11-12 Add ESP32 edge clearances from the CAD model
2026-11-12 Record measured ESP32 edge clearances
2026-11-12 ESP32 keeper tabs press along the USB-end edge strip
2026-11-12 ESP32 keeper tabs: M2.5 screws straight into PETG
2026-11-12 Fit test 2: add ESP32 holder, keeper tabs and M2.5 pilot-hole test
    [fit-test-2.3mf, fit-test-2.step]
2026-11-12 Fit test 2: print the XT30 and DE-9 pieces lying flat
    [fit-test-2.3mf, fit-test-2.step]
2026-11-12 Add independent Fusion mechanical fit coupons
    [esp32-holder.3mf, esp32-holder.step, front-plate.3mf, front-plate.step, rs232-holder.3mf, rs232-holder.step]
2026-11-12 Add ESP32 one-screw hold-down beam coupon
    [esp32-hold-down-beam.3mf, esp32-hold-down-beam.step]
2026-11-12 Center ESP32 hold-down beam and antenna-end slot
    [esp32-hold-down-beam.3mf, esp32-hold-down-beam.step]
2026-11-12 Support ESP32 across its bare underside
    [esp32-hold-down-beam.3mf, esp32-hold-down-beam.step]
2026-11-12 Reinforce and round ESP32 beam coupon
    [esp32-hold-down-beam.3mf, esp32-hold-down-beam.step]
2026-11-12 Open airflow beneath the ESP32 beam tray
    [esp32-hold-down-beam.3mf, esp32-hold-down-beam.step]
2026-11-12 Vent ESP32 tray floor and key the beam tongue
    [esp32-hold-down-beam.3mf, esp32-hold-down-beam.step]
2026-11-12 Reinforce ESP32 tray locating stops
    [esp32-hold-down-beam.3mf, esp32-hold-down-beam.step]
2026-11-12 Slim the ESP32 hold-down beam
    [esp32-hold-down-beam.3mf, esp32-hold-down-beam.step]
2026-11-12 Capture ESP32 beam with a tilted crossbar hook
    [esp32-hold-down-beam.3mf, esp32-hold-down-beam.step]
2026-11-12 Print the ESP32 beam hook on its side
    [esp32-hold-down-beam.3mf, esp32-hold-down-beam.step]
2026-11-12 XT30: glue holds it against plugging-in force
2026-11-12 Record DE-9 front-mount fit test
2026-11-12 DE-9 nut pocket 5.6 mm accepted
2026-11-12 Record M2.5 pilot hole: 2.2 mm
2026-11-12 Fit test 3: ESP32 holder v2 with shield bridge and one-screw USB keeper
    [fit-test-3.3mf, fit-test-3.step]
2026-11-12 Illustrate proposed bridge housing layout
2026-11-12 Fit test 3: separate glued shield clamp instead of the unprintable bridge
    [fit-test-3.3mf, fit-test-3.step]
2026-11-12 ESP32 holder v3: glued antenna cap and USB block with gluing jig
    [fit-test-3.3mf, fit-test-3.step]
2026-11-12 Fit test 4: RS-232 slot holder, printed standing
    Two variants (1.20 / 1.25 mm slot) of a slide-in holder that grips only the
    long edges beside the chip feet; both pad rows overhang in free air.
    [fit-test-4.3mf, fit-test-4.step]
2026-11-12 Remove the old RS-232 saddle coupon
    Superseded by the fit test 4 slot holder.
    [rs232-holder.3mf, rs232-holder.step]
2026-11-12 Remove the superseded ESP32 holder pieces from fit test 2
    [fit-test-2.3mf, fit-test-2.step]
2026-11-12 Clean up housing CAD: keep ESP32 holder and connector panel, drop old fit tests
    - fit test 3 becomes cad/housing/esp32-holder
    - front plate becomes cad/housing/connector-panel, updated to the measured
    XT30 pocket and 5.6 mm DE-9 nut pockets
    - fit-test coupon, fit test 2 and the mechanical-test coupons removed;
    their results stay in housing section 2.2 and a results table in 2.3
    - RS-232 holder (fit test 4) left untouched for its own session
    [connector-panel.3mf, connector-panel.step, esp32-hold-down-beam.3mf, esp32-hold-down-beam.step, esp32-holder.3mf, esp32-holder.step, fit-test-2.3mf, fit-test-2.step]
2026-11-12 Remove proposed housing illustrations
2026-11-12 ESP32 holder: raise the board seat 1 mm to clear the header solder tails
    Record the ESP32 and RS-232 holder fit results.
    [esp32-holder.3mf, esp32-holder.step]
2026-11-12 ESP32 holder: narrow the bridge 1 mm per side at the first header pins
    [esp32-holder.3mf, esp32-holder.step]
2026-11-12 Mark the bridge-to-pin clearance as a CAD estimate
2026-11-12 Keep the tested ESP32 and RS-232 holders with editable Fusion archives
    Add .f3d archives next to STEP and 3MF, move fit test 4 to rs232-holder
    with the selected 1.25 mm slot, and record both holders as selected.
    [esp32-holder.f3d, fit-test-4.3mf, fit-test-4.step, rs232-holder.3mf, rs232-holder.f3d, rs232-holder.step]
2026-11-12 Housing docs: replace the dropped snap-clip and hood-rib rules with dedicated holders
    Record the .f3d + STEP + 3MF file set in the CAD rule, fix the XT30
    capture description and close the measured XT30 open items.
2026-11-12 Perfboard: minimal board, RS-232 data lines bypass it
2026-11-12 Perfboard: wires soldered directly into the board
2026-11-12 Perfboard schematic: generated EAGLE .sch/.brd for Fusion Electronics
    Minimal board: 17 soldered wire landings and the five resistors
    (R-Z, R-F, R-B1, R-B2, R-D) on 8 nets, imported and checked in Fusion.
    [bridge-perfboard.brd, bridge-perfboard.sch]
2026-11-12 Drop the perfboard: resistors on module pads and ESP32 pins
    R-Z/R-F go from pad R1 to R3 on each RS-232 module, R-B2 across
    J3-12/J3-7, R-B1 in the RO wire and R-D from J3-11 to J2-1 in
    heat-shrink. Ground and supply wires each get their own ESP32 pin.
    Removes the perfboard schematic generator and files.
    [bridge-perfboard.brd, bridge-perfboard.sch]
2026-11-12 Diagrams: fix Becker DI label overlap, show resistors on modules and pins
    - Becker: DI arrow no longer under its label; pull-up note below the line;
    divider box names R-B1/R-B2; MAX490 VCC from the ESP32 5V pin.
    - Supply: MAX490 fed from J2-19; R-Z/R-F shown on the RS-232 modules.
    - Zander/FLARM: pull-up from pad R1 to R3 on the module.
    - Docs: supply alt text; continuity check before soldering R-Z/R-F.
    [diagrams.py]
2026-11-12 Diagrams: draw all five resistors as symbols
    Becker: R-B1 in the RO line, R-B2 from GPIO16 to GND, R-D from DI to the
    3V3 rail. Zander/FLARM: R-Z/R-F from pad R1 to the 3V3 line feeding R3.
    Adds an IEC resistor symbol to the generator.
2026-11-12 Supply diagram: draw R-D as a resistor symbol
2026-11-12 Ground loops diagram: bridge ground returns through the UBEC and XT30
    The ESP32 ground (J2-14) returns via the UBEC; the bridge ground wire
    leaves from the UBEC input through the XT30, as in the supply table.
2026-11-12 Signal overview: draw all five resistors as symbols
    R-Z/R-F from pad R1 to 3V3, R-B1 in the RO line with R-B2 to a ground
    symbol, R-D from DI to 3V3. Adds a ground symbol to the generator.
2026-11-12 Housing: select a narrow, long shape
2026-11-12 Housing: narrow, long shape is a direction, not a fixed rule
2026-11-12 Housing: start the Fusion layout with the connector side; F1 added last
2026-11-12 Housing layout: ESP32 and RS-232 holders placed in Fusion
2026-11-12 Housing layout: MAX490 board, UBEC and ferrite ring placed in Fusion
2026-11-12 Housing: record compact layout candidates v1 and v2
2026-11-12 Housing: select compact layout v2
2026-11-12 Housing: add layout candidate v3 with RS-232 slots in the ESP32 holder
2026-11-12 Housing v3: RS-232 slots side by side, ESP32 further back, narrower plate, XT30 collar unchanged
2026-11-12 Housing: select compact layout v3
2026-11-12 CAD: export selected layout v3 and ESP32 holder v2 as restore points
    [esp32-holder-v2.3mf, esp32-holder-v2.f3d, esp32-holder-v2.step, housing-layout-v3.f3d, housing-layout-v3.step]
2026-11-12 CAD layout v3: note that the f3d archive did not open in testing
2026-11-12 CAD layout v3: remove the f3d archive that crashed Fusion; keep STEP
    [housing-layout-v3.f3d]
2026-11-12 Housing: layout candidate v4 with RS-232 boards on the ESP32 USB clamp
    [esp32-holder-v3.3mf, esp32-holder-v3.f3d, esp32-holder-v3.step, housing-layout-v4.step]
2026-11-12 Housing v4: move the ESP32 assembly 10 mm away from the connector wall
    [housing-layout-v4.step]
2026-11-12 Housing: select layout v4; side walls 2.0 mm
    Remove the superseded layout v3 and ESP32 holder v2 copies (kept in Fusion and Git history).
    [esp32-holder-v2.3mf, esp32-holder-v2.f3d, esp32-holder-v2.step, housing-layout-v3.step]
2026-11-12 Holder v3: clamp arm into a U-channel on the antenna cap; round cap corners
    [esp32-holder-v3.3mf, esp32-holder-v3.f3d, esp32-holder-v3.step, housing-layout-v4.step]
2026-11-12 Holder v3: roof over the arm channel so it also holds the clamp arm from above
    [esp32-holder-v3.3mf, esp32-holder-v3.f3d, esp32-holder-v3.step, housing-layout-v4.step]
2026-11-12 Holder v3: arm tunnel gaps sized for print tolerances and spring-bridge lift
    [esp32-holder-v3.3mf, esp32-holder-v3.f3d, esp32-holder-v3.step, housing-layout-v4.step]
2026-11-12 Holder v3: 3MF with the clamp flipped to print top up
    [esp32-holder-v3.3mf]
2026-11-12 Holder v3: tighter arm tunnel (sides 0.25, back 0.2, roof 0.3 when fitted)
    [esp32-holder-v3.3mf, esp32-holder-v3.f3d, esp32-holder-v3.step, housing-layout-v4.step]
2026-11-12 Holder v3: record the passed fit test of the first print
2026-11-12 Housing body: base tray side walls 10 mm above the floor top
2026-11-12 Housing body: step-lip seam between hood and base tray
2026-11-12 Housing body: full-height corner posts for the cover inserts, XT30 moved inward
2026-11-12 Housing body: hood top over the connector wall, hanging post at the DE-9 corner
2026-11-12 F1 moves into the 12 V harness at its supply end
    A panel fuse holder does not fit the 12-16 mm free depth behind the
    connector wall; the harness fuse also protects the supply cable.
    [diagrams.py]
2026-11-12 Housing body: connector-wall labels 12V and INSTR
2026-11-13 Housing body: cable-tie ears off the short ends for 4.8 mm ties
2026-11-13 Housing body: no LED window; dedicated LED as a later option
2026-11-13 Housing body: 1.5 mm vent slots in two rows on the hood sides
2026-11-13 Housing body v1 prototype: base tray and hood on layout v4
    Fusion document "Housing body - prototype v1" (copy of layout v4, XT30
    moved 3.2 mm inward, ring placeholder 2 mm inward, holder v3 link
    updated). Exports: f3d, STEP and 3MF per part, two previews. Cover
    screws change to ISO 10642 countersunk M3x8.
    [housing-base.3mf, housing-base.f3d, housing-base.step, housing-hood.3mf, housing-hood.f3d, housing-hood.step]
2026-11-13 Housing body v1: compact cable-tie ears (6 x 10 x 2.5 mm)
    [housing-base.3mf, housing-base.f3d, housing-base.step]
2026-11-13 Housing body v1: dark green base, lighter green hood
    [housing-base.f3d, housing-base.step, housing-hood.f3d, housing-hood.step]
2026-11-13 Housing body v1: rounder corners (vertical R6, top edges R3)
    [housing-base.3mf, housing-base.f3d, housing-base.step, housing-hood.3mf, housing-hood.f3d, housing-hood.step]
2026-11-13 Housing body v1: debossed MomoRC logo on the hood, holder link broken
    Logo traced from the owner's bitmap, 56 mm, 0.6 mm deep, every feature
    at least 0.8 mm. The holder v3 derive stayed flagged out of date after
    Get Latest and a re-derive, so its pieces are now local copies (v7).
    [housing-base.f3d, housing-base.step, housing-hood.3mf, housing-hood.f3d, housing-hood.step]
2026-11-13 Housing body v1: dark grey logo in the previews
2026-11-13 Housing body v1: dark grey two-colour logo insert, 3MFs Z up
    The 0.6 mm logo recess now carries a matching insert body printed in
    dark grey. All 3MF files are re-exported with Z up (they were in the
    Y-up layout frame): base floor down, hood and logo insert top down in
    shared coordinates.
    [housing-base.3mf, housing-hood.3mf, housing-logo-insert.3mf, housing-logo-insert.f3d, housing-logo-insert.step]
2026-11-13 Housing body v1: counterbores for DIN 7984 low-head cover screws
    [housing-hood.3mf, housing-hood.f3d, housing-hood.step]
2026-11-13 Housing body v1: fix preview alt text for the counterbores
2026-11-13 Housing body v1: remove the flat pad at the XT30-corner screw
    [housing-hood.3mf, housing-hood.f3d, housing-hood.step]
2026-11-13 Housing body v1: flush DIN 912 cover screws, DE-9 and XT30 moved
    - Cover screws DIN 912 M3 x 6, heads flush in 6.0 x 3.1 counterbores
    - Hood top stays 2.5 mm; 4.6 mm thick spots hang down over the posts
    - Post tops lowered to 17.9, inserts 6.7 deep from there
    - DE-9 4 mm toward the XT30; DE-9 corner post now stands on the floor
    - XT30 1 mm further inward; its corner screw 5 mm from the side face
    - Exports and previews regenerated; housing.md cover rule updated
    [housing-base.3mf, housing-base.f3d, housing-base.step, housing-hood.3mf, housing-hood.f3d, housing-hood.step]
2026-11-13 Add NorComp 953-009-030R121 DE-9 backshell STEP reference (S52)
    [953-009-030R121.STEP]
2026-11-13 Replace 35° DE-9 backshell model with straight NorComp 973-009-010R011 (S52)
    [953-009-030R121.STEP, 973-009-010R011.STEP]
2026-11-13 Housing base: D-shaped DE-9 cutout, XT30 pocket follows chamfers
    - DE-9 cutout sides follow the 10° rear-body taper: 19.9 wide for the
    top 2.5 mm, 16.7 at the bottom, 0.25 clear (0.1 at the flange root)
    - XT30 pocket corners on the chamfered side filled 45°, legs 1.3,
    0.2 clear of the XT30 chamfers
    - Base exports regenerated; README and housing.md updated
    [housing-base.3mf, housing-base.f3d, housing-base.step]
2026-11-13 Housing base: hood seats only on posts and shoulder, hanging posts, XT30 low
    - Lip top, connector-wall top and the two corner ends set 0.25 mm back
    from the hood; the hood seats on the post tops and the wall shoulder
    - Corner posts hang from the walls: free faces end 8 mm above the
    floor, 45° underside toward the walls; free vertical edges R2
    - XT30 moved 8 mm down (body from Y 3.9), new collar standing on the
    floor with a 2 mm wall toward the corner post; chamfer fills redone
    - Label "7..20V" (4 mm) above the XT30 replaces "12V"
    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
    [housing-base.3mf, housing-base.f3d, housing-base.step]
2026-11-13 Housing base: 7..20V label readable from outside, previews refreshed
    - "7..20V" text flipped horizontally (it read mirrored from outside,
    like INSTR needed); base exports regenerated
    - Closed, open and top previews retaken with the low XT30 and new label
    [housing-base.3mf, housing-base.f3d, housing-base.step]
2026-11-13 Housing: engraved bold labels, 7-20V hood insert, preview in README
    - Wall labels engraved 0.6 mm in Arial Black: "7-20V" (3.6 mm) above
    the XT30, "INSTR" (4 mm) below the DE-9
    - "7-20V" (5 mm, Arial Black) on the hood top above the XT30 as part of
    the dark grey flush insert; hood has the matching 0.6 mm recess
    - Base, hood and insert exports regenerated in print orientation;
    previews retaken; closed preview added to the main README
    [housing-base.3mf, housing-base.f3d, housing-base.step, housing-hood.3mf, housing-hood.f3d, housing-hood.step, housing-logo-insert.3mf, housing-logo-insert.f3d]
2026-11-13 Housing base: tie loops blended into the side walls replace the ears
    - Four corner ears removed; floor corners back to the R6 outline
    - Four rounded tie loops on the long side walls (12 long, 4 out, to
    8.5 above the floor top, R1.5 outside and into the wall), each with a
    vertical 5.4 x 1.9 tunnel against the wall for 4.8 mm ties, corners
    R0.5 and rounded entries
    - Base exports regenerated (3MF floor down), previews retaken; housing
    rules, model README and open item updated
    [housing-base.3mf, housing-base.f3d, housing-base.step]
2026-11-13 Housing: XT30 and DE-9 connector wall print-test slices
    [de9-print-test.3mf, de9-print-test.step, xt30-print-test.3mf, xt30-print-test.step]
2026-11-13 Housing: close the XT30-corner counterbore with a wall rebate and hood fill
    The Ø6.0 counterbore at the XT30 corner cut 0.2 mm into the gap to the
    base side wall. The side wall top now has a 1.0 x 0.65 mm inner rebate
    there and the hood thick spot reaches down into it. Exports also carry
    the 0.2 mm insert-hole chamfers; print-test slices regenerated.
    [de9-print-test.3mf, de9-print-test.step, housing-base.3mf, housing-base.step, housing-hood.3mf, housing-hood.step, xt30-print-test.3mf, xt30-print-test.step]
2026-11-13 Housing: hood seats on the connector-wall and corner tops
    The flat tops of the connector wall and its two full-height corners rise
    0.25 mm to Y 20.0, flat against the hood top underside. Base exports and
    print-test slices regenerated.
    [de9-print-test.3mf, de9-print-test.step, housing-base.3mf, housing-base.step, xt30-print-test.3mf, xt30-print-test.step]
2026-11-13 Housing body v1: refresh base and hood Fusion archives
    [housing-base.f3d, housing-hood.f3d]
2026-11-13 Housing hood: round vent slot corners R0.5
    Fusion feature "Vent slot corners R0.5" on the hood (80 corner edges).
    Re-exported hood f3d, STEP and print 3MF (print orientation, top down).
    Docs updated.
    [housing-hood.3mf, housing-hood.f3d, housing-hood.step]
2026-11-13 Add AMASS XT30 connector family STEP models
    [XT30PB-F.step, XT30PB-M.step, XT30PW-F.step, XT30PW-M.step, XT30U-F.step, XT30U-M.step]
2026-11-13 Index CAD model credits and reuse terms
2026-11-13 Housing body: widen the MAX490 side 3 mm, centre the logo
    Base and hood are 3 mm wider on the +Z (MAX490) side: outside 92 x 67,
    75 over the tie loops. Corner posts, inserts, counterbores, vents and
    tie loops on that side moved with the wall; the -Z side is unchanged.
    The MAX490 board and UBEC sit 3 mm further out. The logo recess and
    insert moved 1.5 mm so the logo stays centred on the hood.
    Fusion checks: volume change equals the filled gap exactly, -Z faces
    unchanged, no new clashes. Preview PNGs not refreshed.
    [housing-base.3mf, housing-base.f3d, housing-base.step, housing-hood.3mf, housing-hood.f3d, housing-hood.step, housing-logo-insert.3mf, housing-logo-insert.f3d]
2026-11-13 Add a Haiku committer subagent
    Project subagent that reviews the diff, stages only the task's files,
    commits, rebases onto origin/main when nothing overlaps and pushes.
    It stops and reports on unexpected files, private data, conflicts or
    hook failures, and never force-pushes or discards changes.
2026-11-13 Replace NorComp D-sub STEP models with renamed copies
    Store the DE-9 female plug and straight backshell as
    cad/reference/dsub-9pin/DSUB_9pin_female_plug.STEP and
    DSUB_9pin_backshell.STEP. Geometry is identical; only the file names,
    header metadata and part names differ. Rename the embedded plug part in
    the layout-v4 STEP the same way and update links, credits and S43/S52.
    [171-009-203.STEP, DSUB_9pin_backshell.STEP, DSUB_9pin_female_plug.STEP, housing-layout-v4.step]
2026-11-13 Housing markings: scale text to 60 % and add WIFI Bridge insert
    - Set the text size rule to 60 % of the first sizes, for new text too:
    hood "7-20V" 3 mm, front plate "7-20V" 2.16 mm, "INSTR" 2.4 mm.
    - Add a black two-colour "WIFI Bridge" insert on the hood top (Arial
    bold, 3 mm) along the far short edge, next to the hood "7-20V" insert.
    - Update the housing body v1 checklist to match.
    Verified: Fusion model updated to match; timeline healthy apart from the
    old Position19/20 snapshots. git diff --check clean. Documentation-only
    change; no print test.
2026-11-13 Move hood 7-20V label beside the corner screw
    Move the hood "7-20V" text toward the connector-end edge, beside the
    corner screw, and reduce it to 3 mm (recess and insert sketches).
    Re-export the hood and logo-insert f3d/step/3mf from Fusion. The
    exports also include the 60 % text size and WIFI Bridge insert from
    the previous commit.
    Verified: 3MF hood bounds match the previous export, git diff --check
    clean, top-view screenshot checked. Not tested: no print test.
    [housing-hood.3mf, housing-hood.f3d, housing-hood.step, housing-logo-insert.3mf, housing-logo-insert.f3d, housing-logo-insert.step]
2026-11-13 Note XT30 female plug on the housing body model
    The Fusion model now shows the XT30PB-F reference plugged onto the XT30 on the outer connector wall face; recorded in the housing body README.
    Verified: Fusion intersection check (0 mm3 against base, hood, plate, DE-9, XT30 male); docs-only change.
2026-11-13 Record XT30 female plug orientation in the housing body README
    The plug is turned 180 degrees about its axis to match the male polarity (owner correction in Fusion).
    Docs-only change; no tests run.
2026-11-13 Add the measured UBEC Fusion model
    Preserve the measured PCB and cover and the final wire and jumper positions as a native Fusion archive. Credit the original CAD source in the reference README.
    Verified by reopening the archive in Fusion and comparing the geometry and placement of all 17 occurrences.
    [ubec-measured.f3d]
2026-11-13 Export the housing assembly with measured power components
    Include the measured UBEC and ferrite ring and embed the MAX490 board so the full Fusion assembly opens without external references. Record the dimensions and remaining wire clearance checks.
    Verified the MAX490 placement and all 150 bodies after unlinking. Reopened the archive in Fusion and matched all 65 occurrences and 188 timeline entries. Checked documentation links and whitespace.
    [housing-assembly.f3d]
2026-11-13 Add the four-screw UBEC carrier and MAX490 floor posts
    Model a 1.5 mm carrier with 19 mm support, open solder-clearance ends,
    two cable-tie paths and lowered seats for raised-head M2.5 screws.
    Raise the UBEC for 2 mm nominal hood clearance and add the shared
    MAX490 floor posts. Export the carrier, base and assembly and document
    assembly, print orientation and remaining fit checks.
    Verified Fusion feature health, targeted interference checks, reopened
    archives, matching assembly body geometry, closed print meshes and bed
    orientation. Checked 166 local documentation links and whitespace.
    Physical fit and support-free printing still need a print test.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
    [housing-assembly.f3d, housing-base.3mf, housing-base.f3d, housing-base.step, ubec-carrier.3mf, ubec-carrier.f3d, ubec-carrier.step]
2026-11-13 Open the carrier screw seats and fillet the MAX490 posts
    Remove the pointed pocket lips from all four carrier seats, add R1
    fillets at the two inner post roots, and remove the four screw reference
    solids while retaining the cable ties. Refresh the carrier/base exports,
    assembly archive, previews and documentation. Require print supports
    under the now-projecting screw-seat pads.
    Verified new Fusion feature health, unchanged holes and bearing pads,
    fillet clearance, reopened archives and matching assembly geometry,
    closed print meshes, bed placement, native previews and 148 local links.
    Document inherited standalone-base engraving warnings. Physical fit and
    slicing remain pending; raised scre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
    [housing-assembly.f3d, housing-base.3mf, housing-base.f3d, housing-base.step, ubec-carrier.3mf, ubec-carrier.f3d, ubec-carrier.step]
2026-11-13 Record the 12 mm carrier screw and blind-hole floor selection
    Record the selected M2.5 x 12 screws and 0.4 mm closed floor, with the
    flush-seat stack calculation. Keep current exported geometry distinct
    from the selected revision and queue the actual head-diameter check
    before changing the CAD.
    Verified the live CAD dimensions, screw-stack arithmetic, 146 local
    links and whitespace. No CAD changes or physical tests in this package.
2026-11-13 Raise the carrier seats and offset the shared 12 mm screws
    Raise all four seats flush, offset carrier holes and floor pilots
    0.2 mm outward, and enlarge the posts to 6.6 mm. Use 6.6 mm-deep
    pilots with 0.4 mm closed floors for the selected M2.5 x 12 screws.
    Retain the PCB/UBEC positions, R1 roots, ties and omitted screw solids.
    Refresh CAD exports, print meshes, previews and builder documentation.
    Verified feature health, 480 unchanged unrelated bodies, added-material
    and screw-head clearances, reopened archives, STEP imports, closed
    meshes and bed orientation. Checked 167 links and whitespace. Existing
    standalone-base engraving warnings are documented; slicing and physical
    fit remain pendi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
    [housing-assembly.f3d, housing-base.3mf, housing-base.f3d, housing-base.step, ubec-carrier.3mf, ubec-carrier.f3d, ubec-carrier.step]
2026-11-13 Record the upright ferrite cradle and measured winding envelope
    Select an integral base cradle with two 2.5 mm ties and record the owner-measured 17.5 mm diameter and 9.5 mm thickness. Replace the provisional envelope and track tie routing before CAD implementation.
    Verified a transient envelope against nearby Fusion geometry, 152 local links and anchors, documentation consistency and whitespace. No CAD changes, slicing or physical retention tests.
2026-11-13 Record ESP32 Wi-Fi link monitoring requirement
    Add P1 requirement R10 and schedule assessment of metrics and reporting in WP6. Record ESP-IDF evidence for signal strength and connection events.
    Verified source support, requirement and roadmap references, and whitespace. Documentation only.
2026-11-13 Add an integral ferrite cradle with two through-centre ties
    Support the upright core in a rounded saddle with two above-floor tie tunnels. Position the ring for its measured winding envelope, add tie fit envelopes, and retain the original housing floor. Refresh the base and assembly exports, native previews and builder notes.
    Verified Fusion recompute, 480 unchanged unrelated bodies, ring/tie clearances, zero removed base material, reopened archives, STEP validity and tunnel checks, closed print mesh and bed placement, 183 documentation links and whitespace. Existing engraving reference warnings remain documented. Physical fit, slicing, retention and vibration remain untested.
    Co-authored-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
    [housing-assembly.f3d, housing-base.3mf, housing-base.f3d, housing-base.step]
2026-11-13 Keep the ferrite export separate from concurrent UBEC tie edits
    Use the verified 309-entry assembly archive. A later live Fillet1 on the UBEC tie references entered the final refreshed export; leave that separate edit untouched in Fusion and outside this work package.
    Reopened the replacement archive and confirmed 309 timeline entries ending at the second ferrite tie head. The earlier 484-body geometry comparison applies to this exact archive. Whitespace check passed.
    [housing-assembly.f3d]
2026-11-13 Record clipped ESP32 headers in the housing assembly
    Trace the clipped pins and notched spacers to three UBEC carrier cuts and track restoration and clearance checks in WP3. Compare both intact STEP references with live Fusion body geometry and feature faces. Verify documentation links and whitespace. Physical fit was not tested.
2026-11-13 Restore intact ESP32 headers in the housing assembly
    Limit the three UBEC clearance cuts to the carrier and refresh the open assembly preview. Close the CAD repair item and retain the evidence in the source register.
    Reopen and recompute in Fusion, match 76 header bodies to the intact archive and 402 other bodies to the published assembly, verify carrier solid equivalence, and check 128 candidate interferences. Verify updated documentation links and whitespace. Physical fit and wire clearance remain untested.
    [housing-assembly.f3d]
2026-11-13 Require explicit body targets for Fusion cuts
    Keep board references embedded in the standalone housing and require explicit cut targets when creating or editing Fusion cuts.
    Reviewed the instructions against the current assembly workflow and checked whitespace.
2026-11-13 Integrate the ESP32 USB support into the base tray
    Remove the broad glue foot and join local supports for the USB screw boss, PCB ledge and end stops to the tray. Refresh the housing archive, base exports, open preview and fit notes. Keep concurrent UBEC edits in the separate live assembly.
    Verified Fusion recompute, matching unrelated bodies, reopened archives, a valid STEP solid with eight point checks, and a closed bed-oriented 3MF. Checked documentation links and whitespace. Physical fit and thread holding remain pending.
    [housing-assembly.f3d, housing-base.3mf, housing-base.f3d, housing-base.step]
2026-11-13 Record the widened ESP32 seating ledge
    Document the 12 mm ledge and both floor-supported connections in the saved Fusion design. Verify the save and reopen the local archive to compare body geometry and component placements. Keep the live archive with the concurrent UBEC edits local.
2026-11-13 Model floor-routed power and resistor harness
    Add a hideable power/resistor routing study with provisional 1.5 mm power
    and 1.0 mm signal outside diameters, plus two integral cable saddles.
    Preserve and publish the owner's existing base, carrier and tie edits.
    Update CAD exports, native previews, route lengths and fit-review items.
    Verify complete wire sweeps, intended contacts, carrier driver clearance,
    476 unchanged pre-existing bodies and additive-only base changes. Reopen
    archives and STEP exports, check closed bed-oriented meshes, and validate
    193 local documentation links. Record tight clearances, provisional bends
    and outstanding physical checks. No firmware or aircraft work performe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
    [housing-assembly.f3d, housing-base.3mf, housing-base.f3d, housing-base.step, ubec-carrier.3mf, ubec-carrier.f3d, ubec-carrier.step]
2026-11-13 Record OpenSoar G-load research
    Document the live G display, calculation inputs, candidate sensor feed and IGC limits. Verify pinned source paths and line ranges and check the documentation diff.
2026-11-13 Add central power junctions and RS-232 supply chains
    Route separate 5 V and ground junction branches to ESP32 and MAX490,
    with an ESP32-fed 3.3 V/ground daisy chain through the RS-232 boards.
    Reserve junction hardware space and apply black, red and orange net
    colors. Update the assembly, route evidence, previews and wiring diagrams.
    Preserve existing housing geometry and concurrent source-register work.
    Verify all 520 body records after reopening the saved Fusion export,
    retained geometry, new-route contacts, driver clearance and internal
    ground-tree topology. Check 297 local documentation links and offline
    renders of eight generated SVGs. Browser local-file preview was blocked.
    Junction ha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
    [housing-assembly.f3d]
2026-11-14 Correct XT30 polarity and RS-232 power pad routing
    Match XT30 red/black wires to the molded positive/negative marks and
    UBEC reference leads. Move both RS-232 supply chains and pull-up
    assemblies to the marked power pad row while preserving board placement.
    Update routing lengths, evidence, close-up previews and housing notes.
    Record the remaining inferred signal-map continuity check.
    Verify all 520 bodies after reopening the saved Fusion archive and all
    506 unaffected bodies against the baseline. Check corrected contacts,
    carrier driver clearance, six pad endpoints and all 25 sweep lengths.
    Check 172 local documentation links and whitespace. Physical polarity,
    continuity, wire bends and fi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
    [housing-assembly.f3d]
2026-11-14 Document connector routing tradeoffs and RS-232 pad checks
    Explain the shared supply pads and require unpowered continuity checks on both boards. Record the connector swap evaluation and align housing label dimensions with the saved Fusion model.
    Verify terminal and jackpost geometry in Fusion v76, review the documentation diff, and check 234 local links and anchors plus whitespace. Physical fit and continuity checks remain open.
2026-11-14 Lower the housing floor and widen the MAX490 side
    Add 3 mm below both PCB stacks and 3 mm between them. Preserve connector and roof height, shift the MAX490 stack and ferrite with the wall, and update the routing envelopes, CAD exports, meshes and housing notes.
    Verify the saved Fusion assembly on reopen, enclosure and driver clearance, STEP solids, closed mesh edges, local links and whitespace. Physical fit and continuity remain open.
    [housing-assembly.f3d, housing-base.3mf, housing-base.f3d, housing-base.step, housing-hood.3mf, housing-hood.f3d, housing-hood.step]
2026-11-14 Document the selected DE-9 instrument pinout
    Record all nine contacts and the mating-face orientation. Add the bench continuity check and keep connector parts and fit in open item 14.
    Verify the pin mapping, bench step order, 62 local links and anchors, and whitespace. Physical fit and continuity remain pending.
2026-11-14 Align DE-9 routing notes with the selected pinout
    Update the housing and routing references and spell out the end-to-end continuity check for the instrument harness.
    Verify that the pinout and orientation match b90e02b byte for byte. Check JSON scope, 117 local links and anchors, and whitespace. Physical fit and continuity remain pending.
2026-11-14 Isolate the ESP32 and RS-232 holder stack
    Give the two printed holders independent local solids and constrain the installed stack to the base tray while keeping the board references embedded.
    Verify all 75 occurrence transforms and 520 body fingerprints before and after the edit. Reopen and recompute the standalone v79 archive and check the documentation links.
    [housing-assembly.f3d]
2026-11-14 Isolate the MAX490 and UBEC stack
    Group the MAX490 board, carrier, measured UBEC and tie envelopes. Constrain the stack to the pinned tray while preserving the carrier history and embedded references.
    Compare all 75 existing placements and 520 solid fingerprints. Reopen and recompute the saved v80 archive and verify the documentation links.
    [housing-assembly.f3d]
2026-11-14 Mark the wiring design as in progress
    Align the overview, WP3 roadmap, and signal wiring page with the outstanding design decisions. Point readers to the existing open items and keep bench checks visible.
    Verified relative links, anchors, and Git whitespace checks.
2026-11-14 Evaluate a centre-floor guide for the power wiring
    Track the centre-floor guide as the next WP3 decision and record the Fusion v80 clearance study, including the ferrite-end obstruction.
    Verified the envelope in Fusion and checked documentation anchors and whitespace.
2026-11-14 Put power and ground routing before cable retention
    Schedule the overall harness layout first and record staggered guide fingers as a later option.
    Verified WP3 ordering, open-item references, and whitespace.
2026-11-14 Defer generic Fusion rules to the workflow skill
    AGENTS.md repeated the cut-target rule that the momorc-fusion360-workflow
    skill now covers. Point Fusion work at the skill and keep only the
    project-specific rules (embedded board references, save before export),
    which take precedence over the skill.
    Verified: diff limited to AGENTS.md, no whitespace errors, list
    indentation renders as a nested list.
    Claude-Session: https://claude.ai/code/session_01NVrJkmivgWq2EPb7H3UzfJ
2026-11-14 Require the Fusion workflow skill before Fusion edits
    Fusion rules now live mainly in the momorc-fusion360-workflow skill, so
    an agent without it would miss the cut-target and verification rules.
    AGENTS.md now names the skill's repository, requires a check that it is
    installed before any Fusion edit, and says to install it or ask the
    owner instead of working without it.
    Verified: diff limited to AGENTS.md, no whitespace errors.
    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
2026-11-14 Check the inboard XT30 power route
    Record the proposed inboard path and Fusion clearance checks for the approach, rise, and crossing.
    Checked three temporary envelopes for solid overlap and reviewed the documentation diff and whitespace.
2026-11-14 Plan base-plate routing for the ferrite leads
    Record the floor-level 5 V and return runs on both sides of the ferrite after the XT30 input route.
    Checked roadmap references and Git whitespace.
2026-11-14 Model inboard power and floor-level ferrite routing
    Add a standalone Fusion assembly with six revised power wire envelopes and document their paths and remaining physical checks.
    Checked solid overlaps, carrier screwdriver access, recompute, and archive reimport against the baseline.
    [housing-power-routing.f3d]
2026-11-14 Keep wire colours consistent across resistor branches
    Use one colour for both leads of each branch and match the junction envelopes to their rails.
    Reopened the Fusion export and verified the five resistor pairs, junction colours, geometry, and component positions.
    [housing-power-routing.f3d]
2026-11-14 Plan RS-232 and MAX490 logic routing
    Record signal paths, clamp retention options, and the checks needed before wiring the delivered boards.
    Verified existing pin references, documentation anchors, and whitespace.
