MomoRC-tech/Becker-AR6201-to-OpenSoar/(notices)

Notices in the files:
cad/reference/kicad-din0204/R_Axial_DIN0204_L3.6mm_D1.6mm_P5.08mm_Horizontal.step:
Copyright (C) 2017, kicad StepUp
This work is licensed under the [Creative Commons CC-BY-SA 4.0 License](https://creativecommons.org/licenses/by-sa/4.0/legalcode),
with the following exception:
To the extent that the creation of electronic designs that use 'Licensed Material' can be considered to be 'Adapted Material',
You are free to use the library data in your own projects without the obligation to share your project files under this or any other license agreement.
docs/sources.md:
| Littelfuse [Fuseology Design Guide](https://www.littelfuse.com/assetdocs/fuseology-selection-guide?assetguid=d812dff2-1c47-4dc3-bce7-07a4001ddc32), ©2022, Fuse Selection Checklist and pulse sections; [ATOF datasheet](https://www.littelfuse.com/assetdocs/littelfuse-datasheet-287-atof?assetguid=43dc
